zoubworldArduino/KiCad_PersoLibrary/SparkFun-KiCad-Libraries-main/SparkFun_GNSS_LG290P_Breakout_3D.png

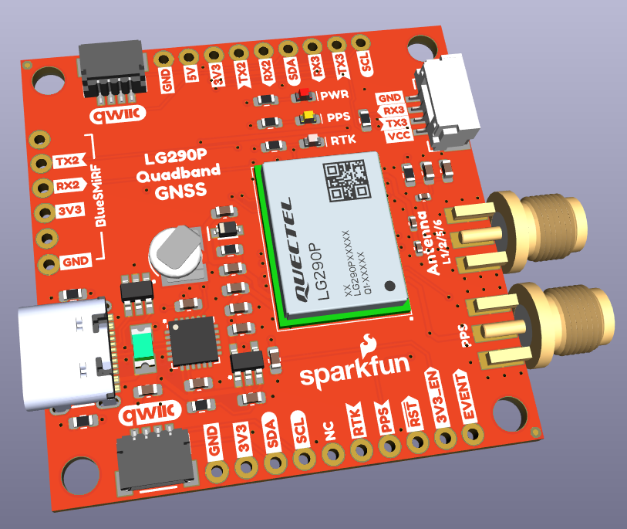
SparkFun-KiCad-Libraries-main/SparkFun_GNSS_LG290P_Breakout_3D.png
