zoubworldArduino/KiCad_PersoLibrary/README.md

# KiCad_PersoLibrary
my personnal Kicad library

# KiCad
KiCad Projects

the data here are imported from several location, mainly :
https://www.ultralibrarian.com/
https://www.snapeda.com/
github and kicad.
