zoubworldArduino/KiCad_PersoLibrary/Zoub_Lib/ATWINC3400/MicrochipWirelessHardwareDesignChecklist_Rev-B.xlsx

Sheet: Checklist
Microchip Wireless Hardware Design Checklist
Introduction: This checklist is provided as a "Best Pratice" guide for your RF design. It can be used as-is or as part of our free design review service called WirelessCheck. If you would like use this value added service, please click here->. |  |  |  |  |  |  | Link to WirelessCheck (https://www.microchip.com/design-check-services)
Instructions for WirelessCheck Customers: Fill in "Customer" column for all checkpoints during the design phase and prior to requesting design review support from Microchip. While raising design review support request, attach the completed checklist along with the design files (Schematic, BoM, PCB Layout File, Gerber files). A Microchip Support Engineer will review and provide his/her comments in the "Microchip" column and communicate this back to you.
Instructions for as-is useage: Fill in "Customer" column for all checkpoints during the design phase. This will provide you with a checklist of typical areas of concern for your RF design and some suggestions on best practices from Microchip RF Engineers.
S.No. | Design Item | Description | Customer |  | Microchip |  | Customer
 |  |  | Verified (Yes/No/NA) | Comment if any | OK/NOT OK | Microchip Review Comments | Response for Review Comments
1 | General Considerations:
1.1 | Documentation | Did you refer the latest version of the documents for the design such as Silicon chip/Module datasheet, Errata and Reference/Evaluation kit design documents, chip-down collateral package (for chip-down design)?
1.2 | Device (Silicon Chip/Module) | Is the device ordering part number used in the design BoM verified?
1.3 | Reference Design File | Microchip Wireless Reference PCB design files will be mostly in Altium Tool format. Customer should convert into their other CAD tools if needed.
1.4 | Pin check | Is the pinout of the schematic logical symbol against the data sheet verified?
1.5 | Footprint Check | Is the PCB footprint of the silicon chip/module verified against the package outline drawing or recommended footprint/land pattern drawing detailed in the data sheet? It is recommended to use the same footprint as in the reference design.
2 | PCB Stack Up Considerations:
2.1 | PCB Stack up | Use the same PCB Layer Stackup as in the reference design. If in case following a different PCB layer stackup to meet the custom design requirement, confirm the following items before the start of the design • Check with PCB Fabrication Vendor for the manufacturability of the stackup. • Ensure to follow a good reference plane for RF ground and Digital/Analog Ground plane and other high speed design requirements. • Check the controlled trace impedance requirements for the design and get the required trace width and spacing details from the PCB Fabrication Vendor.
3 | Power Supply Considerations:
3.1 | Power Supply Pins | Do all the power pins connected to the correct supply rails in the design and it is within the required tolerance value as detailed in the datasheet?
3.2 | Power Supply Source | Is the power supply source clean without any noise? Note: It is recommended to use LDO. If you are using the switching regulator, ensure that the sufficient filtering are added to suppress the switching noise (ripple) on the power rail as it impacts the RF performance.
3.3 | Power Budgeting | Is the power budgeting performed to ensure the power source component capable to supply the required current to the circuit in all functional conditions?
3.4 | Power Trace | Is the power rail trace thickness/width selected appropriately based on the expected peak power consumption, with certain margin? Use a power trace calculator to find the minimum required trace width. PCB Trace Width Calculator (For Reference): https://www.desmith.net/NMdS/Electronics/TraceWidth.html
3.5 | Ground | Do the grounding specification followed as in the datasheet or in the corresponding silicon chip/module reference/evaluation design kit? It is preferred to use simple solid ground plane unless otherwise specified.
3.6 | Power Sequencing | Did you check the device (silicon/module) requires any specific power up/down sequencing in terms of the order and delays of the power supplies?
3.7 | Thermal Pad /Ground Paddle | Did you check whether the device (silicon chip/module) require thermal pad ground connection? Note: Ensure that an array of GND vias connecting the thermal pad to the ground plane has sufficient low impedance ground return path which provides a better ground to the device and also acts as thermal sink. Also, connect the GND pin to the GND Paddle for better grounding in addition to the separate ground via.
3.8 | Ferrite Beads | Did you verify whether the ferrite beads placed in the design as specified in the recommended power pins of the silicon chip/module? Note: Place the ferrite beads as close as possible to the power pin.
3.9 | Bulk Capacitors | Did you verify whether the recommended bulk capacitors placed on the power rails of the design? Refer the Datasheet and/or reference design document for the recommended values.
3.10 | Decoupling/Bypass Capacitors | Did you verify whether the recommended decoupling capacitors placed on each power pins in the design? Refer the Datasheet and/or reference design document for the recommended values. Note: Ensure that the decoupling capacitors are effective at Radio Frequencies. Many passive capacitors are self-resonant at RF, therefore review S21 plots and frequency response curves. It is recommended to use COG and avoid Y5V and Z5U dielectric type capacitors.
3.11 | Placement & Routing | a. Prioiritze the placement and routing in the following order, (i) RF Section (ii) Buck or Boost LC Section (iii) Clock Section (iv) High Speed Signals (v) Other Power Section (vi) and finally low priority section placement and signals. b. Did you place the decoupling capacitors close to the power pins for high-frequency noise filtering? Note: Refer "Reference" worksheet Image-1 for the recommended decap routing. c. Did you verify whether each Ground pin have at least one ground via? d. Did you place vias very close to the power pads to connect the power/ground pins to the power/ground plane? This helps in minimizing stray inductance and IR (voltage) drop on the power line. e. Did you place multiple vias when Power trace/island changes the plane for current distribution?
3.12 | Copper Pour | Did you eliminate Island (Unconnected or floating or Dead) Copper Pour amd peninsulas of copper pour? Note: Refer "Reference" worksheet, Image-3 and Image-4 to know more about Island/s and peninsula/s.
4 | Reset and Chip Enable Considerations:
4.1 | Reset | Did you verify the connection and pullup/pulldown recommendation for the RESET pin in the datasheet?
4.2 | Chip Enable | Did you verify the connection and pullup/pulldown recommendation for the Chip Enable pin in the datasheet?
5 | Clocking Considerations:
5.1 | Clock Source | Recommend to follow the same clock source part (Crystal/TCXO) as in the reference design. As the clock parameters directly impact the RF performancem, customer should understand the impact on the performance involved if using different clock source part.
5.2 | Clock Trace Routing | a. Are the clock traces routed away from RF signals? b. Are the guarding ground vias placed along the crystals and the clock traces?
6 | I/O's:
6.1 | Pullups/Pulldowns | Are the recommended pullup and pulldown resistors placed on the I/O's with the suggested values as listed in the datasheet or reference design?
6.2 | Application Interface | Are the mandatory interfaces connected to communicate with the device (silicon chip/module) for the end application requirement?
6.3 | Impedance controlled trace | Is the impedance control requirement verified? Note: Unless otherwise stated, the single ended trace impedance should be 50Ω , differential trace impedance of USB should be 90Ω and other differential trace impedance should be 100Ω. Refer Device Datasheet and its design guide. Use an impedance calculator to calculate the trace width for a specific trace impedance. Check with fab house to optimize the materials and controlled impedance. Request for a TDR (Time Domain Reflectometry) test to the PCB fabricator for QA.
6.4 | Signal integrity | Did you complete the Signal integrity check such as, trace length match, impedance control requirements, proper termination requirement for the critical highspeed signals? Refer the reference kit design document for cross verification.
6.5 | Debug Interface | Did you check the required programming and debug interfaces like JTAG,SW? Ensure to expose the traces for debug.
6.6 | Test Interface | Did you check whether any dedicated test interface requires to communicate with the RF transceiver to perform RF level test such as, continuous Tx, Rx with Tx power control, channel selection, data rate selection for RF Validation, Regulatory Certification, and Production testing?
6.7 | Unused pins | Does all unused inputs terminated as recommened in datasheet?. Refer the evaluation kit design document and datasheet guidance.
6.8 | Test coverage | Did you check whether every (maximum possible) trace have a touch-down point (open solder mask on the via or some passive component pads apart from IC pads) for continuity testing in PCB manufacturing?
7 | RF Design Considerations:
7.1 | Module Based Designs - RF Design Considerations:
7.1.1 | Module Placement | Is the module placed in the base board as per the datasheet recommendation for best RF performance case? Refer "Reference" worksheet -> FCC KDB : Reference-1 for the FCC Guidance
7.1.2 | Mechanical Cutout/Slot | Did you verify the host board for mechanical cut out/slot area requirement? Refer module datasheet recommendation.
7.1.3 | Electrical Keep out Area | Did you check the host board copper keep out area requirement for the Top placement layer and all other PCB layers? Refer the module datasheet for the recommendation. Note: Ensure that no traces/metal structures are placed under antennas.
7.1.4 | GND Shielding and Stitching Vias | Are the sufficient GND area, fences/stitching vias for RF traces placed? Refer "Reference" worksheet Image-2 for the proper "via" stitching fences.
7.1.5 | Clearance | Is the minimum clearance requirement verified? • Antenna on the module must not be placed in direct contact or close proximity to plastic casing/objects. • Do not enclose the antenna within a metal structure.
7.1.6 | External Antenna (Applicable for only a module with external antenna connector) | Did you use the same antenna as specified in the Microchip Module certification test report? Note: If different antenna is preferred to use, refer to Q&A especially section III, B, C and D of FCC KDB (https://apps.fcc.gov/oetcf/kdb/forms/FTSSearchResultPage.cfm?switch=P&id=39060) for to use the Microchip regulatory compliance certification of the module.
7.2 | Chip-down Based Designs -RF Design Considerations:
7.2.1 | RF Front End Components and PCB layout. | Did you use the same RF front end design as specified in the reference design (Module design/Evaluation Kit)? Note: It is recommended to use the RF front end components and PCB Layout "AS IS" in the reference design (Module design/Evaluation Kit) to achieve the target RF Performance. Any deviation leads to degradation in RF performance.
7.2.2 | RF trace - Impedance control | Is the impedance control requirement verified for RF traces? Note: Unless otherwise stated, all the single ended RF trace impedance should be 50Ω and differential RF trace impedance should be 100Ω. Refer Device Datasheet and its design guide.
7.2.3 | Balun | Did you use the same balun circuitry as in reference design (Module design/Reference kit)? Note: All RF currents flow though the Balun. Make sure balun ground connections are solid.
7.2.4 | Filtering | Did you follow the same filtering circuitry as in reference design (Module design/Reference kit)? Note: It is recommended to use High-quality passive components in the RF signal chain and filtering.
7.2.5 | Antenna | Is the same antenna as in reference design (Module design/Reference kit) used? Note: The antenna can be either PCB antenna or Chip Antenna or some external antenna such as U.FL Antenna, SMA antenna. Customer can use different antenna but ensure that it matches the frequency requirement of the radio transceiver, proper antenna length relative to wavelength used for good radiation efficiency, radiation pattern and other antenna parameters. Using different antenna might lead to the degradation of the overall system RF performance when compared to the module.
7.2.6 | Antenna Matching Circuitry | Did you follow the same antenna matching circuitry as in reference design (Module design/Reference kit)? Note: Impedance matching components helps to achieve maximum power transfer from the Transmitter by reducing mismatch loss.
7.2.7 | RF Test Point | Did you use the RF Coax probe point (test point or connector such as U.FL or SMA or RF switch connector) to perform conducted testing in the regulatory and production test?
7.2.8 | RF Shield | Does your design includes RF Metal Shield? Note: If the design does not have RF metal shield, ensure that at least the design has a placeholder for the RF shield which covers the chip and its related components. This EMI/RF Shield is to ensure compliance to Emission and Immunity rules.
7.2.9 | RF Clearance | a. Did you verify the clearance requirement between the following? - RF Shield and other components - RF Shield and PCB edge b. Did you verify the vertical clearance of archway over RF transmission lines?
7.2.10 | Electrical Keep out Area | Did you check the antenna specification requirement for the copper keep out area requirement for Top PCB layer and all other PCB layers?
7.2.11 | GND Shielding and Stitching Vias | Did you place the sufficient GND area, fences/stitching vias for RF traces? Refer "Reference" worksheet Image-2 for the recommended "via" stitching fences.
8 | Miscellaneous
8.1 | Keep out Clearance | Is keep-out areas free from stickers, metal symbol and QA marks?
8.2 | Labeling | Does the design has a designated label area? Note: Label lead-time can be very long.
8.3 | Netlist comparison | Is a manual netlist check is run against the schematic? Note: This netlist check helps to identify the typos and accidental disconnects.
8.4 | CAD DRC Check | Does CAD DRC check is run to review/resolve all the DRC errors?
8.5 | CAD layer view | Is explicit (positive image view) style used for the GND and Power planes? Note: Avoid invisible implicit (negative image view) ground style.

Sheet: Reference
Image-1: | Decap Placement and Routing Recommendation
Image-2: | Recommended "Via" Stitching Fences
Image-3: | Unconnected or floating or Dead Copper Pour (Island)
Image-4: | Copper Pour - Peninsula
FCC KDB : Reference-1
KDB Publication 996369: FCC Link : https://apps.fcc.gov/oetcf/kdb/forms/FTSSearchResultPage.cfm?switch=P&id=44637 Question: What is the FCC guidance for equipment authorization of transmitter module devices, and equipment that incorporates transmitter modules? Answer: 996369 D01 Module Certification Guide v02. Provides guidance for equipment authorization applications for modular transmitters per Section 15.212. 996369 D02 Module Q&A v01. Provides additional guidance in a question and answer format. 996369 D03 OEM Manual v01 — Guidance for instructions provided by grantees to host manufacturers. * 996369 D04 Module Integration Guide v01. Guidance to host manufacturers for integrating modules into their products. Attachment List: 996369 D01 Module Certification Guide v02 996369 D02 Module Q&A v01 996369 D03 OEM Manual v01 996369 D04 Module Integration Guide v01 FCC expects all integrators to do a small subset of testing to ensure their use of the Module does not exceed FCC limits/requirements.

Sheet: Revision History
Revision History
Revision | Change Description | Date
A | Initial Released Revision | 2018-11-20
B | Included information about WirelessCheck and implemented improvements on the checkpoints | 2020-07-15
