zoubworldArduino/KiCad_PersoLibrary/Raspberry_Pi_Pico_W_Kicad_Files-main/images for README/KiCad 6 symbol libraries.png

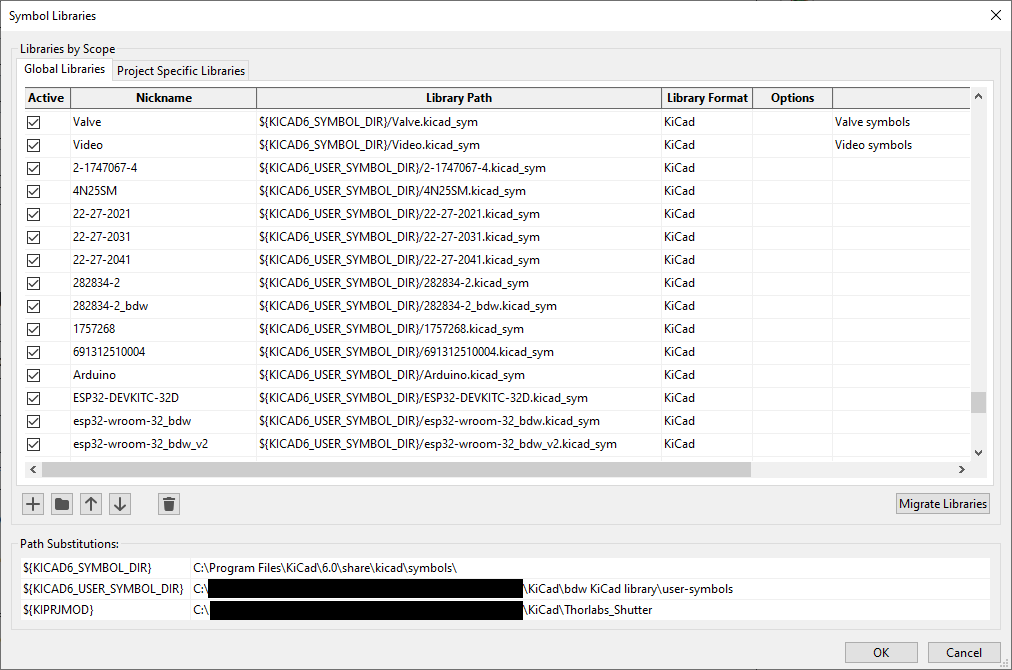
Raspberry_Pi_Pico_W_Kicad_Files-main/images for README/KiCad 6 symbol libraries.png
