zoubworldArduino/KiCad_PersoLibrary/Raspberry_Pi_Pico_W_Kicad_Files-main/images for README/Pico W 3D view.png

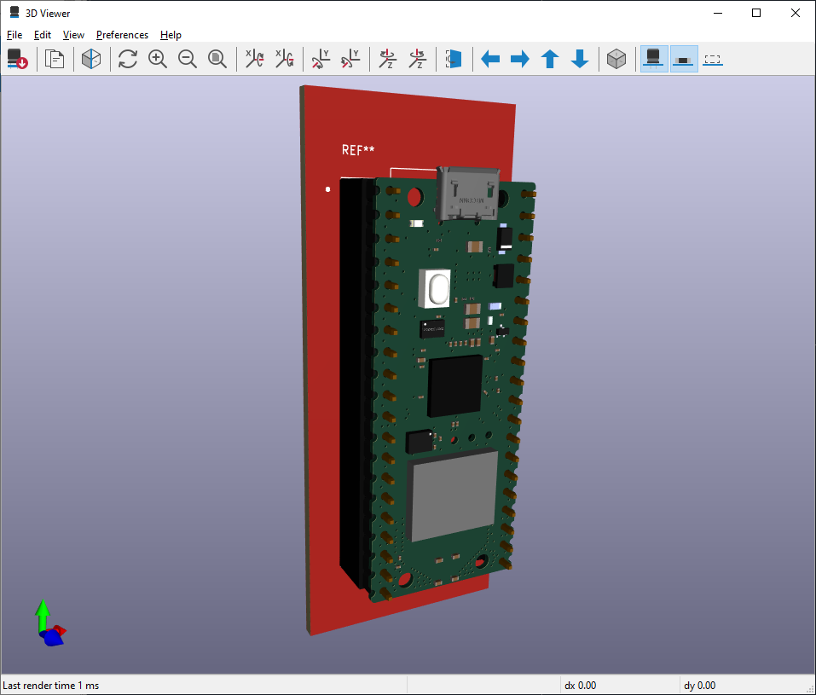
Raspberry_Pi_Pico_W_Kicad_Files-main/images for README/Pico W 3D view.png
