zoubworldArduino/KiCad_PersoLibrary/Zoub_Lib/USB-c/USB_Type-C_receptacle_pinout.svg.png

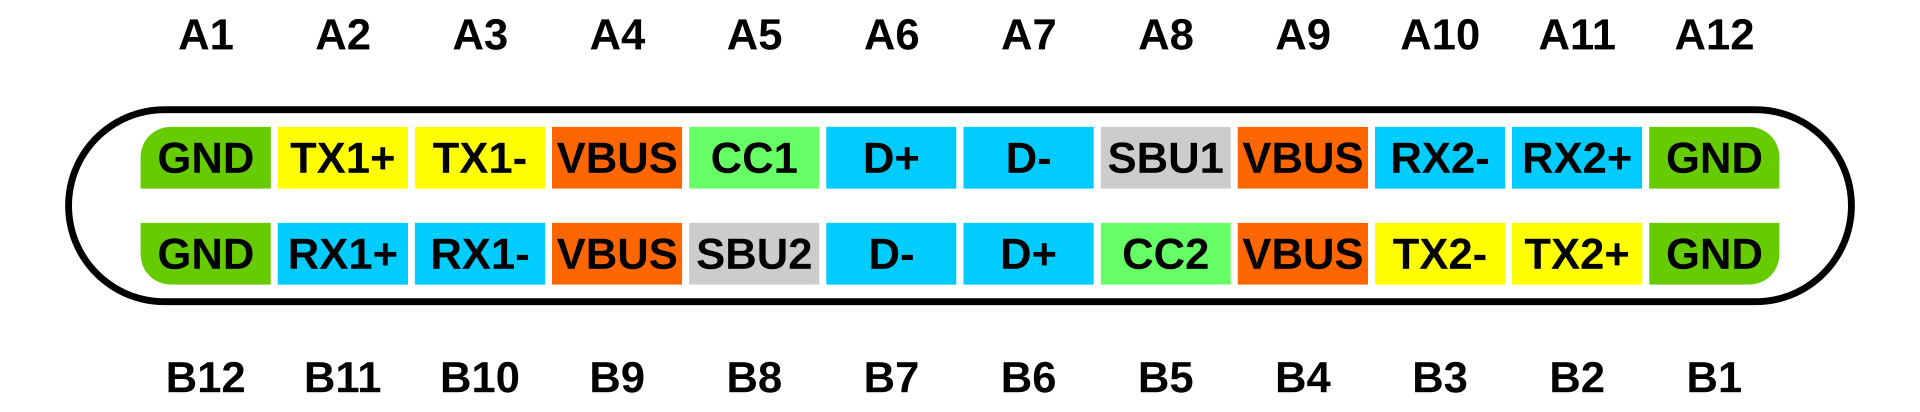
Zoub_Lib/USB-c/USB_Type-C_receptacle_pinout.svg.png
