zoubworldArduino/KiCad_PersoLibrary/SparkFun-KiCad-Libraries-main/Footprints/SparkFun-3D-models/Battery/XH414H-IV01E.STEP

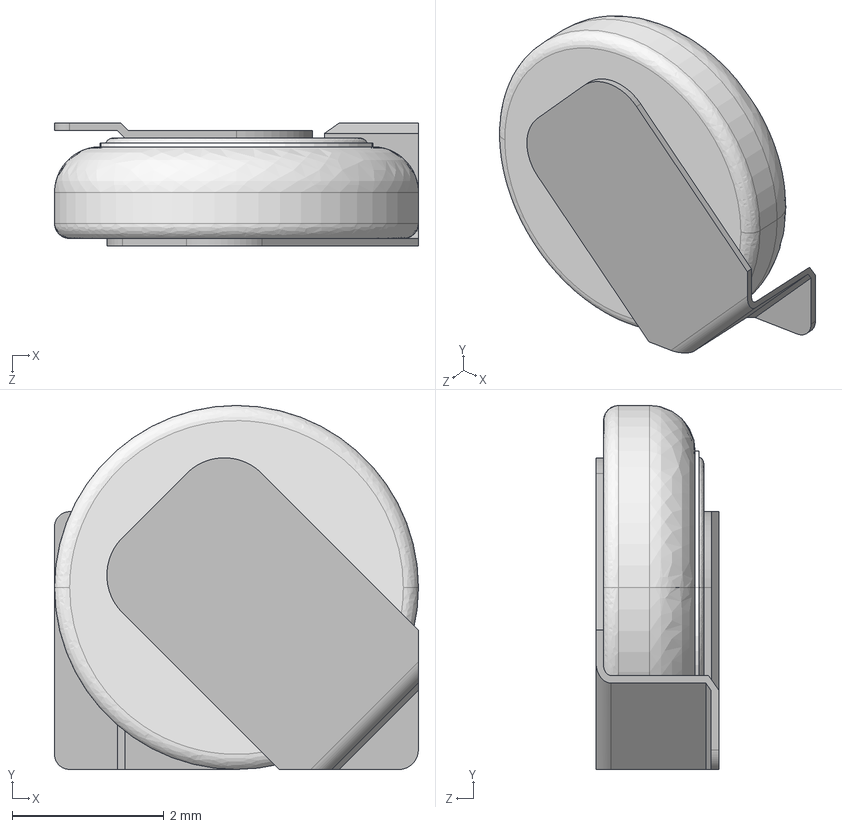
[picture p12: CAD file, 2025-12-28]
SparkFun-KiCad-Libraries-main/Footprints/SparkFun-3D-models/Battery/XH414H-IV01E.STEP
4.80 x 4.80 x 1.63 mm
isolator
cleme
Anode
Negative
Positive
