zoubworldArduino/KiCad_PersoLibrary/SparkFun-KiCad-Libraries-main/Footprints/SparkFun-3D-models/Camera/HM01B0.step

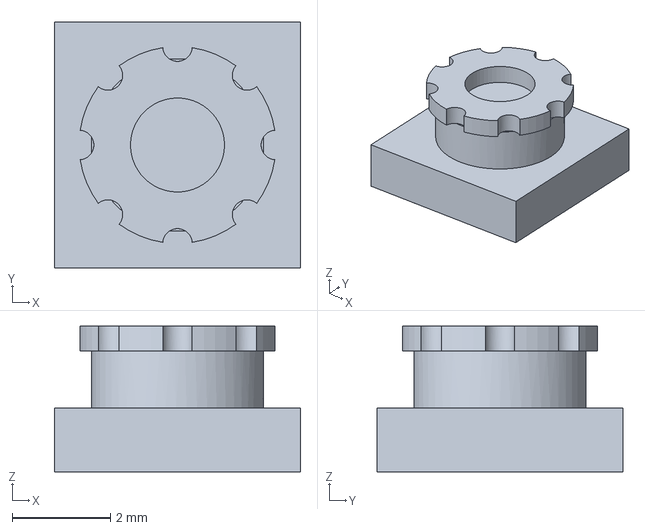
[picture p13: CAD file, 2025-12-28]
SparkFun-KiCad-Libraries-main/Footprints/SparkFun-3D-models/Camera/HM01B0.step
5.00 x 5.00 x 2.96 mm
