zoubworldArduino/KiCad_PersoLibrary/SparkFun-KiCad-Libraries-main/Footprints/SparkFun-3D-models/Capacitor/CP_EIA-3528-21_Vishay-B.step

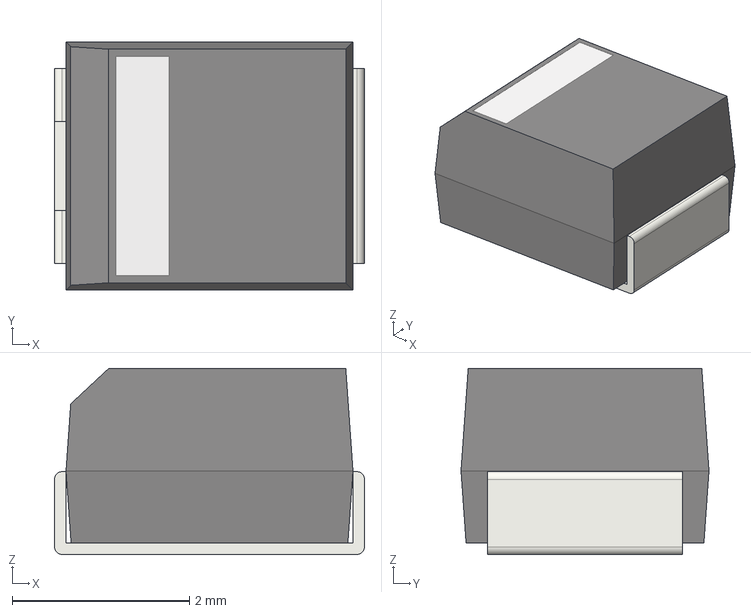
[picture p14: CAD file, 2025-12-28]
SparkFun-KiCad-Libraries-main/Footprints/SparkFun-3D-models/Capacitor/CP_EIA-3528-21_Vishay-B.step
3.50 x 2.80 x 2.10 mm
