zoubworldArduino/KiCad_PersoLibrary/SparkFun-KiCad-Libraries-main/Footprints/SparkFun-3D-models/Clock/Crystal_SMD_3.2x1.5mm.step

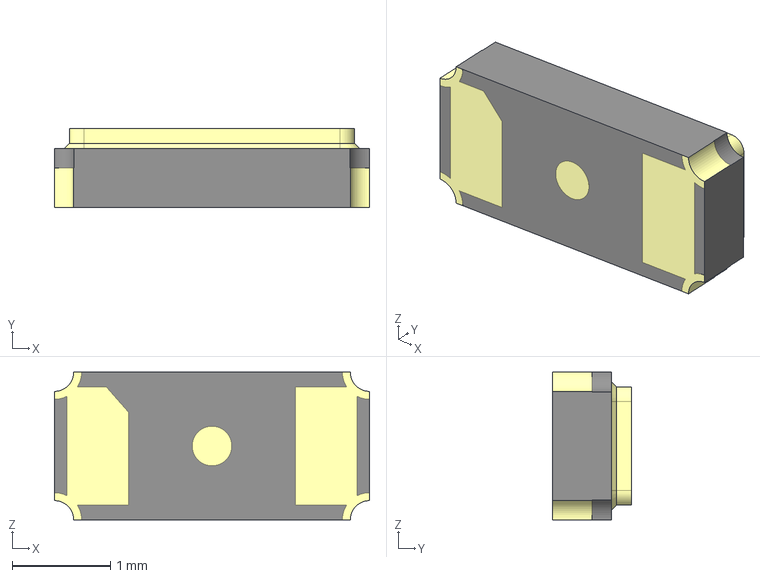
[picture p15: CAD file, 2025-12-28]
SparkFun-KiCad-Libraries-main/Footprints/SparkFun-3D-models/Clock/Crystal_SMD_3.2x1.5mm.step
3.20 x 0.801 x 1.50 mm
