zoubworldArduino/KiCad_PersoLibrary/SparkFun-KiCad-Libraries-main/Footprints/SparkFun-3D-models/Coil/Inductor_7.3x6.6mm.stp

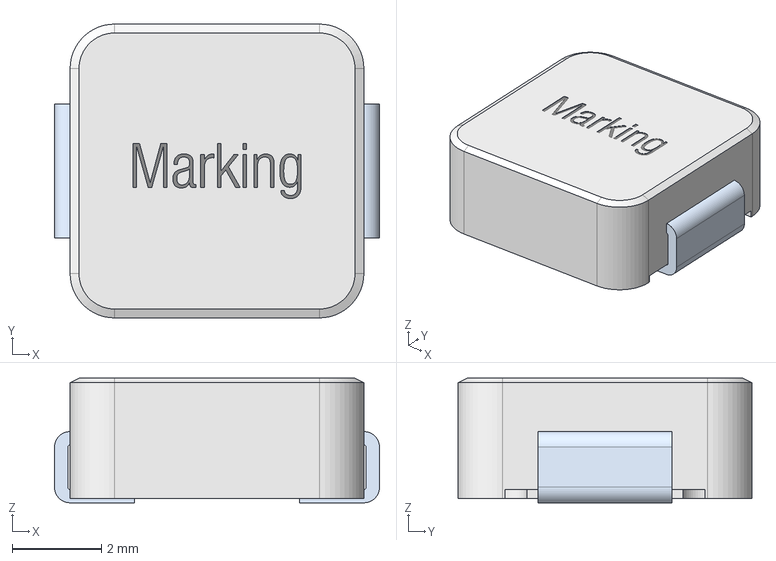
[picture p16: CAD file, 2025-12-28]
SparkFun-KiCad-Libraries-main/Footprints/SparkFun-3D-models/Coil/Inductor_7.3x6.6mm.stp
7.30 x 6.60 x 2.80 mm
