zoubworldArduino/KiCad_PersoLibrary/SparkFun-KiCad-Libraries-main/Footprints/SparkFun-3D-models/Connector/FPC_0.5mm-22.step

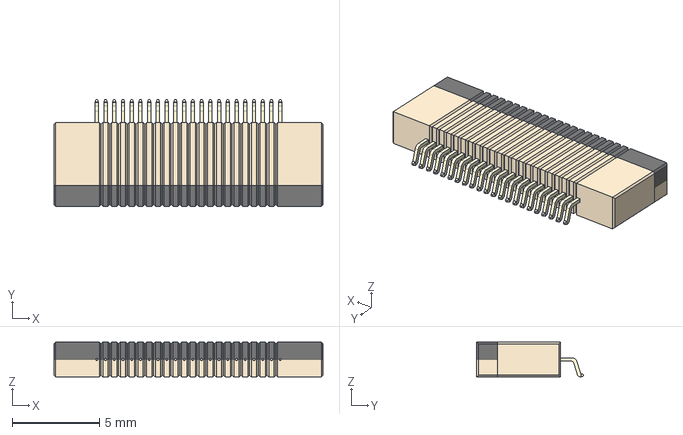
[picture p17: CAD file, 2025-12-28]
SparkFun-KiCad-Libraries-main/Footprints/SparkFun-3D-models/Connector/FPC_0.5mm-22.step
15.4 x 6.10 x 2.00 mm
