zoubworldArduino/KiCad_PersoLibrary/SparkFun-KiCad-Libraries-main/Footprints/SparkFun-3D-models/Display/1.5in OLED.step

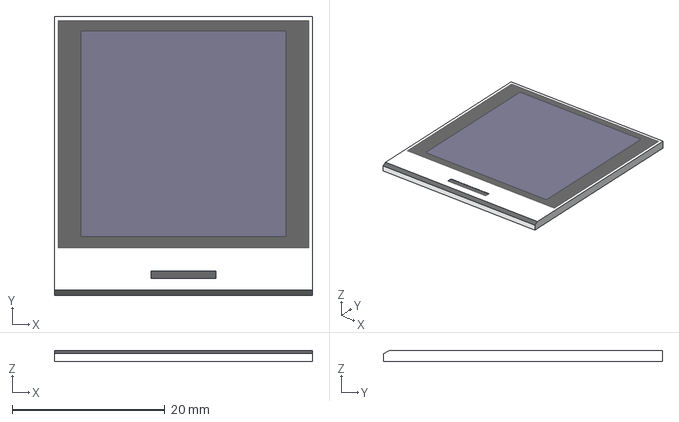
[picture p18: CAD file, 2025-12-28]
SparkFun-KiCad-Libraries-main/Footprints/SparkFun-3D-models/Display/1.5in OLED.step
33.8 x 36.5 x 1.41 mm
