zoubworldArduino/KiCad_PersoLibrary/SparkFun-KiCad-Libraries-main/Footprints/SparkFun-3D-models/Electromechanical/Relay_7.5x12.5mm.step

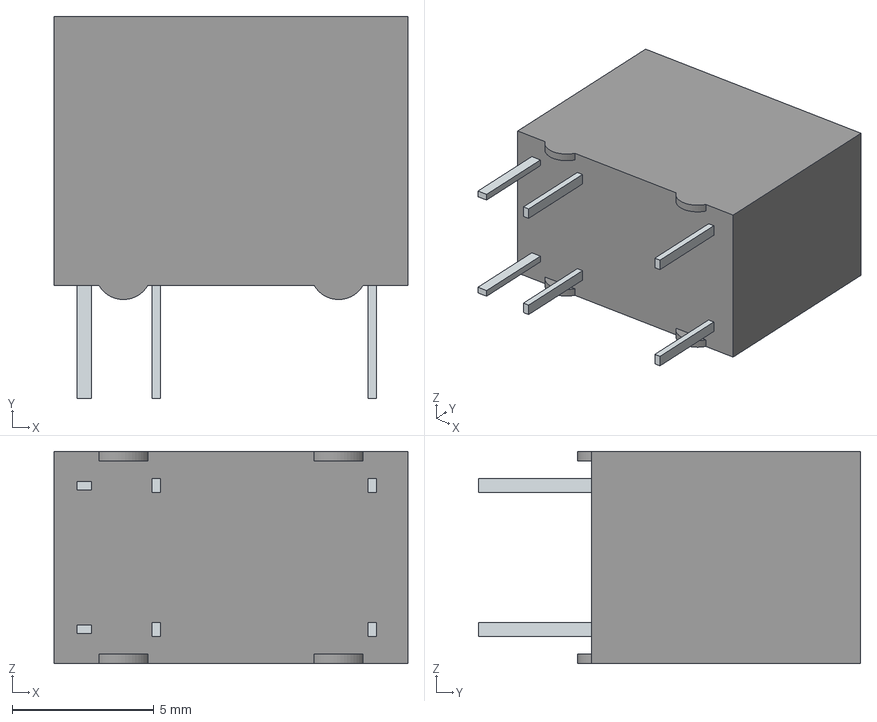
[picture p19: CAD file, 2025-12-28]
SparkFun-KiCad-Libraries-main/Footprints/SparkFun-3D-models/Electromechanical/Relay_7.5x12.5mm.step
12.5 x 13.5 x 7.50 mm
