zoubworldArduino/KiCad_PersoLibrary/SparkFun-KiCad-Libraries-main/Footprints/SparkFun-3D-models/Fuse/Fuse_1206_3216Metric.step

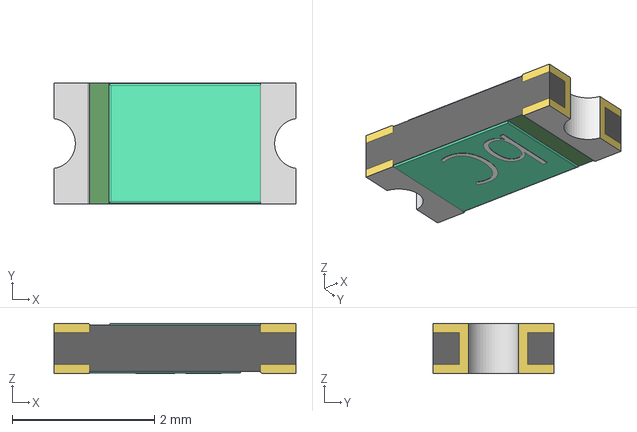
[picture p20: CAD file, 2025-12-28]
SparkFun-KiCad-Libraries-main/Footprints/SparkFun-3D-models/Fuse/Fuse_1206_3216Metric.step
3.40 x 1.70 x 0.704 mm
