zoubworldArduino/KiCad_PersoLibrary/SparkFun-KiCad-Libraries-main/Footprints/SparkFun-3D-models/GPS/u-blox_SAM-M8Q.STEP

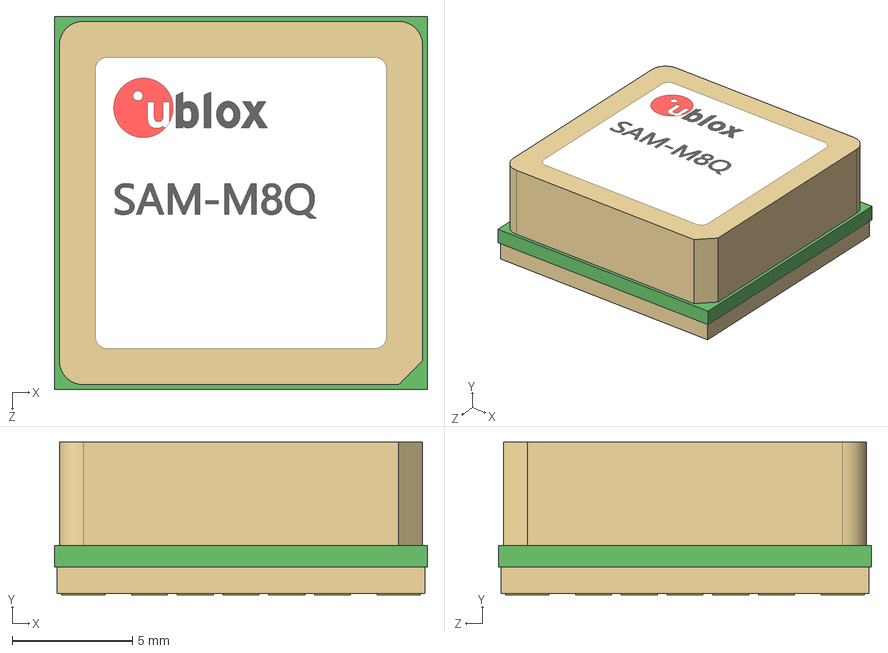
[picture p21: CAD file, 2025-12-28]
SparkFun-KiCad-Libraries-main/Footprints/SparkFun-3D-models/GPS/u-blox_SAM-M8Q.STEP
15.5 x 6.35 x 15.5 mm
