zoubworldArduino/KiCad_PersoLibrary/SparkFun-KiCad-Libraries-main/Footprints/SparkFun-3D-models/LED/FreeCAD/LED_5MM/LED_5MM-RED.step

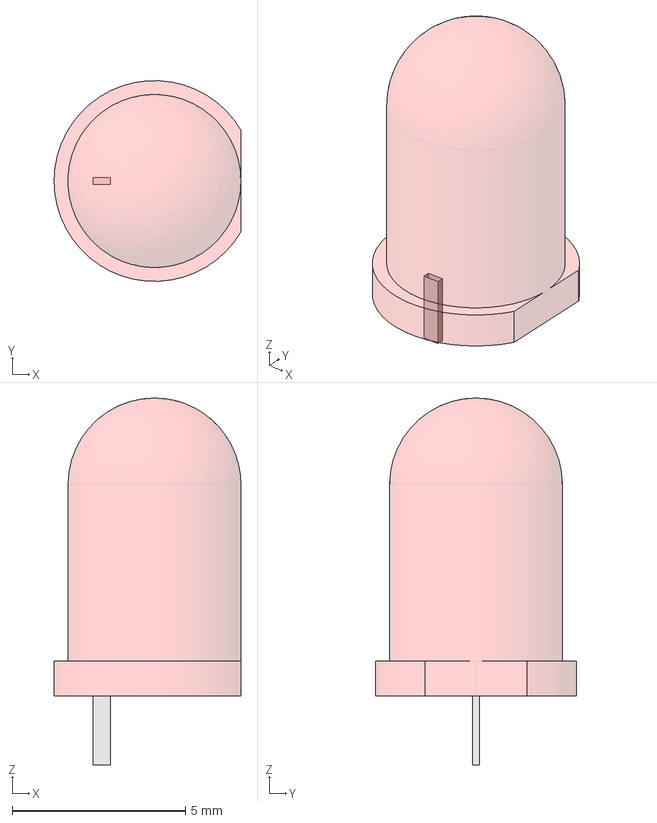
[picture p22: CAD file, 2025-12-28]
SparkFun-KiCad-Libraries-main/Footprints/SparkFun-3D-models/LED/FreeCAD/LED_5MM/LED_5MM-RED.step
5.40 x 5.79 x 10.6 mm
