zoubworldArduino/KiCad_PersoLibrary/SparkFun-KiCad-Libraries-main/Footprints/SparkFun-3D-models/LED/LED_0402_1005Metric_Yellow.step

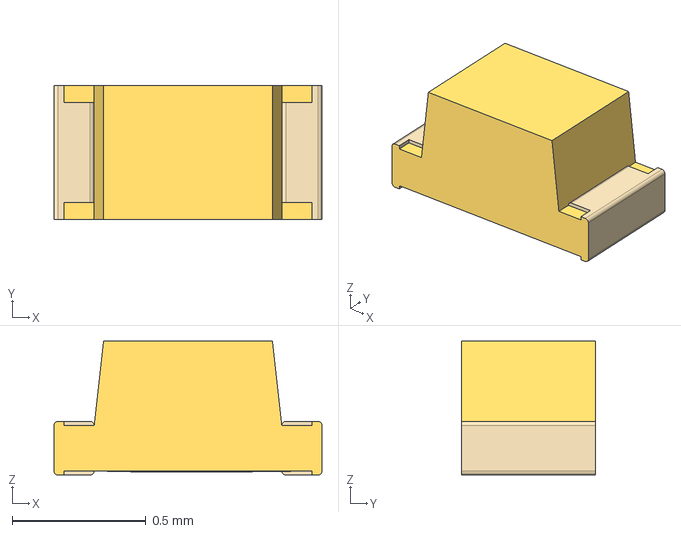
[picture p23: CAD file, 2025-12-28]
SparkFun-KiCad-Libraries-main/Footprints/SparkFun-3D-models/LED/LED_0402_1005Metric_Yellow.step
1.00 x 0.5 x 0.5 mm
