zoubworldArduino/KiCad_PersoLibrary/SparkFun-KiCad-Libraries-main/Footprints/SparkFun-3D-models/Resistor/Trimpot_SMD_3.0x3.0mm.step

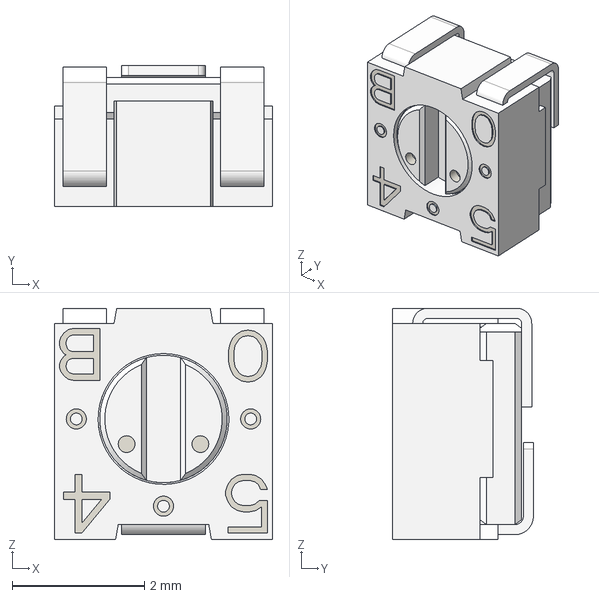
[picture p24: CAD file, 2025-12-28]
SparkFun-KiCad-Libraries-main/Footprints/SparkFun-3D-models/Resistor/Trimpot_SMD_3.0x3.0mm.step
3.30 x 2.13 x 3.51 mm
