zoubworldArduino/KiCad_PersoLibrary/SparkFun-KiCad-Libraries-main/Footprints/SparkFun-3D-models/RF/GNSS_Ceramic_Antenna_18.0x18.0mm.step

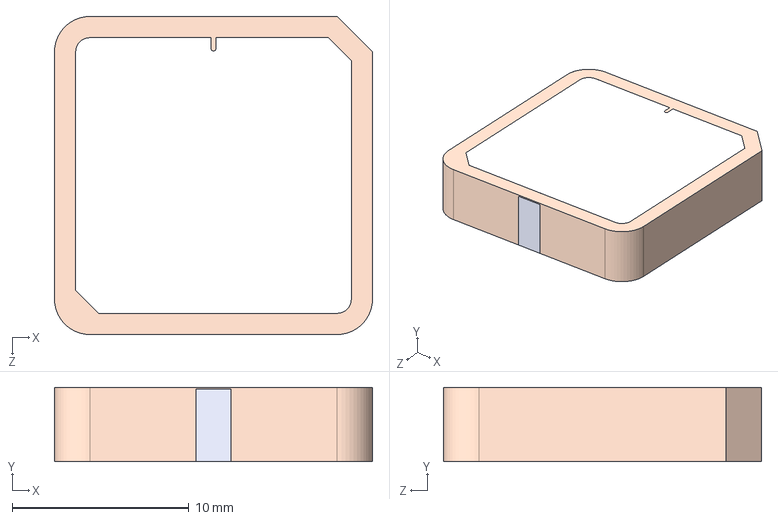
[picture p25: CAD file, 2025-12-28]
SparkFun-KiCad-Libraries-main/Footprints/SparkFun-3D-models/RF/GNSS_Ceramic_Antenna_18.0x18.0mm.step
18.0 x 4.20 x 18.0 mm
