zoubworldArduino/KiCad_PersoLibrary/SparkFun-KiCad-Libraries-main/Footprints/SparkFun-3D-models/Semiconductor-Nonstandard/Ag9200.step

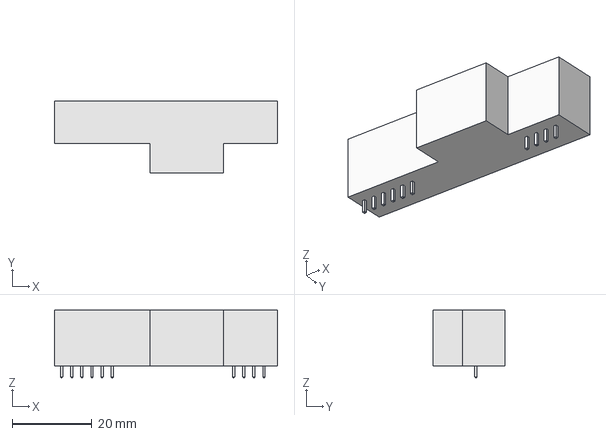
[picture p26: CAD file, 2025-12-28]
SparkFun-KiCad-Libraries-main/Footprints/SparkFun-3D-models/Semiconductor-Nonstandard/Ag9200.step
56.0 x 18.0 x 17.0 mm
