zoubworldArduino/KiCad_PersoLibrary/SparkFun-KiCad-Libraries-main/Footprints/SparkFun-3D-models/Semiconductor-Standard/QFN-16-1EP_3x3mm_P0.5mm_EP1.8x1.8mm.step

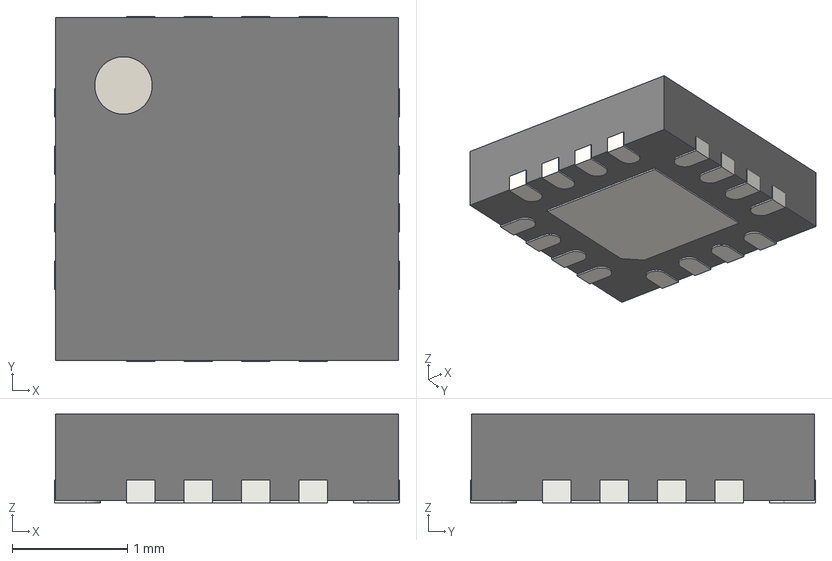
[picture p27: CAD file, 2025-12-28]
SparkFun-KiCad-Libraries-main/Footprints/SparkFun-3D-models/Semiconductor-Standard/QFN-16-1EP_3x3mm_P0.5mm_EP1.8x1.8mm.step
3.00 x 3.00 x 0.77 mm
