zoubworldArduino/KiCad_PersoLibrary/SparkFun-KiCad-Libraries-main/Footprints/SparkFun-3D-models/Sensor/SHTC3.STEP

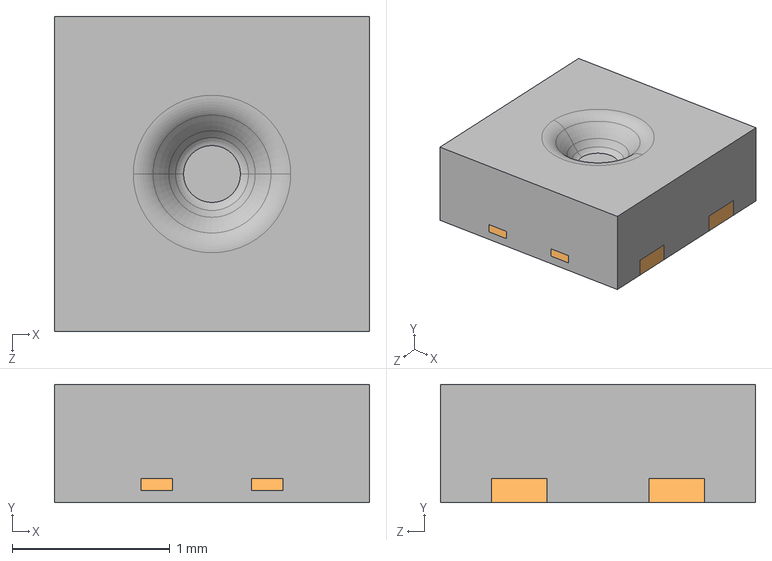
[picture p28: CAD file, 2025-12-28]
SparkFun-KiCad-Libraries-main/Footprints/SparkFun-3D-models/Sensor/SHTC3.STEP
2.00 x 0.75 x 2.00 mm
