zoubworldArduino/KiCad_PersoLibrary/SparkFun-KiCad-Libraries-main/Footprints/SparkFun-3D-models/Switch/Push_SMD_6.2x6.2mm_h7.0mm.step

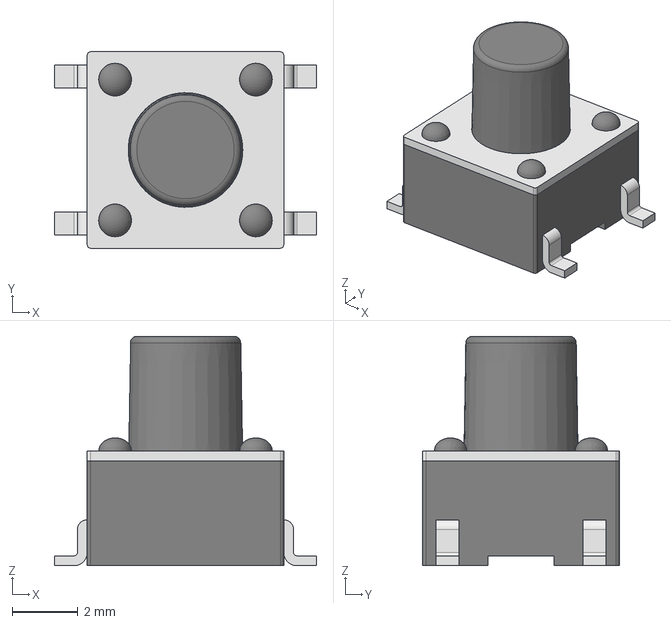
[picture p29: CAD file, 2025-12-28]
SparkFun-KiCad-Libraries-main/Footprints/SparkFun-3D-models/Switch/Push_SMD_6.2x6.2mm_h7.0mm.step
8.00 x 6.00 x 7.00 mm
