zoubworldArduino/KiCad_PersoLibrary/Zoub_Lib/ATSAMC21N18A-ANT/ATSAMC21N18A-ANT.step

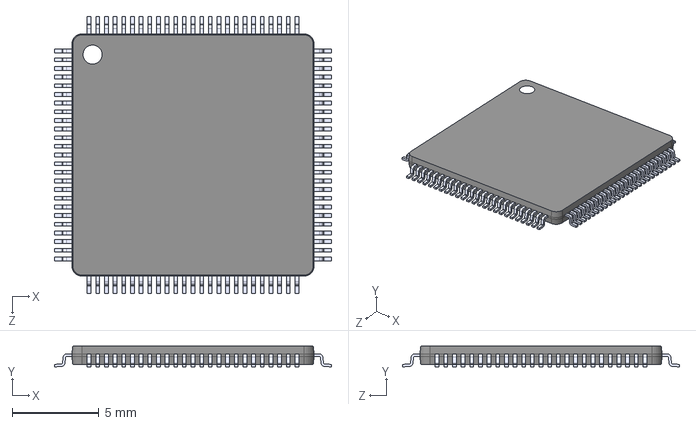
[picture p30: CAD file, 2025-12-28]
Zoub_Lib/ATSAMC21N18A-ANT/ATSAMC21N18A-ANT.step
16.0 x 1.20 x 16.0 mm
