zoubworldArduino/KiCad_PersoLibrary/Zoub_Lib/ATSAMD21J18A-MU/ATSAMD21J18A-MU.step

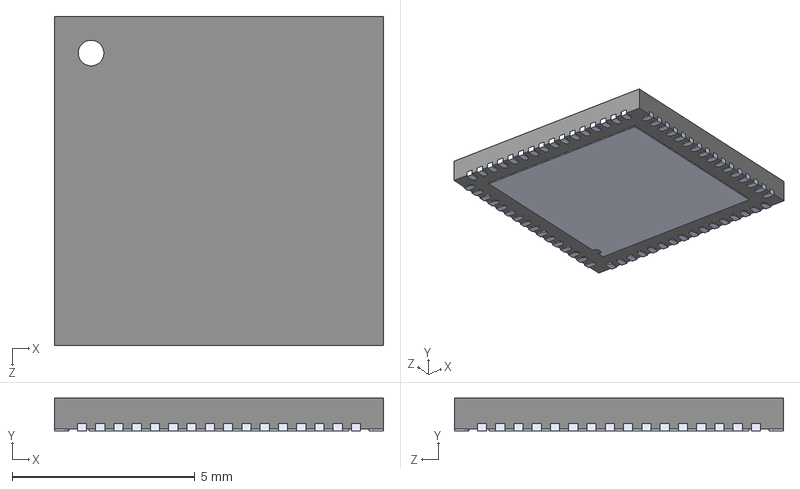
[picture p31: CAD file, 2025-12-28]
Zoub_Lib/ATSAMD21J18A-MU/ATSAMD21J18A-MU.step
9.00 x 0.9 x 9.00 mm
