zoubworldArduino/KiCad_PersoLibrary/Zoub_Lib/data/SST25VF010A-33-4C-SAE-T/SST25VF010A-33-4C-SAE-T.step

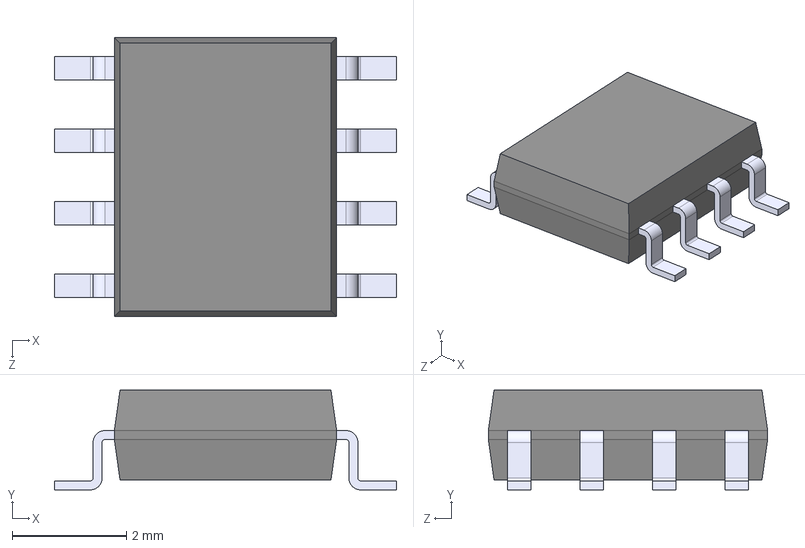
[picture p32: CAD file, 2025-12-28]
Zoub_Lib/data/SST25VF010A-33-4C-SAE-T/SST25VF010A-33-4C-SAE-T.step
6.00 x 1.75 x 4.90 mm
