zoubworldArduino/KiCad_PersoLibrary/Zoub_Lib/data/SST26VF064B-104V_MF/SST26VF064B-104V_MF.step

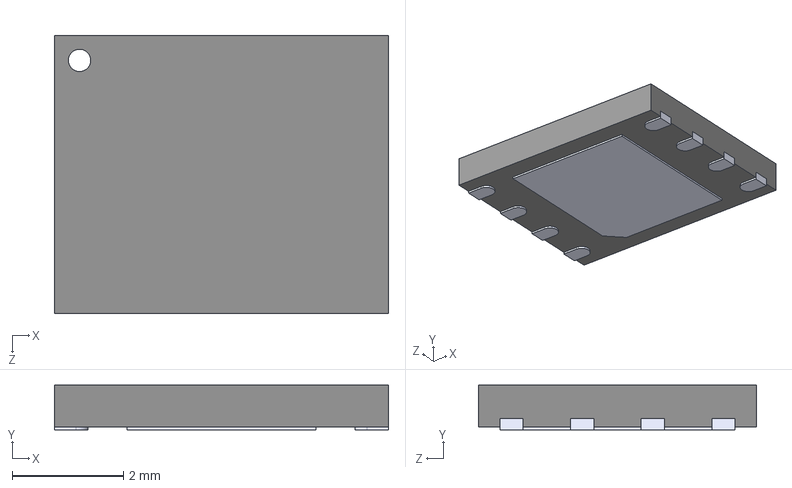
[picture p33: CAD file, 2025-12-28]
Zoub_Lib/data/SST26VF064B-104V_MF/SST26VF064B-104V_MF.step
6.00 x 0.8 x 5.00 mm
