zoubworldArduino/KiCad_PersoLibrary/Zoub_Lib/data/SST26VF064B-104V_MN/SST26VF064B-104V_MN.step

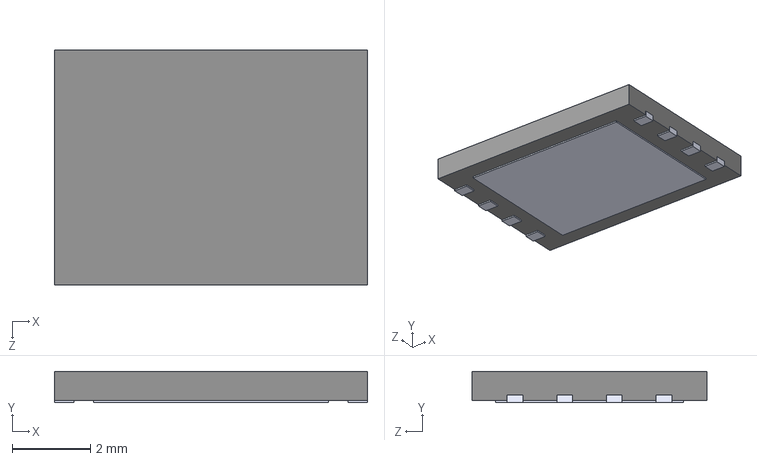
[picture p34: CAD file, 2025-12-28]
Zoub_Lib/data/SST26VF064B-104V_MN/SST26VF064B-104V_MN.step
8.00 x 0.8 x 6.00 mm
