zoubworldArduino/KiCad_PersoLibrary/Zoub_Lib/RN4678-VRM122/RN4678-V_RM100/RN4678-V_RM100.step

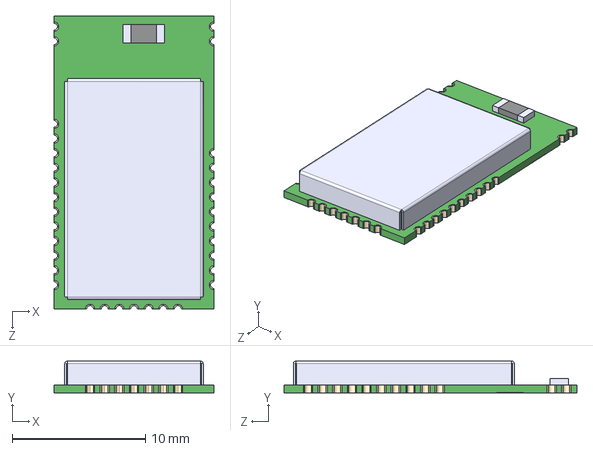
[picture p35: CAD file, 2025-12-28]
Zoub_Lib/RN4678-VRM122/RN4678-V_RM100/RN4678-V_RM100.step
12.0 x 2.40 x 22.0 mm
