zoubworldArduino/KiCad_PersoLibrary/Zoub_Lib/USB-c/MCP2200/MCP2200-I_MQ/MCP2200-I_MQ.step

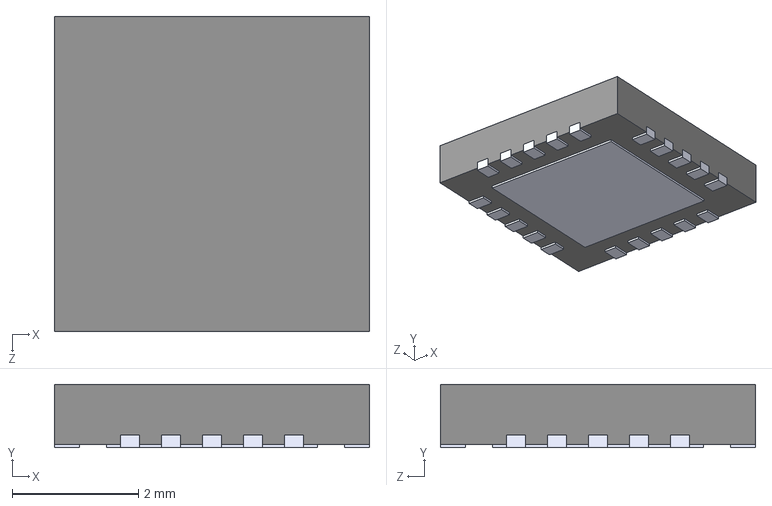
[picture p36: CAD file, 2025-12-28]
Zoub_Lib/USB-c/MCP2200/MCP2200-I_MQ/MCP2200-I_MQ.step
5.00 x 1 x 5.00 mm
