zoubworldArduino/KiCad_PersoLibrary/Zoub_Lib/USB-c/MCP2200/MCP2200-I_SS/MCP2200-I_SS.step

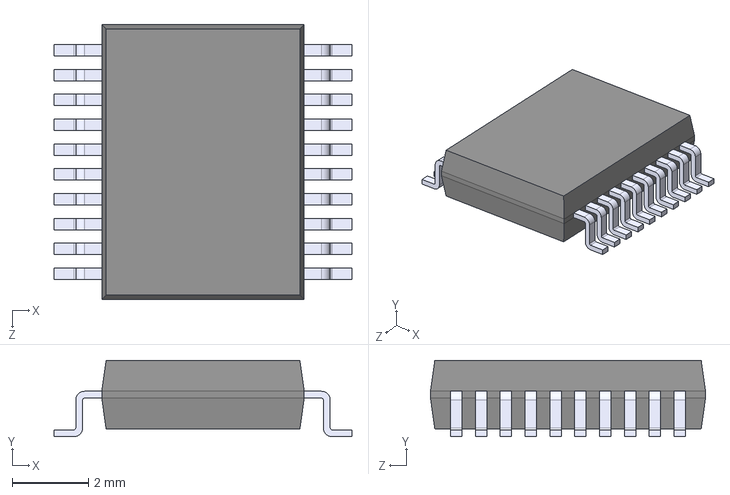
[picture p37: CAD file, 2025-12-28]
Zoub_Lib/USB-c/MCP2200/MCP2200-I_SS/MCP2200-I_SS.step
7.80 x 2.00 x 7.20 mm
