zoubworldArduino/KiCad_PersoLibrary/Zoub_Lib/WLR089U0/WLR089U0-I_RM/WLR089U0-I_RM.step

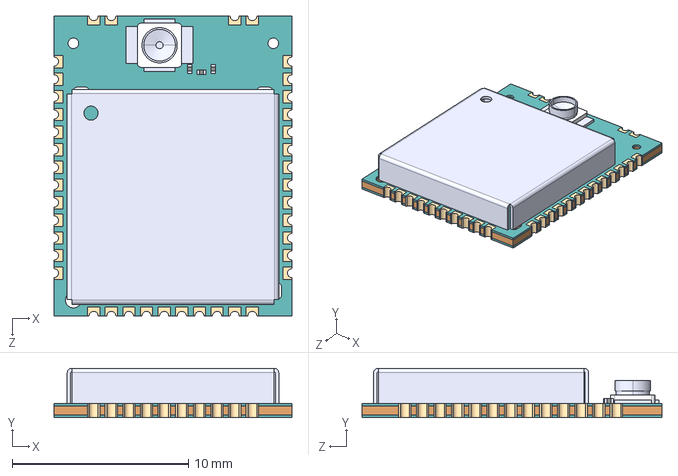
[picture p38: CAD file, 2025-12-28]
Zoub_Lib/WLR089U0/WLR089U0-I_RM/WLR089U0-I_RM.step
13.5 x 2.80 x 17.0 mm
