zoubworldArduino/KiCad_PersoLibrary/SparkFun-KiCad-Libraries-main/Footprints/SparkFun-3D-models/Capacitor/CP_Elec_8.0x10.2.stp

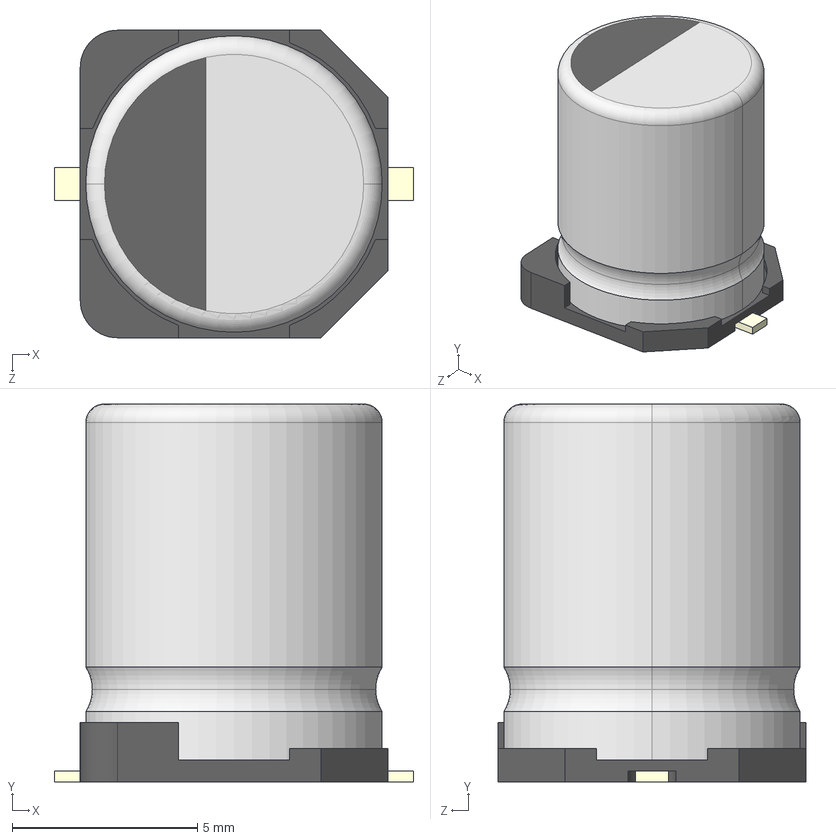
[picture p39: CAD file, 2025-12-28]
SparkFun-KiCad-Libraries-main/Footprints/SparkFun-3D-models/Capacitor/CP_Elec_8.0x10.2.stp
9.70 x 10.2 x 8.30 mm
標準SIZE CODE F-001
標準SIZE CODE F-002
標準SIZE CODE F-003 x 2
