zoubworldArduino/KiCad_PersoLibrary/SparkFun-KiCad-Libraries-main/Footprints/SparkFun-3D-models/Clock/Crystal_SMD_2.0x1.6mm.STEP

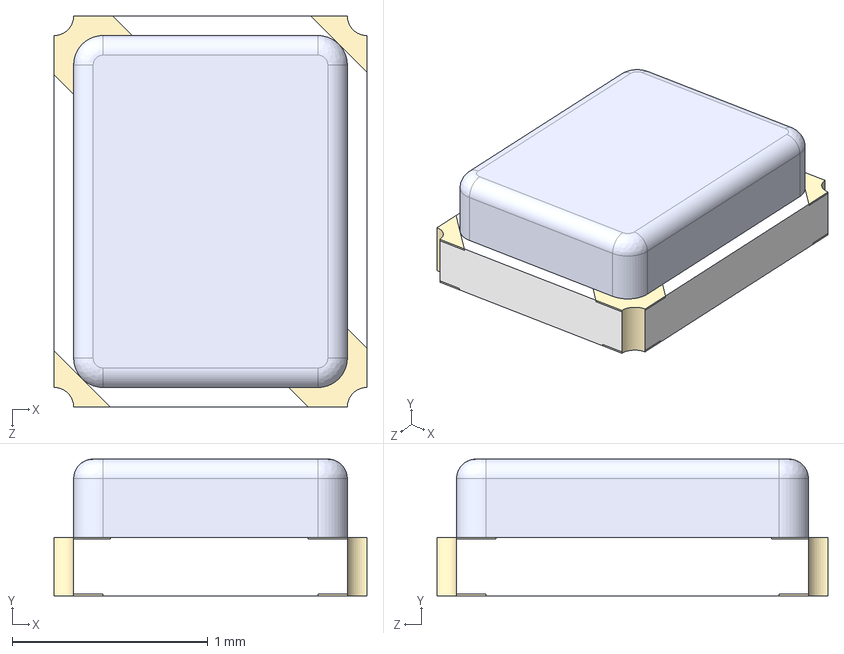
[picture p40: CAD file, 2025-12-28]
SparkFun-KiCad-Libraries-main/Footprints/SparkFun-3D-models/Clock/Crystal_SMD_2.0x1.6mm.STEP
1.60 x 0.7 x 2.00 mm
