zoubworldArduino/KiCad_PersoLibrary/SparkFun-KiCad-Libraries-main/Footprints/SparkFun-3D-models/Coil/Choke_100MHz_USB_RFCMF1220100M4T.stp

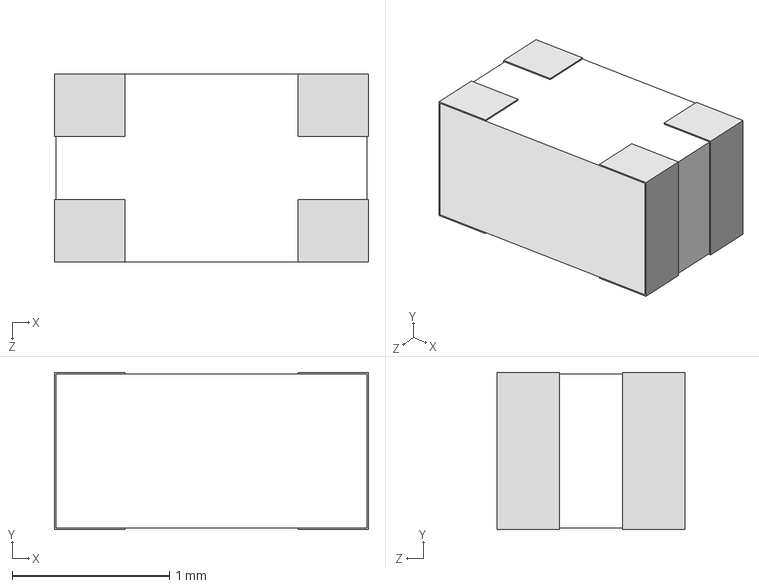
[picture p41: CAD file, 2025-12-28]
SparkFun-KiCad-Libraries-main/Footprints/SparkFun-3D-models/Coil/Choke_100MHz_USB_RFCMF1220100M4T.stp
2.00 x 1.00 x 1.20 mm
