zoubworldArduino/KiCad_PersoLibrary/SparkFun-KiCad-Libraries-main/Footprints/SparkFun-3D-models/Connector/FPC_0.5mm-22-Vertical.STEP

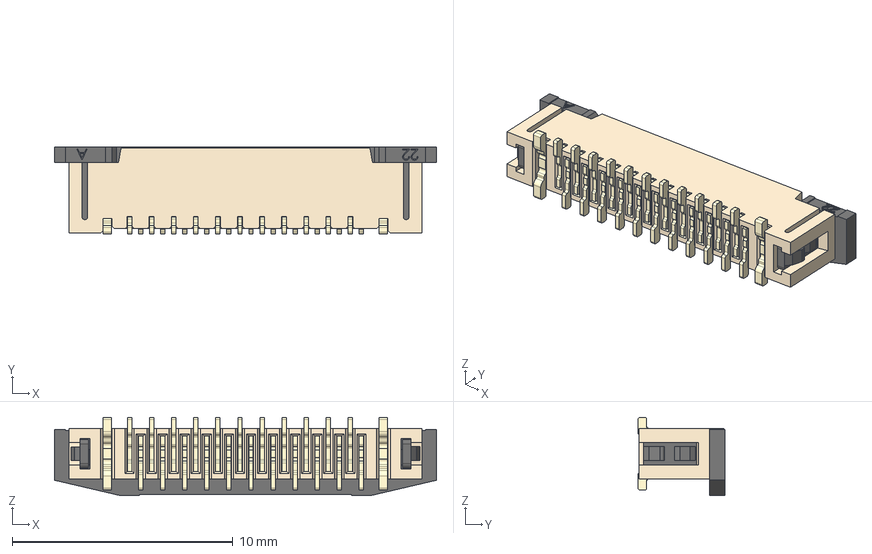
[picture p42: CAD file, 2025-12-28]
SparkFun-KiCad-Libraries-main/Footprints/SparkFun-3D-models/Connector/FPC_0.5mm-22-Vertical.STEP
17.3 x 3.95 x 3.55 mm
ALL of CF20-V-base_22
³Æ¥÷ of CF20-V-T2 x 11
³Æ¥÷ of CF20-V-T1 x 11
ALL of CF20-V-SLIDER_22
³Æ¥÷ of CF20-V-Tab1 x 2
