zoubworldArduino/KiCad_PersoLibrary/SparkFun-KiCad-Libraries-main/Footprints/SparkFun-3D-models/Display/UG-2864KSWLG01.step

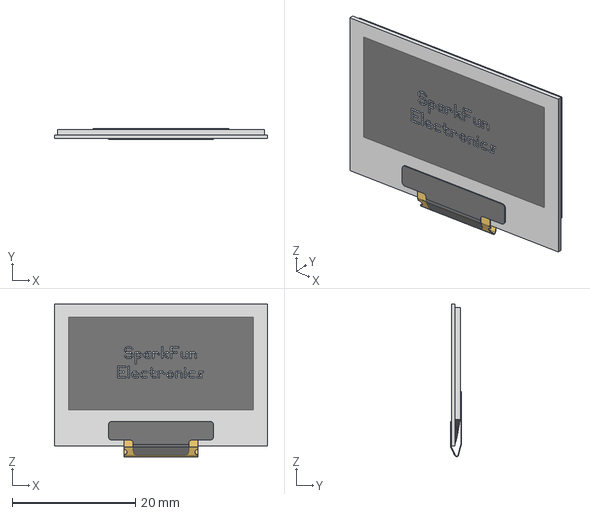
[picture p43: CAD file, 2025-12-28]
SparkFun-KiCad-Libraries-main/Footprints/SparkFun-3D-models/Display/UG-2864KSWLG01.step
34.5 x 1.75 x 24.7 mm
