zoubworldArduino/KiCad_PersoLibrary/SparkFun-KiCad-Libraries-main/Footprints/SparkFun-3D-models/Electromechanical/Relay_15.2x19.0mm_2.step

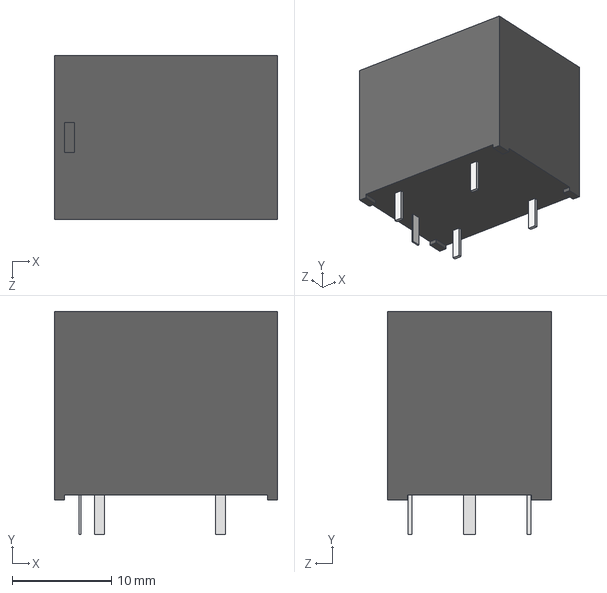
[picture p44: CAD file, 2025-12-28]
SparkFun-KiCad-Libraries-main/Footprints/SparkFun-3D-models/Electromechanical/Relay_15.2x19.0mm_2.step
22.5 x 22.5 x 16.5 mm
