zoubworldArduino/KiCad_PersoLibrary/SparkFun-KiCad-Libraries-main/Footprints/SparkFun-3D-models/Fuse/Fuse_0805_2012Metric.step

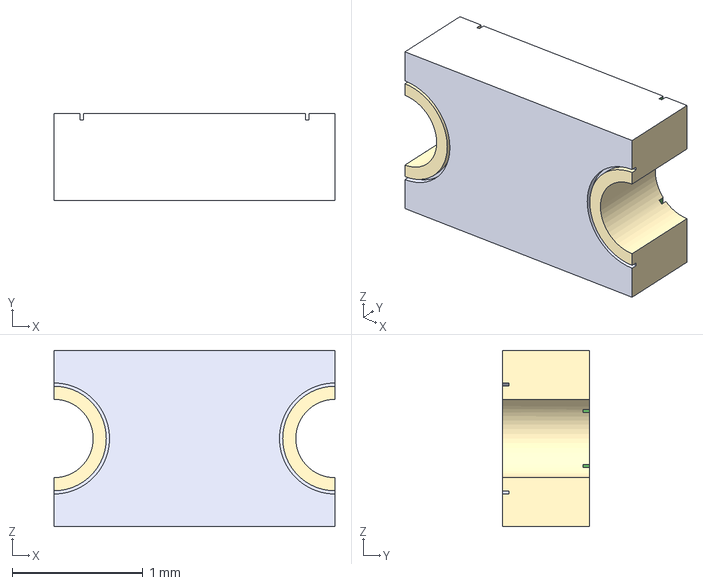
[picture p45: CAD file, 2025-12-28]
SparkFun-KiCad-Libraries-main/Footprints/SparkFun-3D-models/Fuse/Fuse_0805_2012Metric.step
2.15 x 0.665 x 1.35 mm
