zoubworldArduino/KiCad_PersoLibrary/SparkFun-KiCad-Libraries-main/Footprints/SparkFun-3D-models/LED/LED_0603_1608Metric_Green.STEP

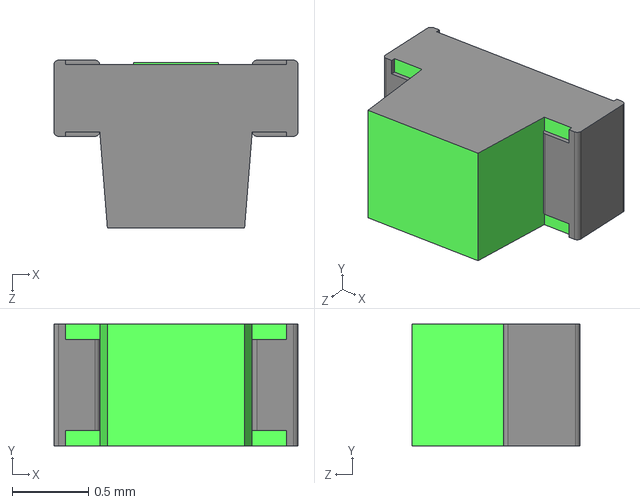
[picture p47: CAD file, 2025-12-28]
SparkFun-KiCad-Libraries-main/Footprints/SparkFun-3D-models/LED/LED_0603_1608Metric_Green.STEP
1.60 x 0.8 x 1.10 mm
