zoubworldArduino/KiCad_PersoLibrary/SparkFun-KiCad-Libraries-main/Footprints/SparkFun-3D-models/Resistor/RES_0804_4_ARR.step

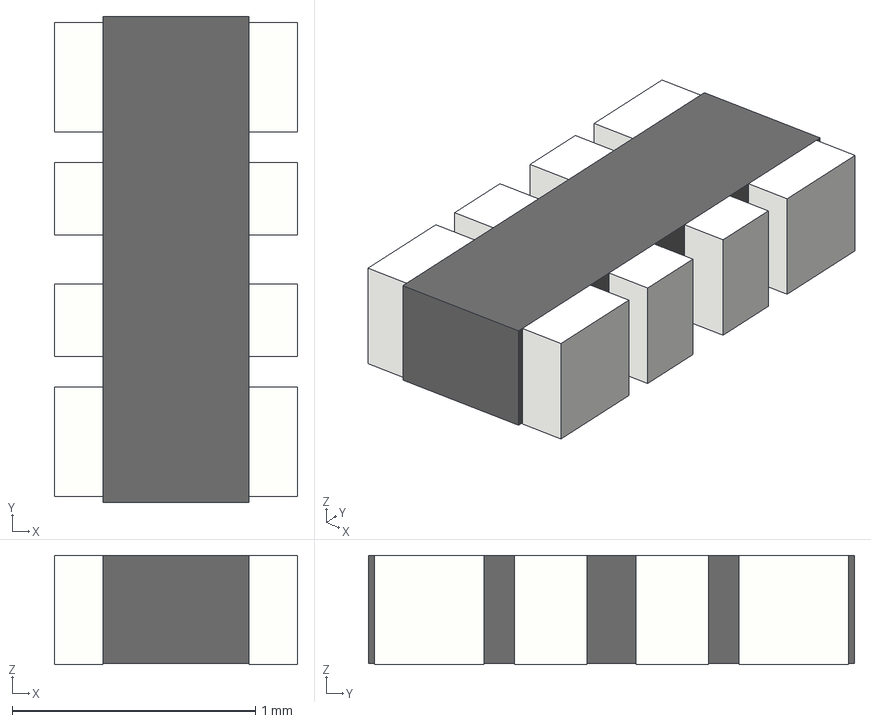
[picture p48: CAD file, 2025-12-28]
SparkFun-KiCad-Libraries-main/Footprints/SparkFun-3D-models/Resistor/RES_0804_4_ARR.step
1.00 x 2.00 x 0.45 mm
