zoubworldArduino/KiCad_PersoLibrary/SparkFun-KiCad-Libraries-main/Footprints/SparkFun-3D-models/RF/DFN-6_1.5x1.9mm_P0.5mm.stp

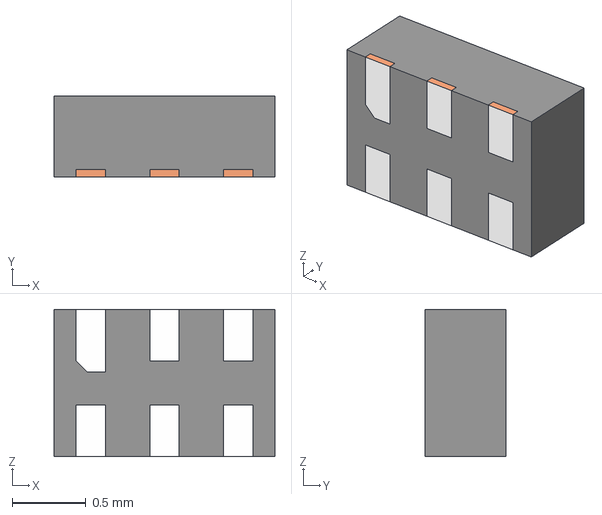
[picture p49: CAD file, 2025-12-28]
SparkFun-KiCad-Libraries-main/Footprints/SparkFun-3D-models/RF/DFN-6_1.5x1.9mm_P0.5mm.stp
1.50 x 0.55 x 1.00 mm
BODY_LEH06A
FRAME_LEH06A
