zoubworldArduino/KiCad_PersoLibrary/SparkFun-KiCad-Libraries-main/Footprints/SparkFun-3D-models/Semiconductor-Nonstandard/REC15E-SZ.step

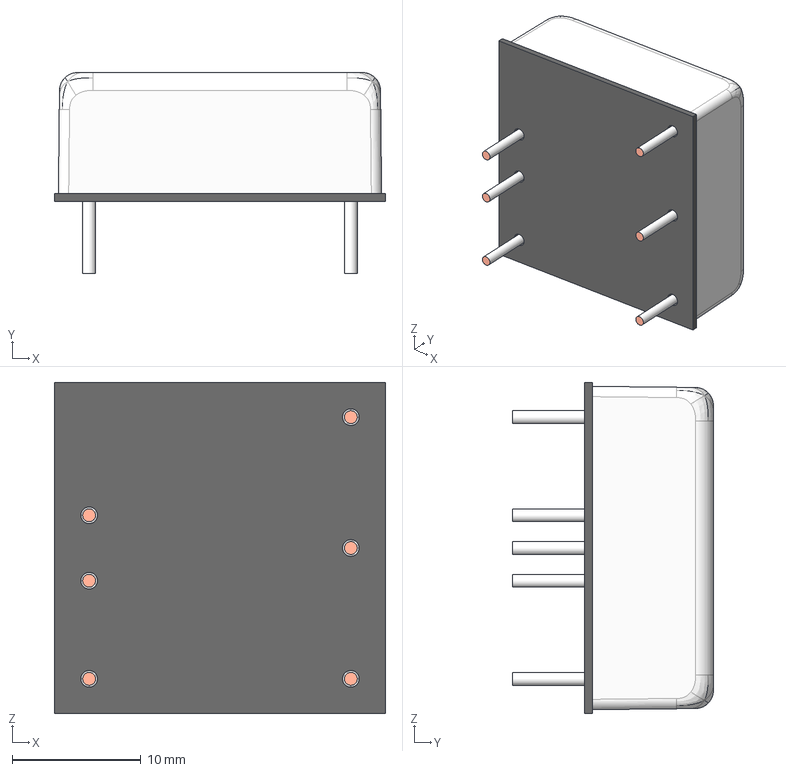
[picture p50: CAD file, 2025-12-28]
SparkFun-KiCad-Libraries-main/Footprints/SparkFun-3D-models/Semiconductor-Nonstandard/REC15E-SZ.step
25.7 x 15.6 x 25.7 mm
