zoubworldArduino/KiCad_PersoLibrary/SparkFun-KiCad-Libraries-main/Footprints/SparkFun-3D-models/Semiconductor-Standard/MSOP-10_3x3mm_P0.5mm.step

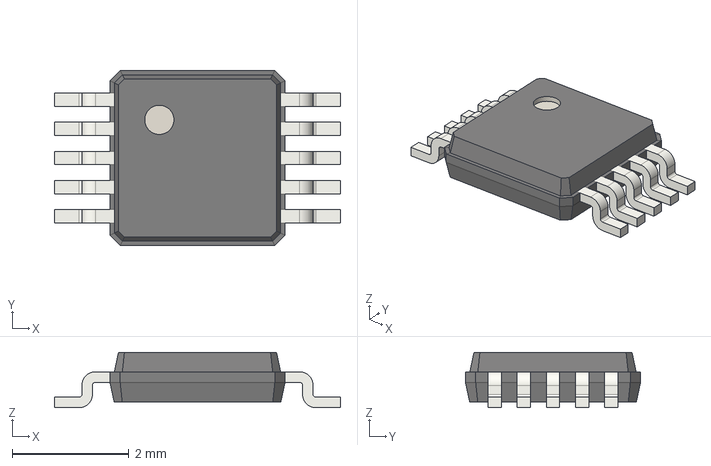
[picture p51: CAD file, 2025-12-28]
SparkFun-KiCad-Libraries-main/Footprints/SparkFun-3D-models/Semiconductor-Standard/MSOP-10_3x3mm_P0.5mm.step
4.90 x 3.00 x 0.95 mm
