zoubworldArduino/KiCad_PersoLibrary/SparkFun-KiCad-Libraries-main/Footprints/SparkFun-3D-models/Sensor/IM19.step

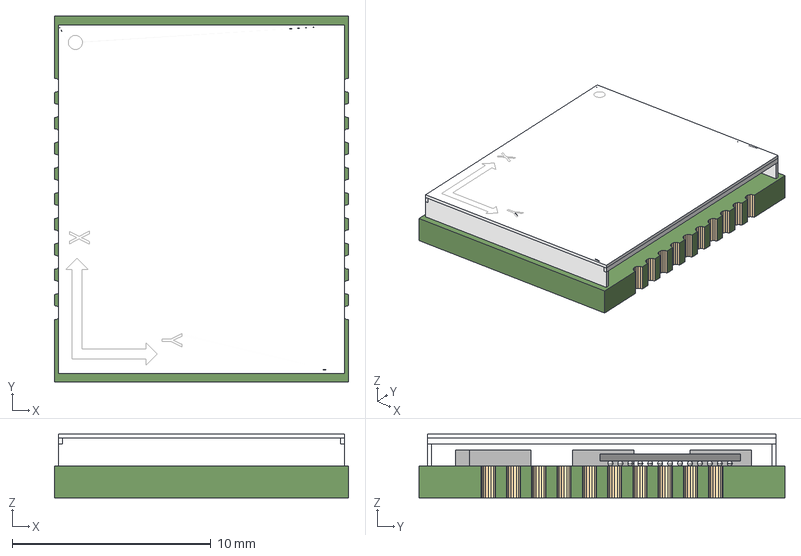
[picture p52: CAD file, 2025-12-28]
SparkFun-KiCad-Libraries-main/Footprints/SparkFun-3D-models/Sensor/IM19.step
14.8 x 18.4 x 3.20 mm
Board
Extruded x 2
Extruded_3
Extruded_6 x 2
Extruded_4
Extruded_5 x 2
Extruded_2
STM-UFBGA169 x 171
