zoubworldArduino/KiCad_PersoLibrary/SparkFun-KiCad-Libraries-main/Footprints/SparkFun-3D-models/Switch/Push_SMD_4.6x2.8mm_h2.5mm.step

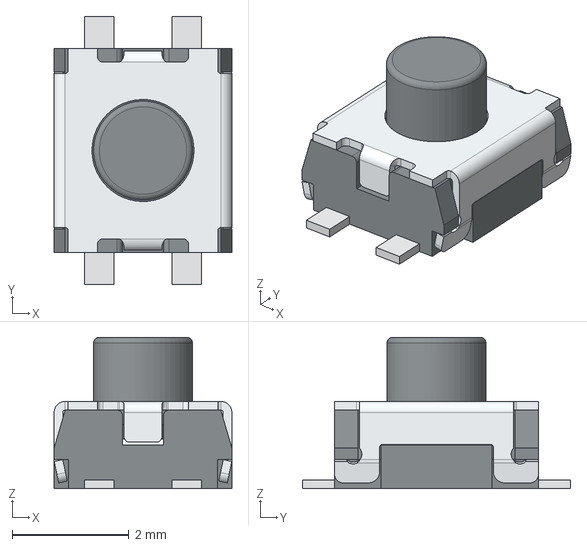
[picture p53: CAD file, 2025-12-28]
SparkFun-KiCad-Libraries-main/Footprints/SparkFun-3D-models/Switch/Push_SMD_4.6x2.8mm_h2.5mm.step
3.05 x 4.60 x 2.60 mm
