zoubworldArduino/KiCad_PersoLibrary/SparkFun-KiCad-Libraries-main/Footprints/SparkFun-3D-models/Clock/Crystal_SMD_3.2x2.5mm.STEP

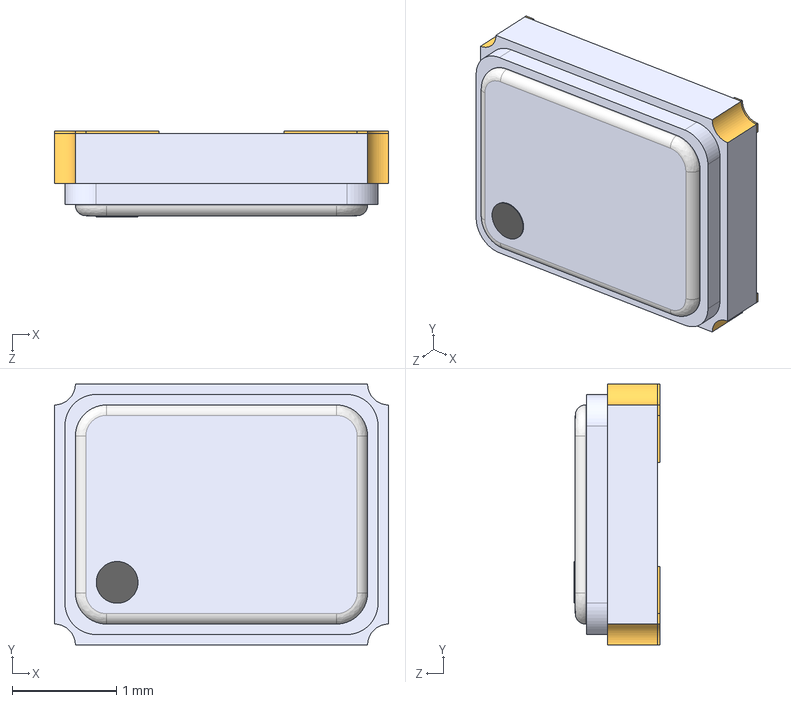
[picture p54: CAD file, 2025-12-28]
SparkFun-KiCad-Libraries-main/Footprints/SparkFun-3D-models/Clock/Crystal_SMD_3.2x2.5mm.STEP
3.20 x 2.50 x 0.82 mm
MetalFrame
Pin1Marker
Pin3
Pin1
Lid
Pin4
Pin2
Ceramic
