zoubworldArduino/KiCad_PersoLibrary/SparkFun-KiCad-Libraries-main/Footprints/SparkFun-3D-models/Coil/Inductor_0806.step

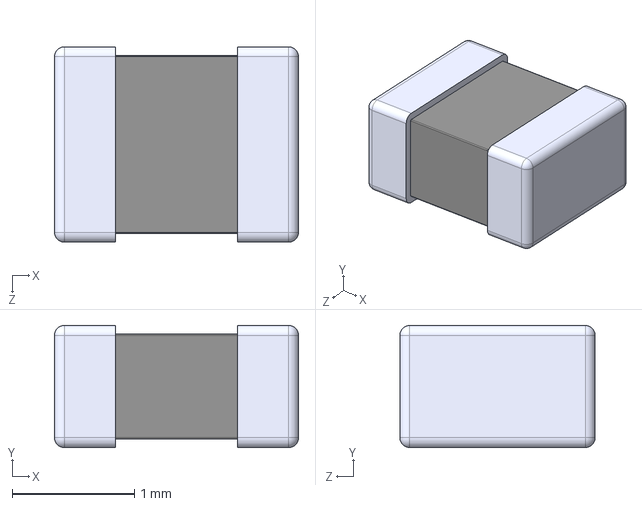
[picture p55: CAD file, 2025-12-28]
SparkFun-KiCad-Libraries-main/Footprints/SparkFun-3D-models/Coil/Inductor_0806.step
2.00 x 1.00 x 1.60 mm
