zoubworldArduino/KiCad_PersoLibrary/SparkFun-KiCad-Libraries-main/Footprints/SparkFun-3D-models/Connector/1x05_2.0mm_SMD_Pin1RightDown.step

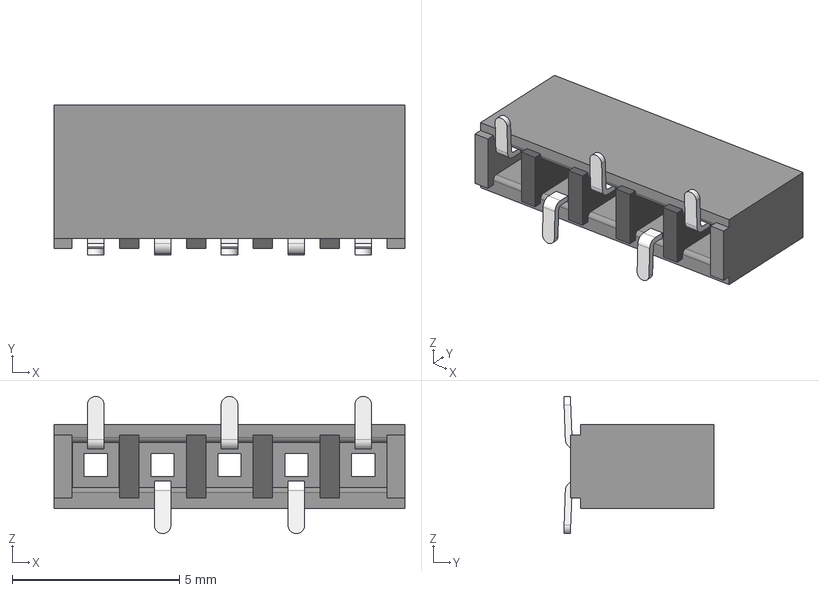
[picture p56: CAD file, 2025-12-28]
SparkFun-KiCad-Libraries-main/Footprints/SparkFun-3D-models/Connector/1x05_2.0mm_SMD_Pin1RightDown.step
10.5 x 4.50 x 4.10 mm
