zoubworldArduino/KiCad_PersoLibrary/SparkFun-KiCad-Libraries-main/Footprints/SparkFun-3D-models/Display/2_inch_capacitive_touch_screen.step

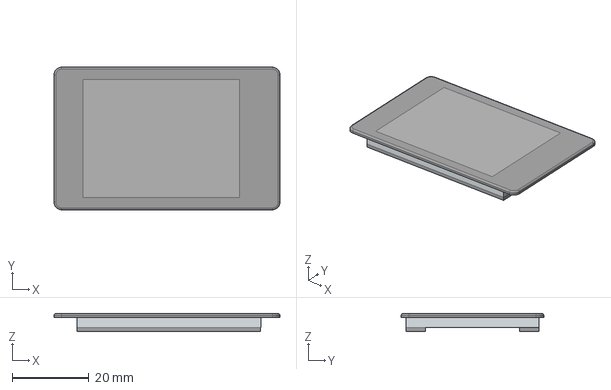
[picture p57: CAD file, 2025-12-28]
SparkFun-KiCad-Libraries-main/Footprints/SparkFun-3D-models/Display/2_inch_capacitive_touch_screen.step
58.9 x 37.2 x 4.70 mm
