zoubworldArduino/KiCad_PersoLibrary/SparkFun-KiCad-Libraries-main/Footprints/SparkFun-3D-models/Electromechanical/Relay_10.2x18.4mm.step

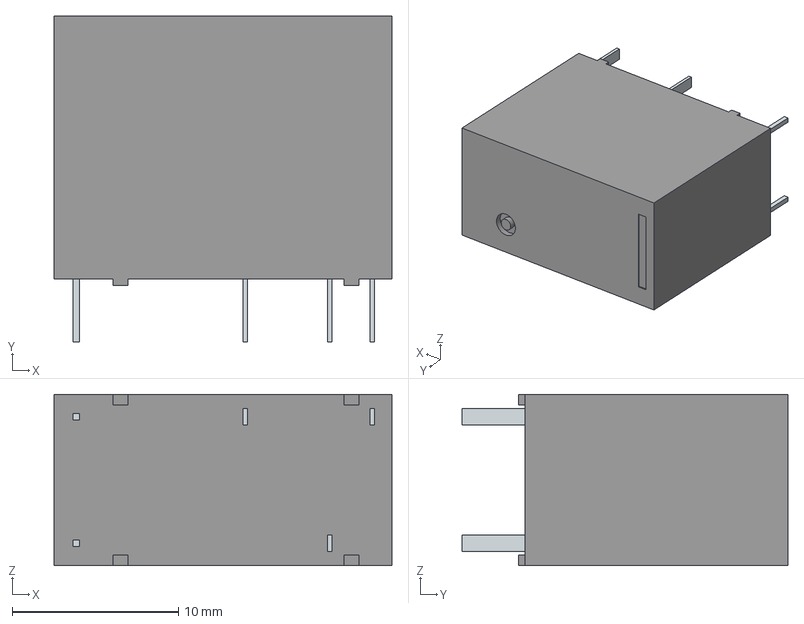
[picture p58: CAD file, 2025-12-28]
SparkFun-KiCad-Libraries-main/Footprints/SparkFun-3D-models/Electromechanical/Relay_10.2x18.4mm.step
20.3 x 19.6 x 10.3 mm
