zoubworldArduino/KiCad_PersoLibrary/SparkFun-KiCad-Libraries-main/Footprints/SparkFun-3D-models/Fuse/Fuse_1210_3225Metric.step

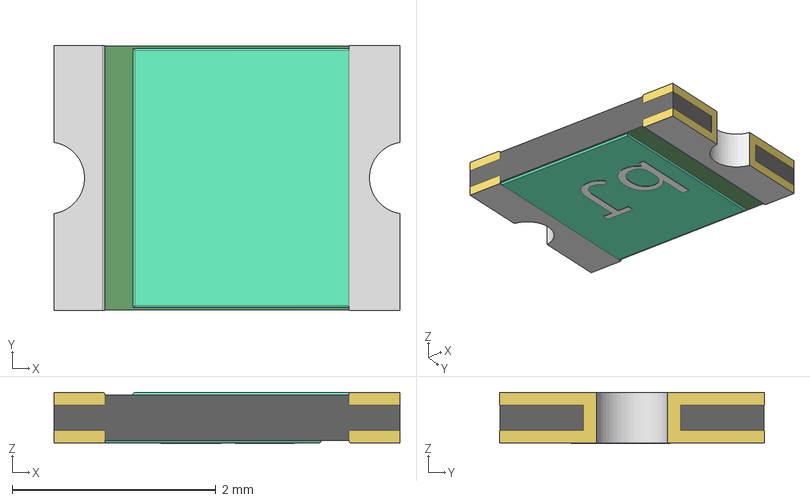
[picture p59: CAD file, 2025-12-28]
SparkFun-KiCad-Libraries-main/Footprints/SparkFun-3D-models/Fuse/Fuse_1210_3225Metric.step
3.40 x 2.60 x 0.504 mm
