zoubworldArduino/KiCad_PersoLibrary/SparkFun-KiCad-Libraries-main/Footprints/SparkFun-3D-models/GPS/NEO.STEP

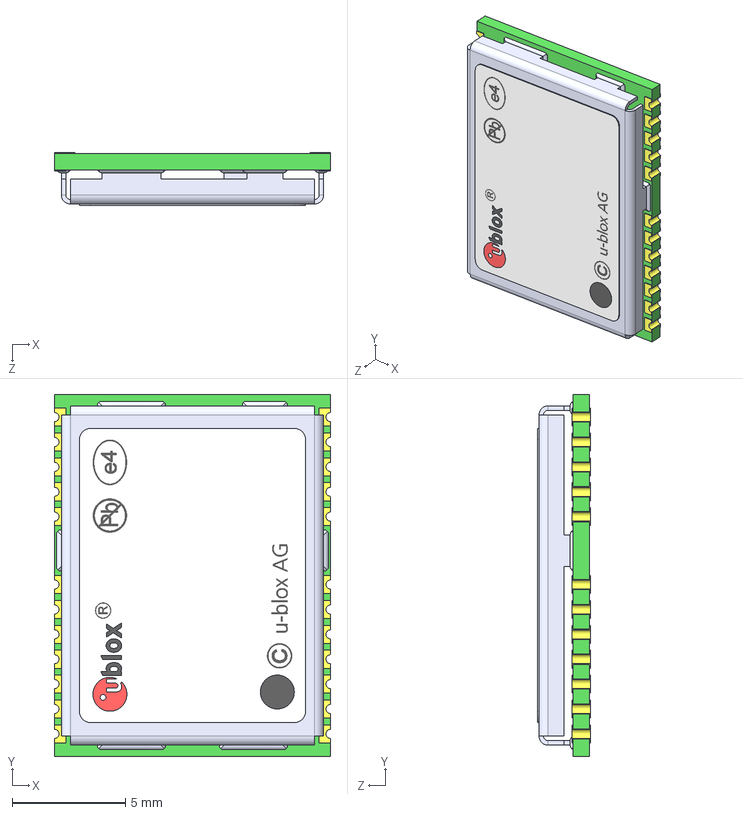
[picture p60: CAD file, 2025-12-28]
SparkFun-KiCad-Libraries-main/Footprints/SparkFun-3D-models/GPS/NEO.STEP
12.2 x 16.0 x 2.33 mm
NEO_PCB
Shield_NEO
u-blox_NEO_label
