zoubworldArduino/KiCad_PersoLibrary/SparkFun-KiCad-Libraries-main/Footprints/SparkFun-3D-models/LED/SparkFun_SMD_LED_Light_Pipe.step

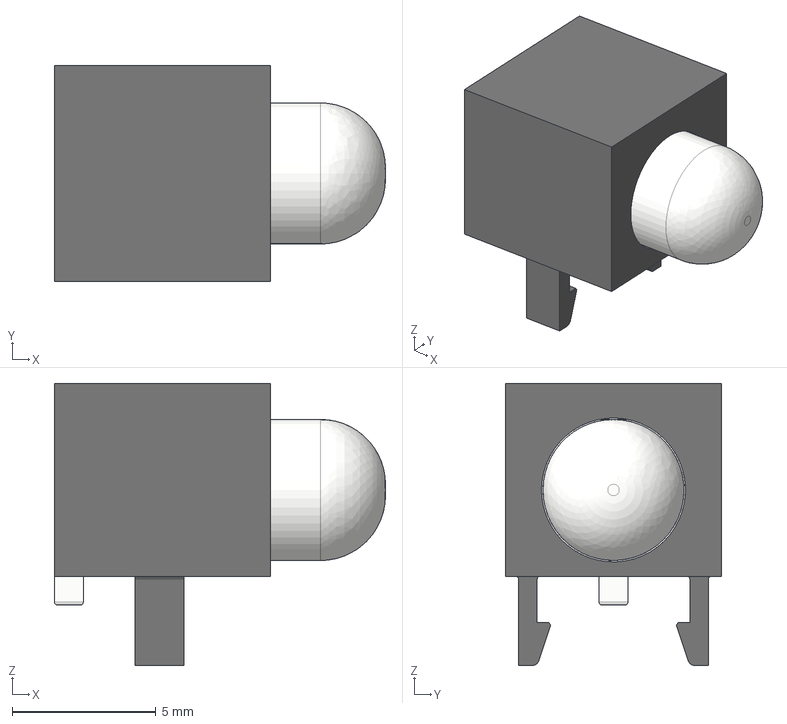
[picture p61: CAD file, 2025-12-28]
SparkFun-KiCad-Libraries-main/Footprints/SparkFun-3D-models/LED/SparkFun_SMD_LED_Light_Pipe.step
11.5 x 7.50 x 9.80 mm
