zoubworldArduino/KiCad_PersoLibrary/SparkFun-KiCad-Libraries-main/Footprints/SparkFun-3D-models/RF/ESP32-S3-MINI.step

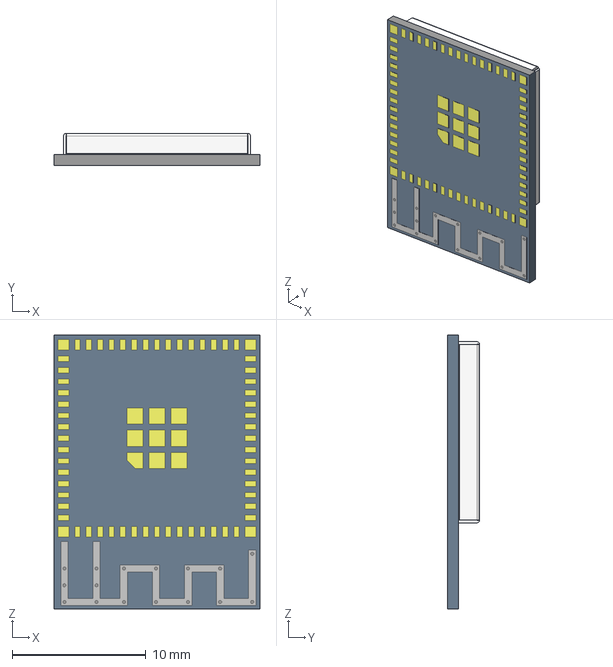
[picture p62: CAD file, 2025-12-28]
SparkFun-KiCad-Libraries-main/Footprints/SparkFun-3D-models/RF/ESP32-S3-MINI.step
15.4 x 2.42 x 20.5 mm
