zoubworldArduino/KiCad_PersoLibrary/SparkFun-KiCad-Libraries-main/Footprints/SparkFun-3D-models/Semiconductor-Nonstandard/Ag9900M_MT.stp

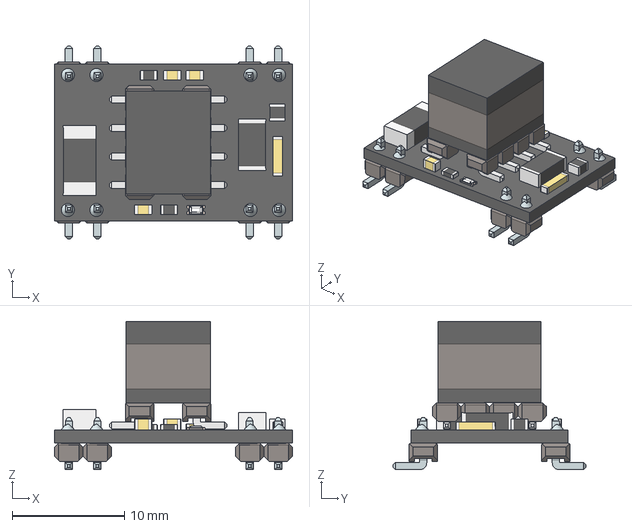
[picture p63: CAD file, 2025-12-28]
SparkFun-KiCad-Libraries-main/Footprints/SparkFun-3D-models/Semiconductor-Nonstandard/Ag9900M_MT.stp
21.2 x 17.2 x 13.2 mm
