zoubworldArduino/KiCad_PersoLibrary/SparkFun-KiCad-Libraries-main/Footprints/SparkFun-3D-models/Semiconductor-Standard/QFN-36-1EP_6x6mm_P0.5mm_EP3.7x3.7mm.step

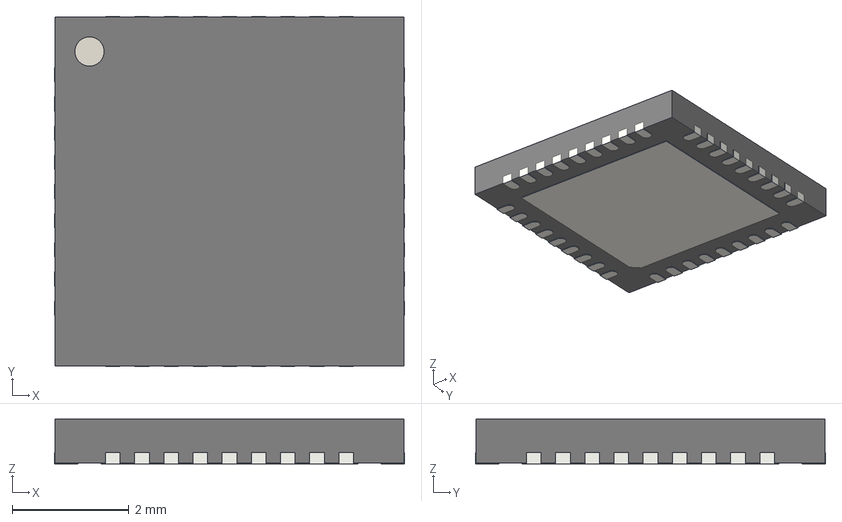
[picture p64: CAD file, 2025-12-28]
SparkFun-KiCad-Libraries-main/Footprints/SparkFun-3D-models/Semiconductor-Standard/QFN-36-1EP_6x6mm_P0.5mm_EP3.7x3.7mm.step
6.00 x 6.00 x 0.77 mm
