zoubworldArduino/KiCad_PersoLibrary/SparkFun-KiCad-Libraries-main/Footprints/SparkFun-3D-models/Sensor/SHT40.STEP

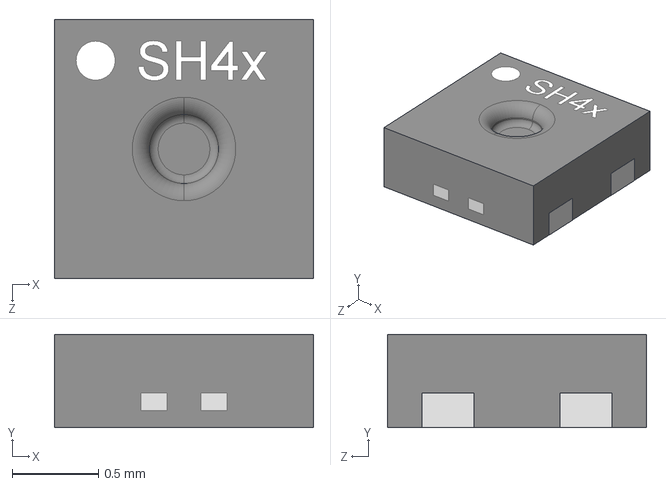
[picture p65: CAD file, 2025-12-28]
SparkFun-KiCad-Libraries-main/Footprints/SparkFun-3D-models/Sensor/SHT40.STEP
1.50 x 0.542 x 1.50 mm
