zoubworldArduino/KiCad_PersoLibrary/SparkFun-KiCad-Libraries-main/Footprints/SparkFun-3D-models/Switch/Tactal Switch - SMD (12mmx12mmx8.5mm).step

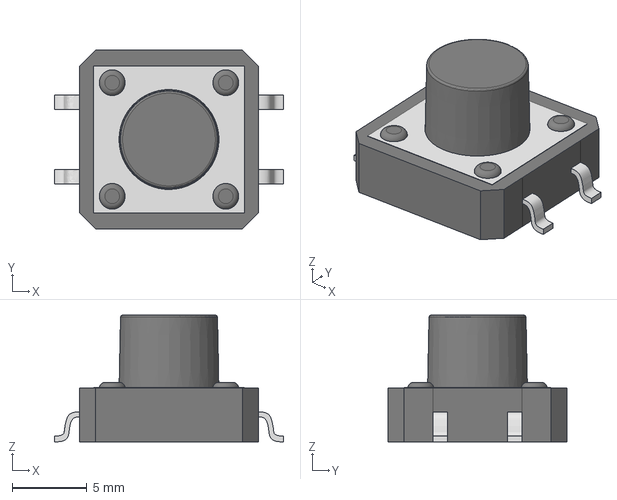
[picture p66: CAD file, 2025-12-28]
SparkFun-KiCad-Libraries-main/Footprints/SparkFun-3D-models/Switch/Tactal Switch - SMD (12mmx12mmx8.5mm).step
15.4 x 12.0 x 8.50 mm
