zoubworldArduino/KiCad_PersoLibrary/SparkFun-KiCad-Libraries-main/Footprints/SparkFun-3D-models/Clock/STP3593_PTH_52x42mm.stp

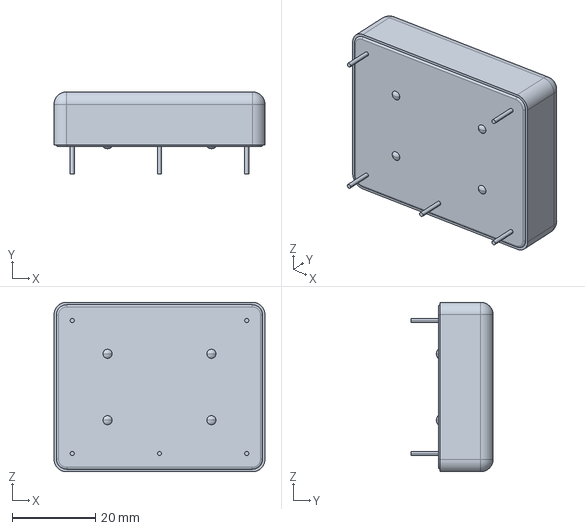
[picture p67: CAD file, 2025-12-28]
SparkFun-KiCad-Libraries-main/Footprints/SparkFun-3D-models/Clock/STP3593_PTH_52x42mm.stp
50.8 x 19.8 x 40.8 mm
