zoubworldArduino/KiCad_PersoLibrary/SparkFun-KiCad-Libraries-main/Footprints/SparkFun-3D-models/Connector/SMA-Edge.step

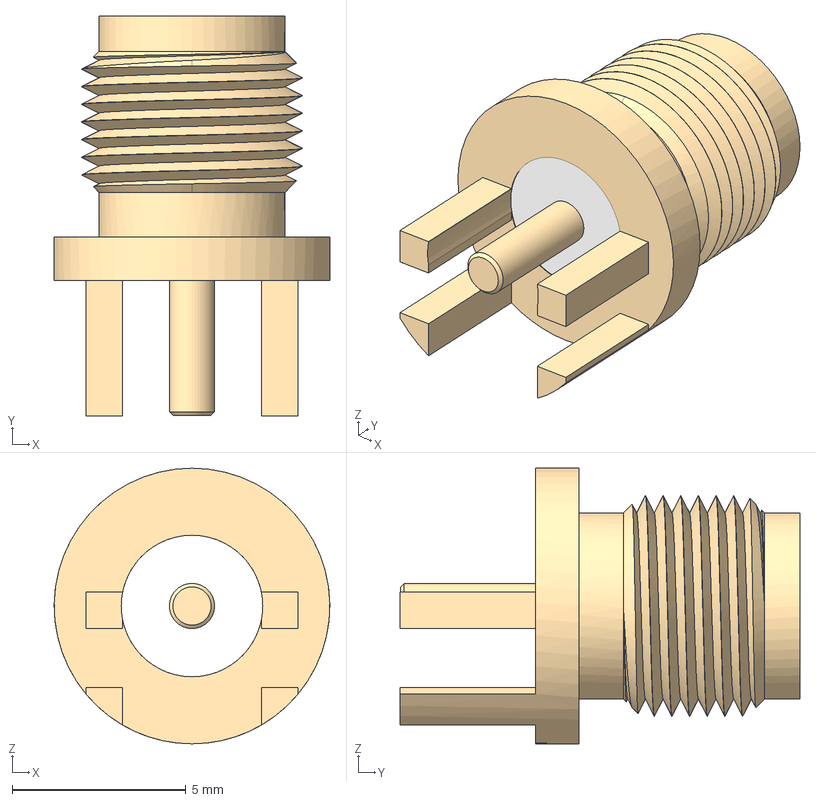
[picture p68: CAD file, 2025-12-28]
SparkFun-KiCad-Libraries-main/Footprints/SparkFun-3D-models/Connector/SMA-Edge.step
7.93 x 11.5 x 7.93 mm
