zoubworldArduino/KiCad_PersoLibrary/SparkFun-KiCad-Libraries-main/Footprints/SparkFun-3D-models/Electromechanical/Relay_15.2x19.0mm.step

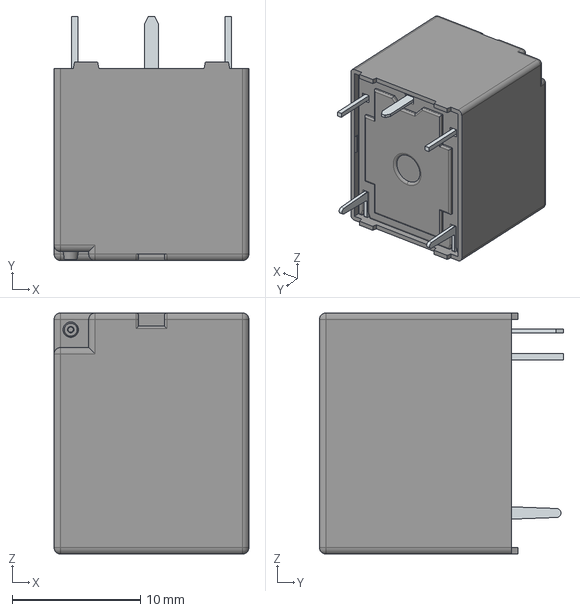
[picture p69: CAD file, 2025-12-28]
SparkFun-KiCad-Libraries-main/Footprints/SparkFun-3D-models/Electromechanical/Relay_15.2x19.0mm.step
15.2 x 19.1 x 18.8 mm
