zoubworldArduino/KiCad_PersoLibrary/SparkFun-KiCad-Libraries-main/Footprints/SparkFun-3D-models/Fuse/Fuse_1812_4532Metric.step

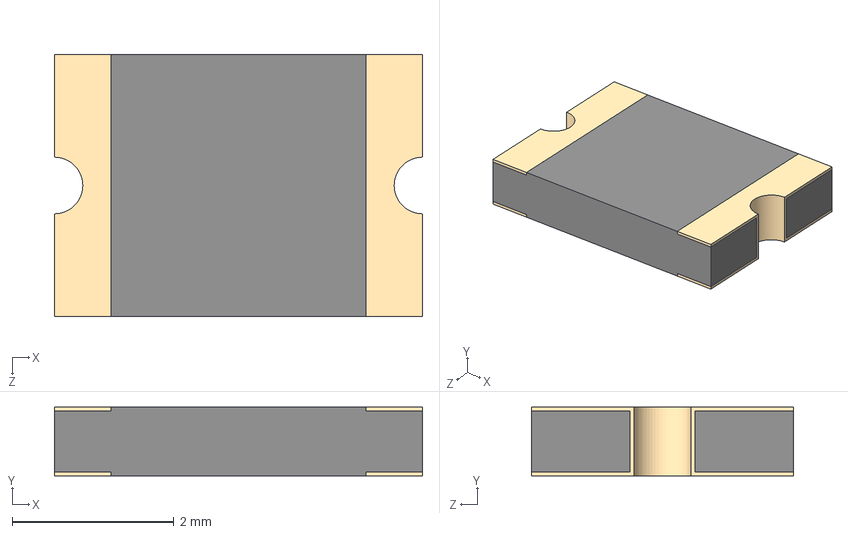
[picture p70: CAD file, 2025-12-28]
SparkFun-KiCad-Libraries-main/Footprints/SparkFun-3D-models/Fuse/Fuse_1812_4532Metric.step
4.55 x 0.85 x 3.24 mm
