zoubworldArduino/KiCad_PersoLibrary/SparkFun-KiCad-Libraries-main/Footprints/SparkFun-3D-models/GPS/Septentrio_mosaic-X5-Rev5.step

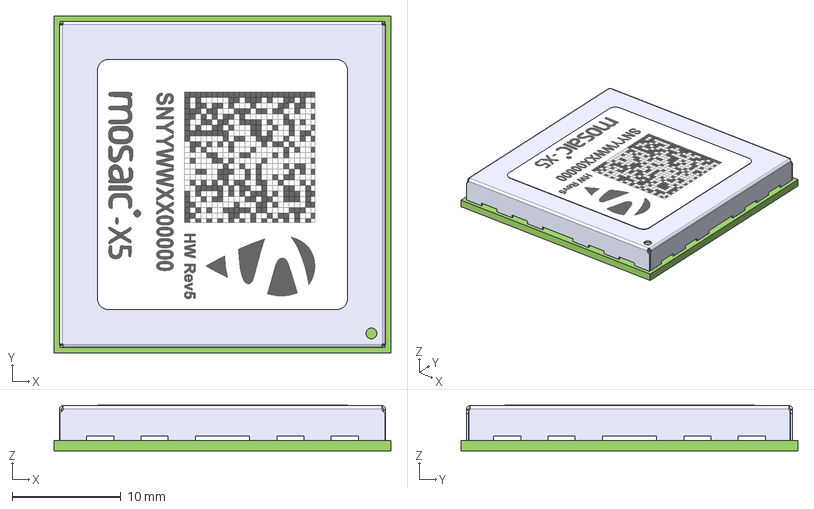
[picture p71: CAD file, 2025-12-28]
SparkFun-KiCad-Libraries-main/Footprints/SparkFun-3D-models/GPS/Septentrio_mosaic-X5-Rev5.step
31.0 x 31.0 x 4.21 mm
PAR-00001366
PAR-00000988(Default)
PAR-00001381
