zoubworldArduino/KiCad_PersoLibrary/SparkFun-KiCad-Libraries-main/Footprints/SparkFun-3D-models/Sensor/BMV080.step

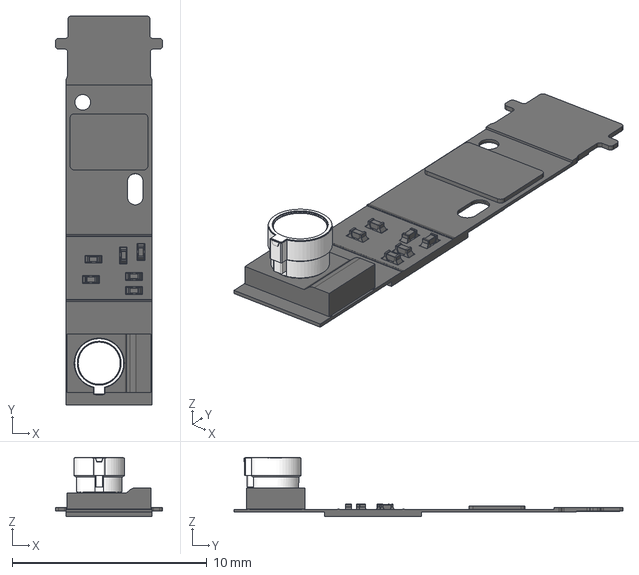
[picture p74: CAD file, 2025-12-28]
SparkFun-KiCad-Libraries-main/Footprints/SparkFun-3D-models/Sensor/BMV080.step
5.50 x 20.0 x 3.04 mm
