zoubworldArduino/KiCad_PersoLibrary/SparkFun-KiCad-Libraries-main/Footprints/SparkFun-3D-models/Switch/Tactile_Switch_5.2x5.2mm_h1.9mm.STEP

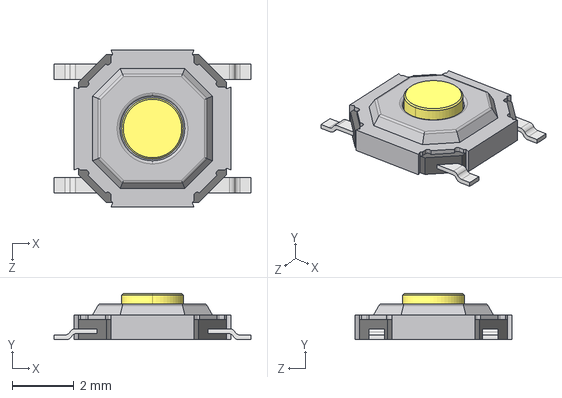
[picture p75: CAD file, 2025-12-28]
SparkFun-KiCad-Libraries-main/Footprints/SparkFun-3D-models/Switch/Tactile_Switch_5.2x5.2mm_h1.9mm.STEP
6.40 x 1.50 x 5.10 mm
