zoubworldArduino/KiCad_PersoLibrary/SparkFun-KiCad-Libraries-main/Footprints/SparkFun-3D-models/Clock/Crystal_SMD_2.5x2.0mm.step

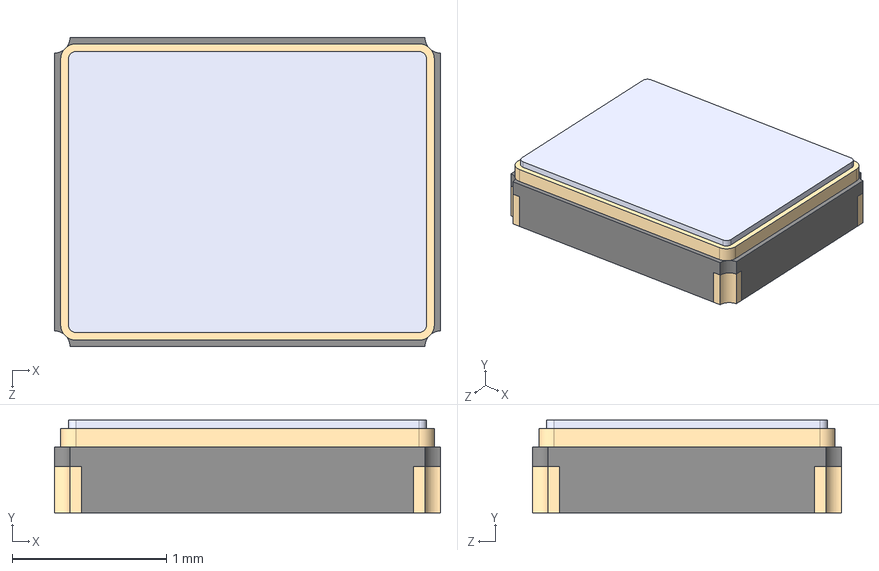
[picture p76: CAD file, 2025-12-28]
SparkFun-KiCad-Libraries-main/Footprints/SparkFun-3D-models/Clock/Crystal_SMD_2.5x2.0mm.step
2.50 x 0.6 x 2.00 mm
