zoubworldArduino/KiCad_PersoLibrary/SparkFun-KiCad-Libraries-main/Footprints/SparkFun-3D-models/Connector/1x06_SMD_Pin1RightDown.step

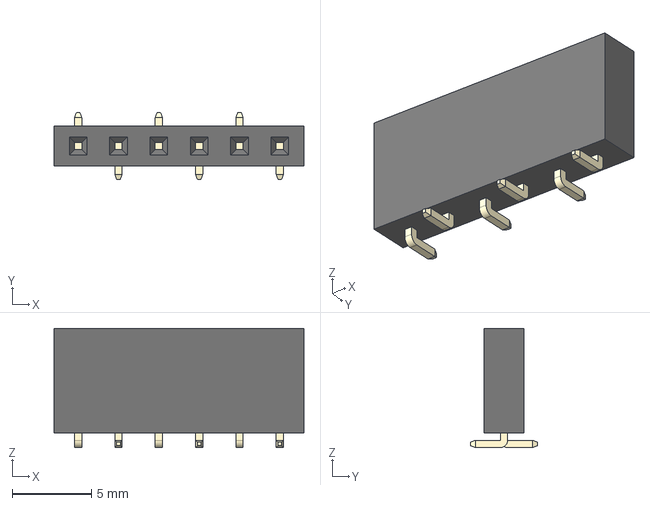
[picture p77: CAD file, 2025-12-28]
SparkFun-KiCad-Libraries-main/Footprints/SparkFun-3D-models/Connector/1x06_SMD_Pin1RightDown.step
15.7 x 4.20 x 7.50 mm
