zoubworldArduino/KiCad_PersoLibrary/SparkFun-KiCad-Libraries-main/Footprints/SparkFun-3D-models/Electromechanical/Relay_5.0x20.0mm.step

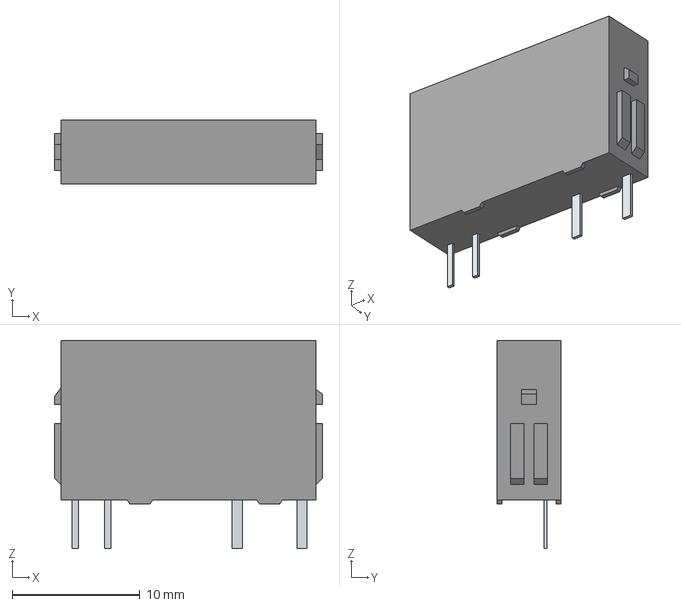
[picture p78: CAD file, 2025-12-28]
SparkFun-KiCad-Libraries-main/Footprints/SparkFun-3D-models/Electromechanical/Relay_5.0x20.0mm.step
21.0 x 5.00 x 16.3 mm
