zoubworldArduino/KiCad_PersoLibrary/SparkFun-KiCad-Libraries-main/Footprints/SparkFun-3D-models/GPS/UM980.stp

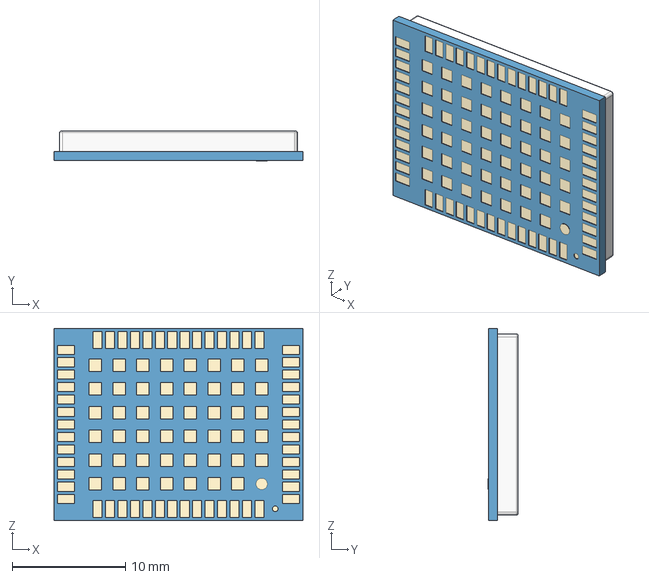
[picture p79: CAD file, 2025-12-28]
SparkFun-KiCad-Libraries-main/Footprints/SparkFun-3D-models/GPS/UM980.stp
22.0 x 2.62 x 17.0 mm
