zoubworldArduino/KiCad_PersoLibrary/SparkFun-KiCad-Libraries-main/Footprints/SparkFun-3D-models/Semiconductor-Standard/PCBA-10_9x7mm.stp

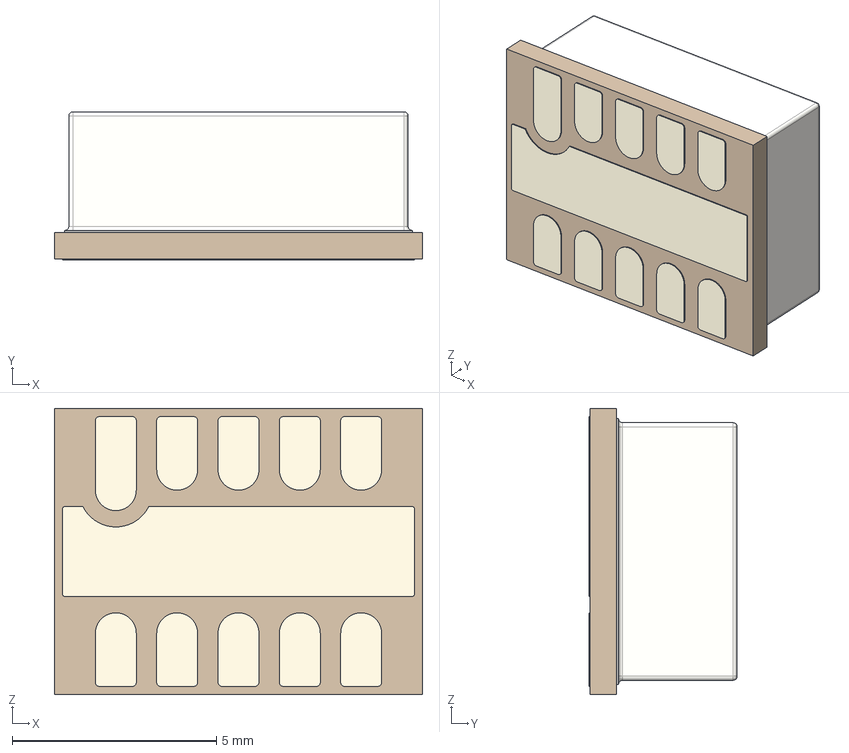
[picture p80: CAD file, 2025-12-28]
SparkFun-KiCad-Libraries-main/Footprints/SparkFun-3D-models/Semiconductor-Standard/PCBA-10_9x7mm.stp
9.00 x 3.63 x 7.00 mm
