zoubworldArduino/KiCad_PersoLibrary/SparkFun-KiCad-Libraries-main/Footprints/SparkFun-3D-models/Switch/Push_SMD_4.2x3.2mm_h2.5mm.step

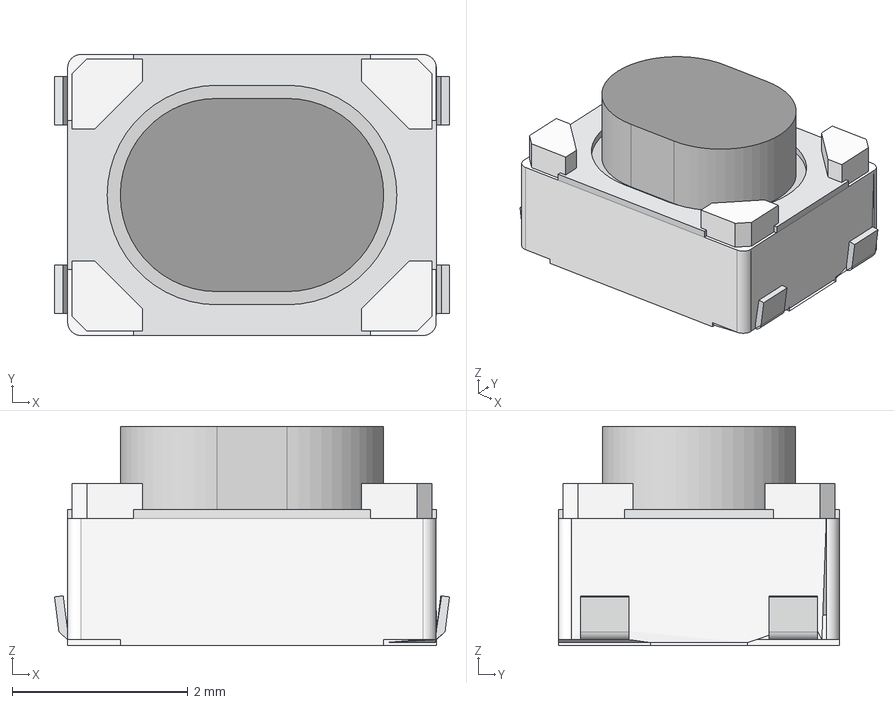
[picture p82: CAD file, 2025-12-28]
SparkFun-KiCad-Libraries-main/Footprints/SparkFun-3D-models/Switch/Push_SMD_4.2x3.2mm_h2.5mm.step
4.50 x 3.20 x 2.50 mm
