zoubworldArduino/KiCad_PersoLibrary/SparkFun-KiCad-Libraries-main/Footprints/SparkFun-3D-models/Clock/Ceramic_5032_10pins.STEP

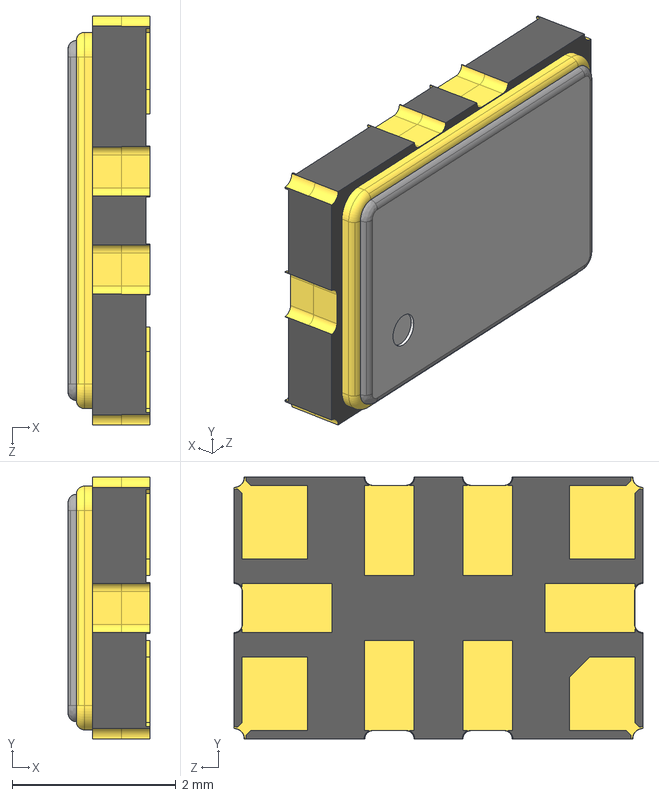
[picture p83: CAD file, 2025-12-28]
SparkFun-KiCad-Libraries-main/Footprints/SparkFun-3D-models/Clock/Ceramic_5032_10pins.STEP
1.00 x 3.20 x 5.00 mm
