zoubworldArduino/KiCad_PersoLibrary/SparkFun-KiCad-Libraries-main/Footprints/SparkFun-3D-models/Connector/2x10_P2.54mm_Socket_SMD_RA.stp

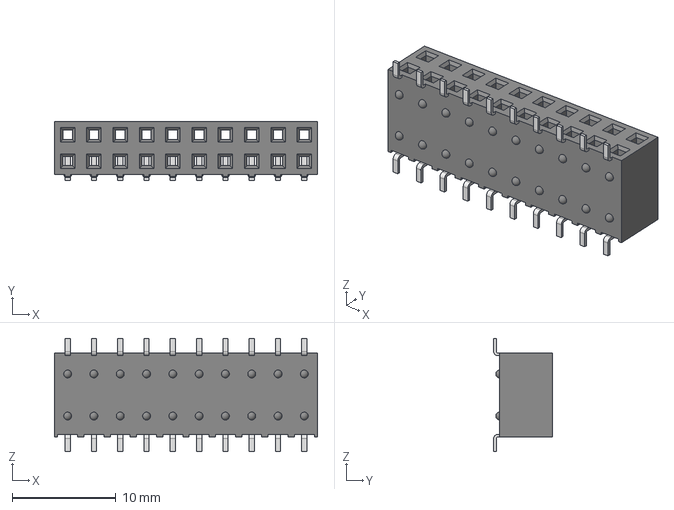
[picture p84: CAD file, 2025-12-28]
SparkFun-KiCad-Libraries-main/Footprints/SparkFun-3D-models/Connector/2x10_P2.54mm_Socket_SMD_RA.stp
25.4 x 5.66 x 10.9 mm
