zoubworldArduino/KiCad_PersoLibrary/SparkFun-KiCad-Libraries-main/Footprints/SparkFun-3D-models/LED/LED_1206_3216Metric_Castellated_Green.step

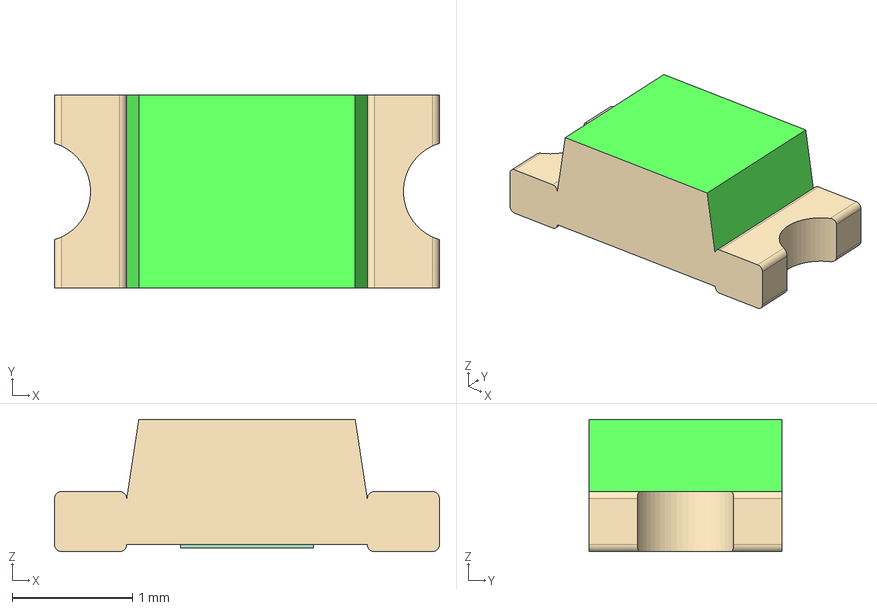
[picture p86: CAD file, 2025-12-28]
SparkFun-KiCad-Libraries-main/Footprints/SparkFun-3D-models/LED/LED_1206_3216Metric_Castellated_Green.step
3.20 x 1.60 x 1.10 mm
