zoubworldArduino/KiCad_PersoLibrary/SparkFun-KiCad-Libraries-main/Footprints/SparkFun-3D-models/RF/RM2.STEP

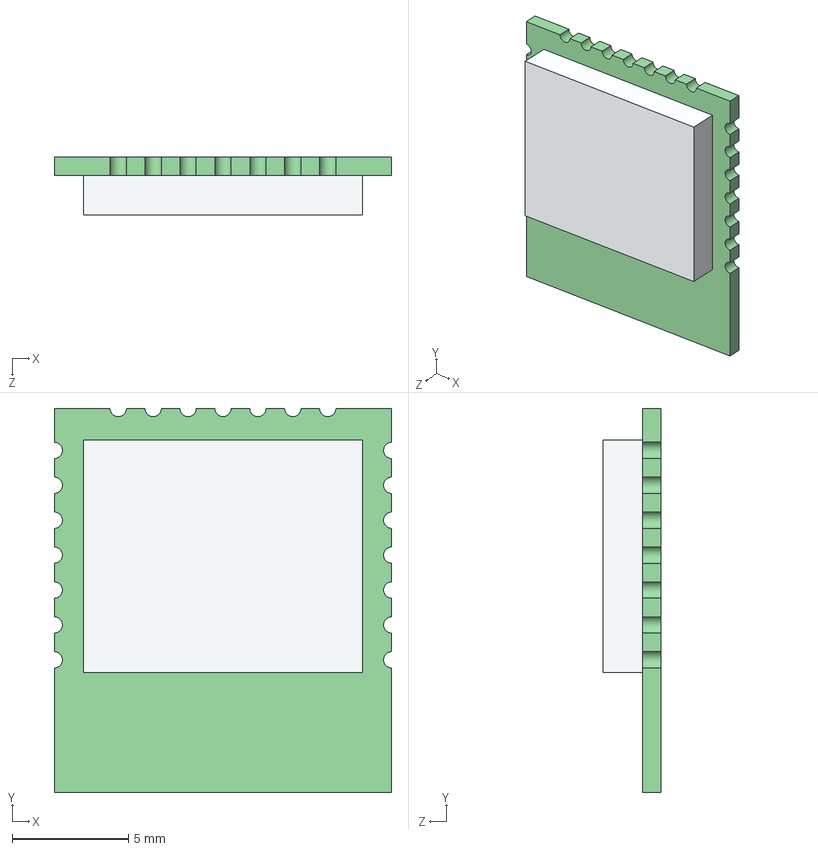
[picture p87: CAD file, 2025-12-28]
SparkFun-KiCad-Libraries-main/Footprints/SparkFun-3D-models/RF/RM2.STEP
14.5 x 16.5 x 2.50 mm
