zoubworldArduino/KiCad_PersoLibrary/SparkFun-KiCad-Libraries-main/Footprints/SparkFun-3D-models/Semiconductor-Standard/SO-14_3.9x8.65mm_P1.27mm.step

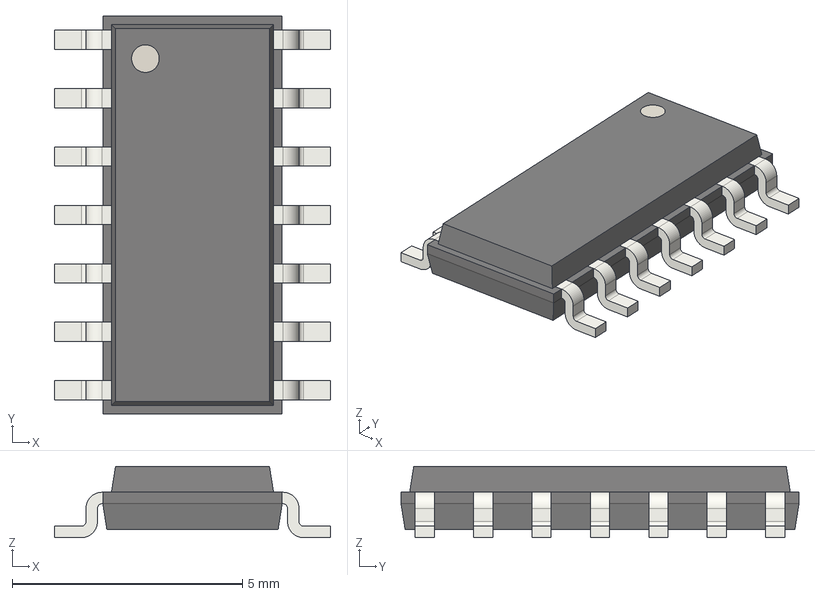
[picture p88: CAD file, 2025-12-28]
SparkFun-KiCad-Libraries-main/Footprints/SparkFun-3D-models/Semiconductor-Standard/SO-14_3.9x8.65mm_P1.27mm.step
6.00 x 8.65 x 1.55 mm
5712e516-7b30-11ed-bcdd-db420251a6ca_part
5712e517-7b30-11ed-bcdd-db420251a6ca_part
5712e518-7b30-11ed-bcdd-db420251a6ca_part
5712e519-7b30-11ed-bcdd-db420251a6ca_part
