zoubworldArduino/KiCad_PersoLibrary/SparkFun-KiCad-Libraries-main/Footprints/SparkFun-3D-models/Switch/Push_SMD_6x3.5mm.step

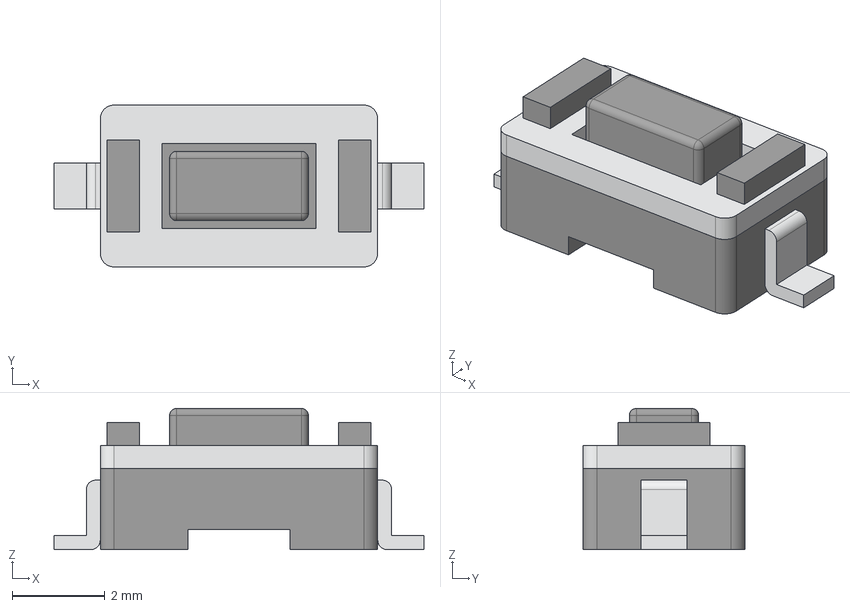
[picture p90: CAD file, 2025-12-28]
SparkFun-KiCad-Libraries-main/Footprints/SparkFun-3D-models/Switch/Push_SMD_6x3.5mm.step
8.00 x 3.50 x 3.05 mm
