zoubworldArduino/KiCad_PersoLibrary/SparkFun-KiCad-Libraries-main/Footprints/SparkFun-3D-models/Electromechanical/Buzzer_9mm_SMD.step

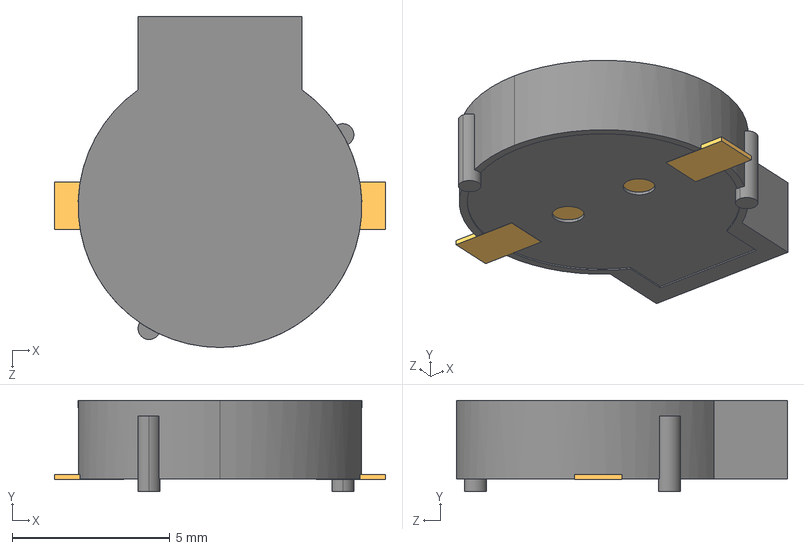
[picture p92: CAD file, 2025-12-28]
SparkFun-KiCad-Libraries-main/Footprints/SparkFun-3D-models/Electromechanical/Buzzer_9mm_SMD.step
10.5 x 2.90 x 10.5 mm
