zoubworldArduino/KiCad_PersoLibrary/SparkFun-KiCad-Libraries-main/Footprints/SparkFun-3D-models/GPS/Septentrio_mosaic-G5.step

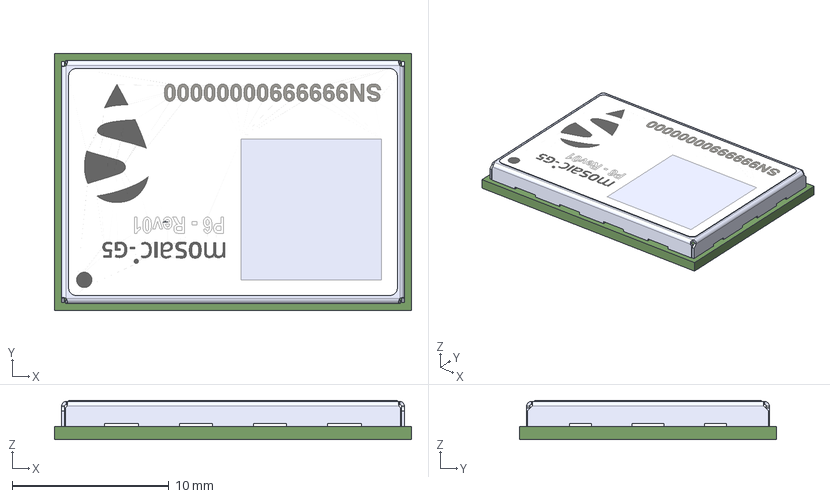
[picture p93: CAD file, 2025-12-28]
SparkFun-KiCad-Libraries-main/Footprints/SparkFun-3D-models/GPS/Septentrio_mosaic-G5.step
22.8 x 16.4 x 2.50 mm
PAR-00001479
PAR-00000856
PAR-00001478
