zoubworldArduino/KiCad_PersoLibrary/SparkFun-KiCad-Libraries-main/Footprints/SparkFun-3D-models/RF/Filter_1109-5_1.1x0.9mm.step

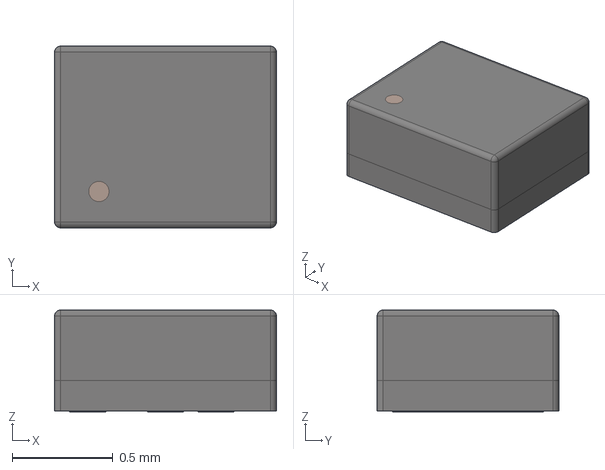
[picture p95: CAD file, 2025-12-28]
SparkFun-KiCad-Libraries-main/Footprints/SparkFun-3D-models/RF/Filter_1109-5_1.1x0.9mm.step
1.10 x 0.9 x 0.505 mm
