zoubworldArduino/KiCad_PersoLibrary/SparkFun-KiCad-Libraries-main/Footprints/SparkFun-3D-models/Semiconductor-Standard/SOT-363_SC-70-6.step

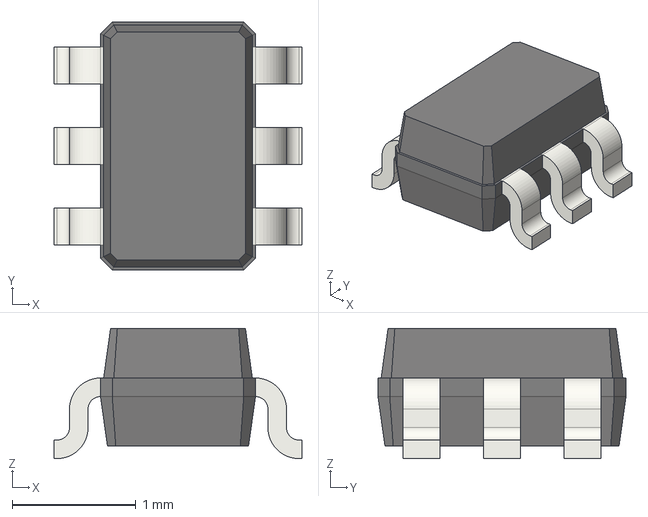
[picture p96: CAD file, 2025-12-28]
SparkFun-KiCad-Libraries-main/Footprints/SparkFun-3D-models/Semiconductor-Standard/SOT-363_SC-70-6.step
2.00 x 2.00 x 1.05 mm
