zoubworldArduino/KiCad_PersoLibrary/SparkFun-KiCad-Libraries-main/Footprints/SparkFun-3D-models/Switch/Slide_DPDT_SMD_9.0x3.6mm.step

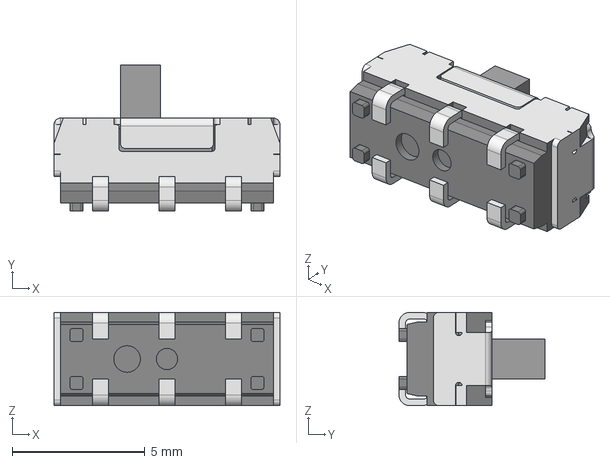
[picture p98: CAD file, 2025-12-28]
SparkFun-KiCad-Libraries-main/Footprints/SparkFun-3D-models/Switch/Slide_DPDT_SMD_9.0x3.6mm.step
8.50 x 5.50 x 3.50 mm
2Top setting_s
22A-01_c
