zoubworldArduino/KiCad_PersoLibrary/SparkFun-KiCad-Libraries-main/Footprints/SparkFun-3D-models/Connector/JST_SMD_1.0mm-5.STEP

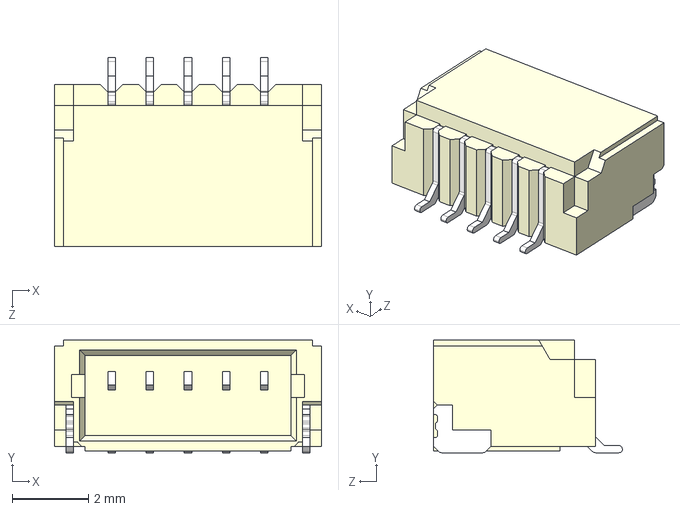
[picture p99: CAD file, 2025-12-28]
SparkFun-KiCad-Libraries-main/Footprints/SparkFun-3D-models/Connector/JST_SMD_1.0mm-5.STEP
7.00 x 2.95 x 4.95 mm
