zoubworldArduino/KiCad_PersoLibrary/SparkFun-KiCad-Libraries-main/Footprints/SparkFun-3D-models/Sensor/STCC4.step

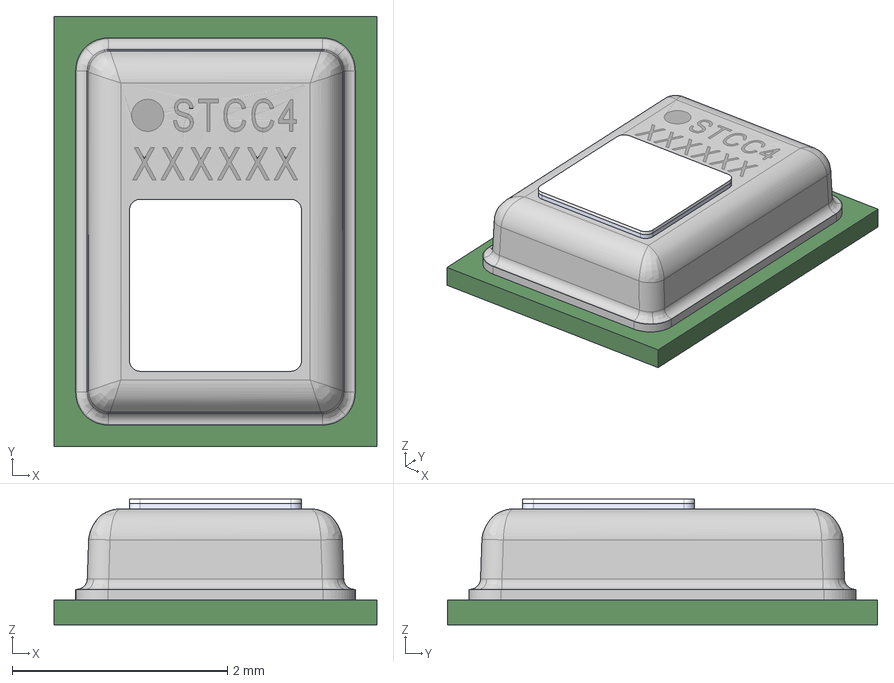
[picture p101: CAD file, 2025-12-28]
SparkFun-KiCad-Libraries-main/Footprints/SparkFun-3D-models/Sensor/STCC4.step
3.00 x 4.00 x 1.17 mm
NYOS_BOND_8PADS_Nyos_ASIC-1_00
Manoun_B01_BOARD_00
167450_Standard
167449_Standard
