zoubworldArduino/KiCad_PersoLibrary/SparkFun-KiCad-Libraries-main/Footprints/SparkFun-3D-models/Switch/Tactal Switch - THRU(12mmx12mmx8mm)-Black.stp

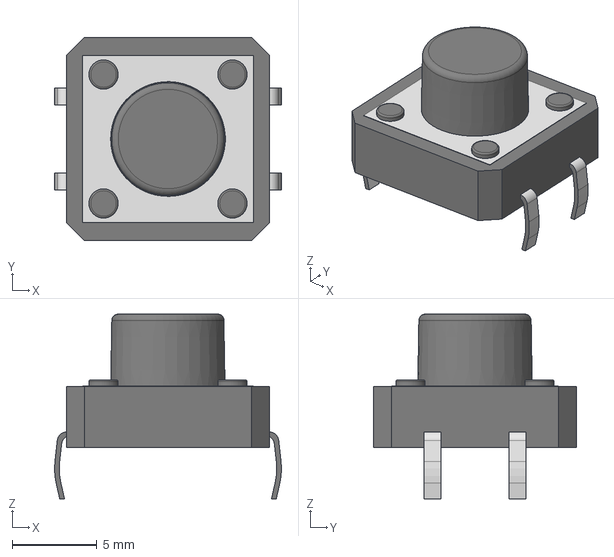
[picture p102: CAD file, 2025-12-28]
SparkFun-KiCad-Libraries-main/Footprints/SparkFun-3D-models/Switch/Tactal Switch - THRU(12mmx12mmx8mm)-Black.stp
13.4 x 12.0 x 10.9 mm
