zoubworldArduino/KiCad_PersoLibrary/SparkFun-KiCad-Libraries-main/Footprints/SparkFun-3D-models/Connector/JST_SMD_1.0mm-9.STEP

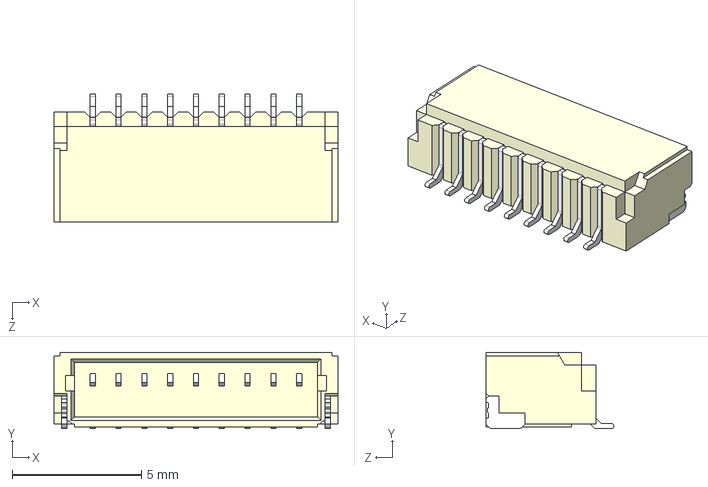
[picture p103: CAD file, 2025-12-28]
SparkFun-KiCad-Libraries-main/Footprints/SparkFun-3D-models/Connector/JST_SMD_1.0mm-9.STEP
11.0 x 2.96 x 4.95 mm
