zoubworldArduino/KiCad_PersoLibrary/SparkFun-KiCad-Libraries-main/Footprints/SparkFun-3D-models/GPS/Quectel_LS550G.step

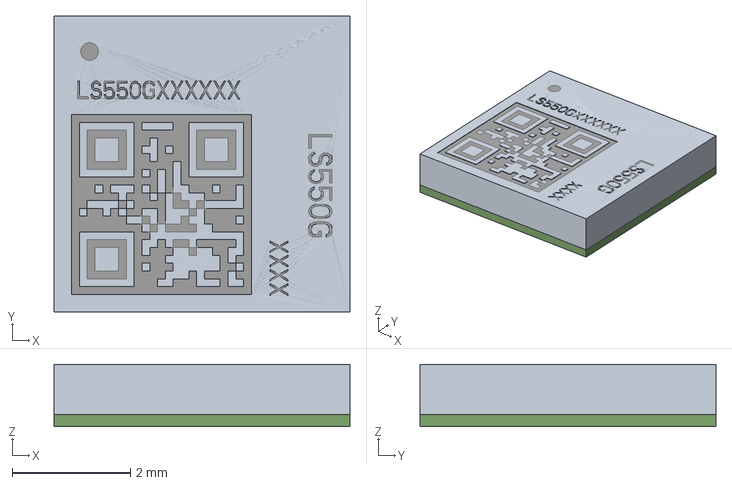
[picture p104: CAD file, 2025-12-28]
SparkFun-KiCad-Libraries-main/Footprints/SparkFun-3D-models/GPS/Quectel_LS550G.step
5.00 x 5.00 x 1.05 mm
