zoubworldArduino/KiCad_PersoLibrary/SparkFun-KiCad-Libraries-main/Footprints/SparkFun-3D-models/Switch/Slide_DPDT_SMD_7.2x3.5mm.step

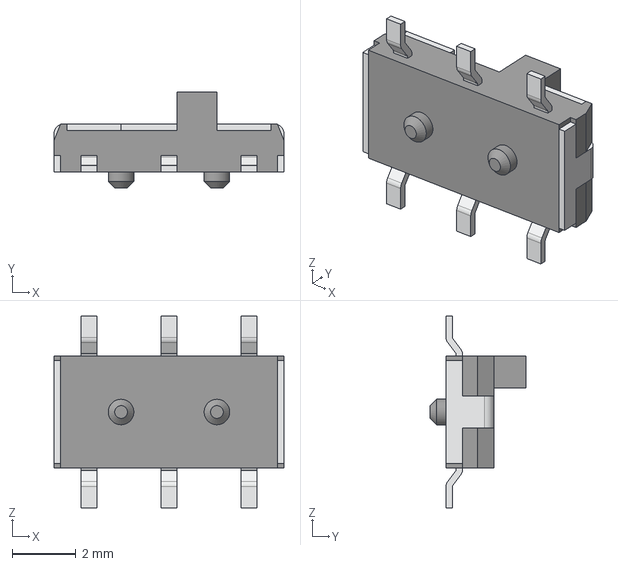
[picture p107: CAD file, 2025-12-28]
SparkFun-KiCad-Libraries-main/Footprints/SparkFun-3D-models/Switch/Slide_DPDT_SMD_7.2x3.5mm.step
7.20 x 3.00 x 6.00 mm
