zoubworldArduino/KiCad_PersoLibrary/SparkFun-KiCad-Libraries-main/Footprints/SparkFun-3D-models/Connector/PinHeader_1x06_P2.54mm_Horizontal_SMD_Right.step

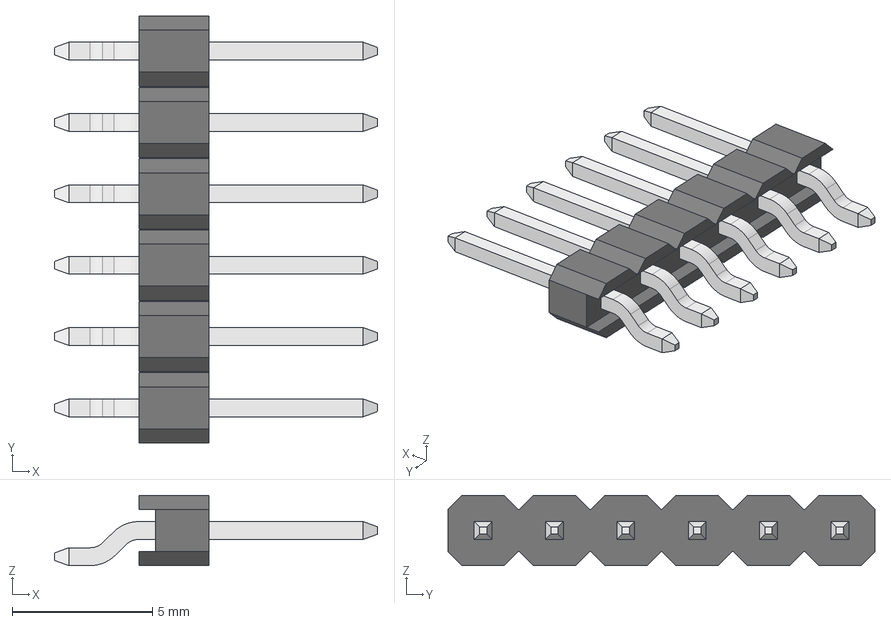
[picture p108: CAD file, 2025-12-28]
SparkFun-KiCad-Libraries-main/Footprints/SparkFun-3D-models/Connector/PinHeader_1x06_P2.54mm_Horizontal_SMD_Right.step
11.5 x 15.2 x 2.50 mm
Plastic
PinMetal x 6
