zoubworldArduino/KiCad_PersoLibrary/SparkFun-KiCad-Libraries-main/Footprints/SparkFun-3D-models/GPS/Quectel_LG290P.step

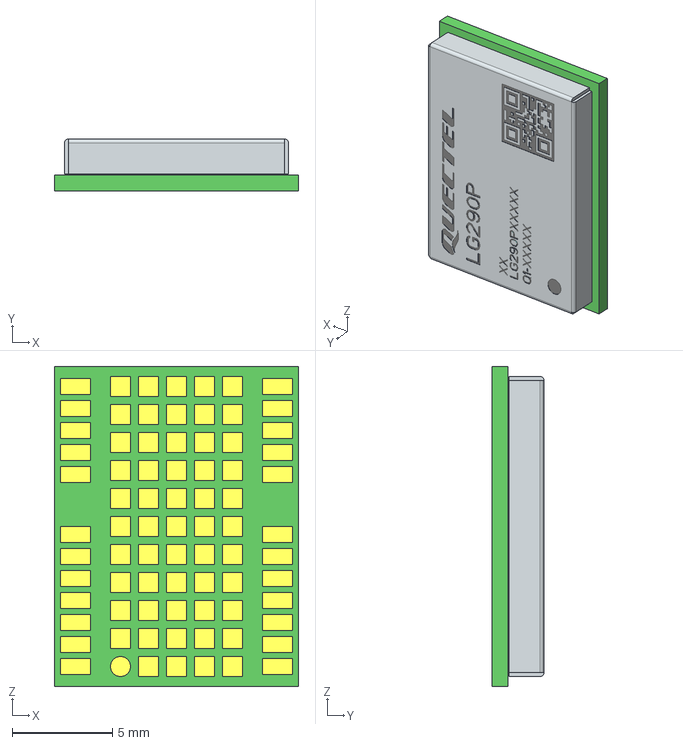
[picture p109: CAD file, 2025-12-28]
SparkFun-KiCad-Libraries-main/Footprints/SparkFun-3D-models/GPS/Quectel_LG290P.step
12.2 x 2.60 x 16.0 mm
