zoubworldArduino/KiCad_PersoLibrary/SparkFun-KiCad-Libraries-main/Footprints/SparkFun-3D-models/Semiconductor-Standard/VSSOP-8_2.3x2mm_P0.5mm.step

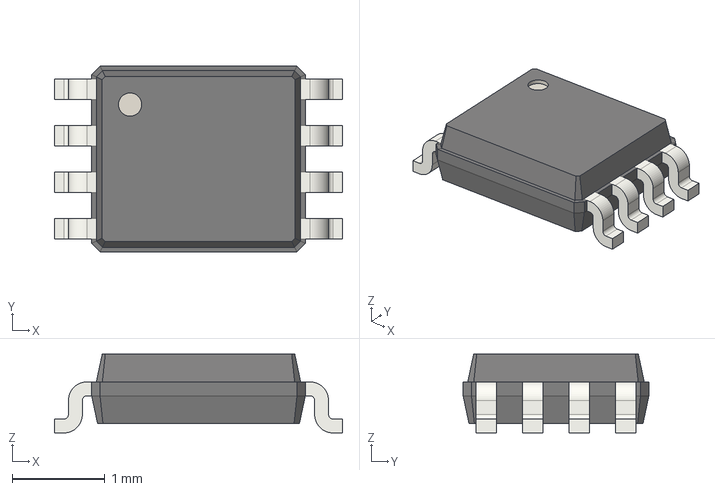
[picture p110: CAD file, 2025-12-28]
SparkFun-KiCad-Libraries-main/Footprints/SparkFun-3D-models/Semiconductor-Standard/VSSOP-8_2.3x2mm_P0.5mm.step
3.10 x 2.00 x 0.85 mm
