zoubworldArduino/KiCad_PersoLibrary/SparkFun-KiCad-Libraries-main/Footprints/SparkFun-3D-models/Switch/Push_SMD_RA_4.5x3.4mm.stp

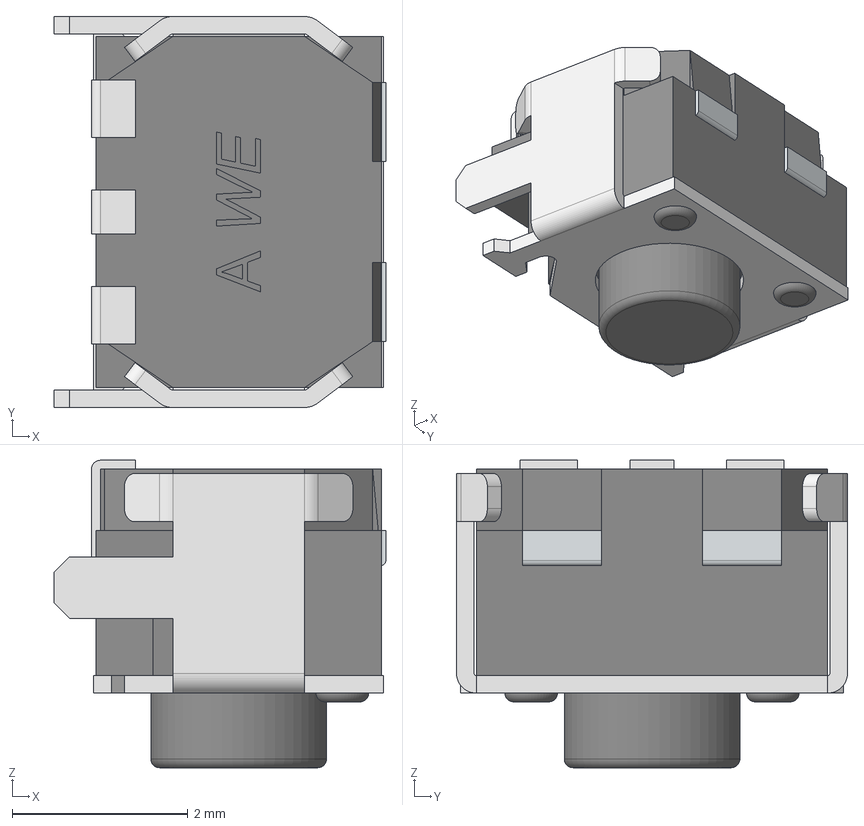
[picture p111: CAD file, 2025-12-28]
SparkFun-KiCad-Libraries-main/Footprints/SparkFun-3D-models/Switch/Push_SMD_RA_4.5x3.4mm.stp
3.78 x 4.45 x 3.50 mm
frame
stem
cover
pins
pin2 x 2
