zoubworldArduino/KiCad_PersoLibrary/SparkFun-KiCad-Libraries-main/Footprints/SparkFun-3D-models/Connector/JST_SM12B-SRSS-TB.step

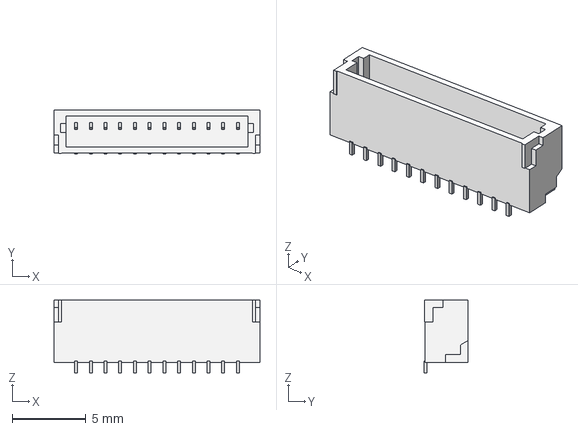
[picture p112: CAD file, 2025-12-28]
SparkFun-KiCad-Libraries-main/Footprints/SparkFun-3D-models/Connector/JST_SM12B-SRSS-TB.step
14.0 x 2.96 x 4.95 mm
