zoubworldArduino/KiCad_PersoLibrary/SparkFun-KiCad-Libraries-main/Footprints/SparkFun-3D-models/GPS/Quectel_LC762Z.step

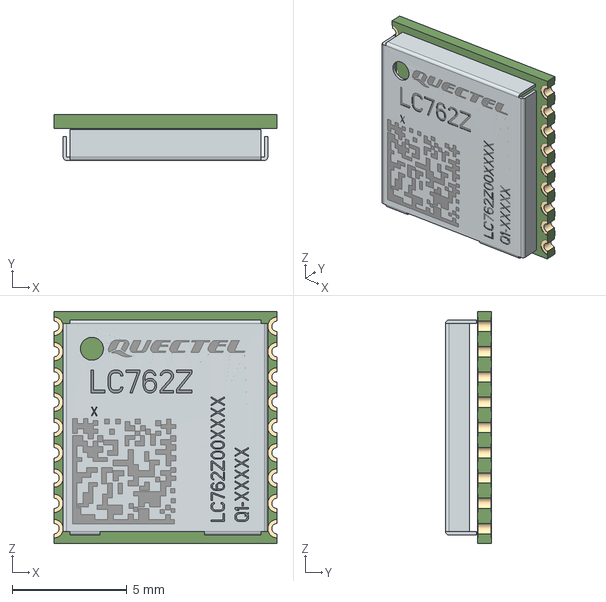
[picture p113: CAD file, 2025-12-28]
SparkFun-KiCad-Libraries-main/Footprints/SparkFun-3D-models/GPS/Quectel_LC762Z.step
9.70 x 2.00 x 10.1 mm
L76K-PCB-V1-3_7
L76C_COVER_V1-3_11
