zoubworldArduino/KiCad_PersoLibrary/SparkFun-KiCad-Libraries-main/Footprints/SparkFun-3D-models/Semiconductor-Standard/QFN-20_4x4mm_P0.5mm.step

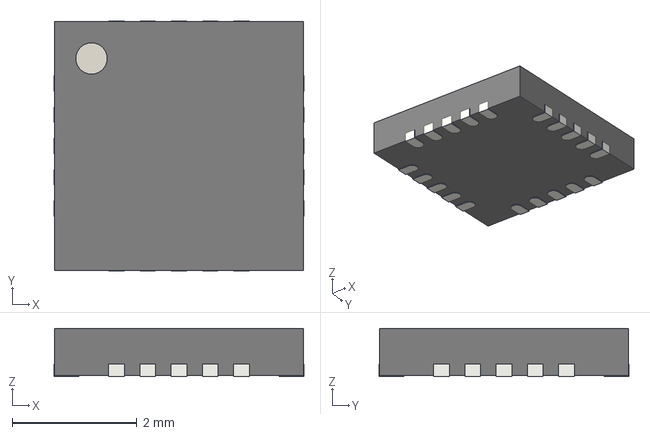
[picture p114: CAD file, 2025-12-28]
SparkFun-KiCad-Libraries-main/Footprints/SparkFun-3D-models/Semiconductor-Standard/QFN-20_4x4mm_P0.5mm.step
4.00 x 4.00 x 0.77 mm
