zoubworldArduino/KiCad_PersoLibrary/SparkFun-KiCad-Libraries-main/Footprints/SparkFun-3D-models/Switch/SW_SPDT_PCM12.step

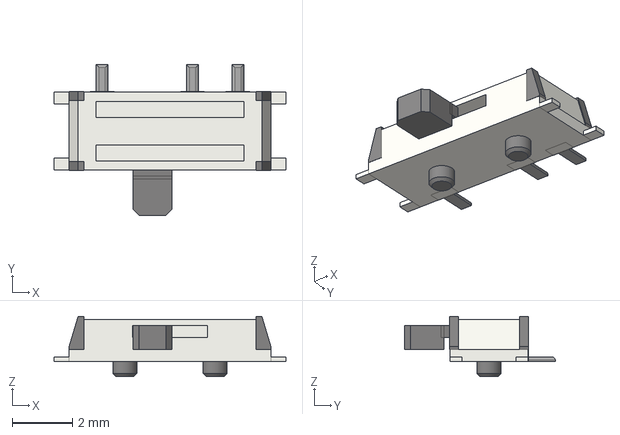
[picture p115: CAD file, 2025-12-28]
SparkFun-KiCad-Libraries-main/Footprints/SparkFun-3D-models/Switch/SW_SPDT_PCM12.step
7.70 x 5.00 x 2.00 mm
