zoubworldArduino/KiCad_PersoLibrary/SparkFun-KiCad-Libraries-main/Footprints/SparkFun-3D-models/Connector/JST_SMD_1.25mm-3_Locking.STEP

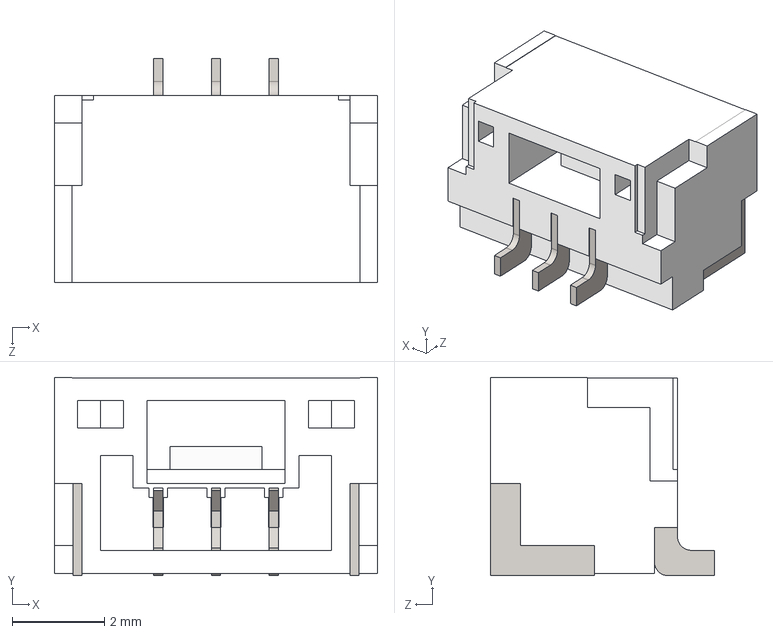
[picture p116: CAD file, 2025-12-28]
SparkFun-KiCad-Libraries-main/Footprints/SparkFun-3D-models/Connector/JST_SMD_1.25mm-3_Locking.STEP
7.00 x 4.30 x 4.85 mm
