zoubworldArduino/KiCad_PersoLibrary/SparkFun-KiCad-Libraries-main/Footprints/SparkFun-3D-models/Semiconductor-Standard/QFN-32-1EP_5x5mm_P0.5mm_EP3.3x3.3mm.step

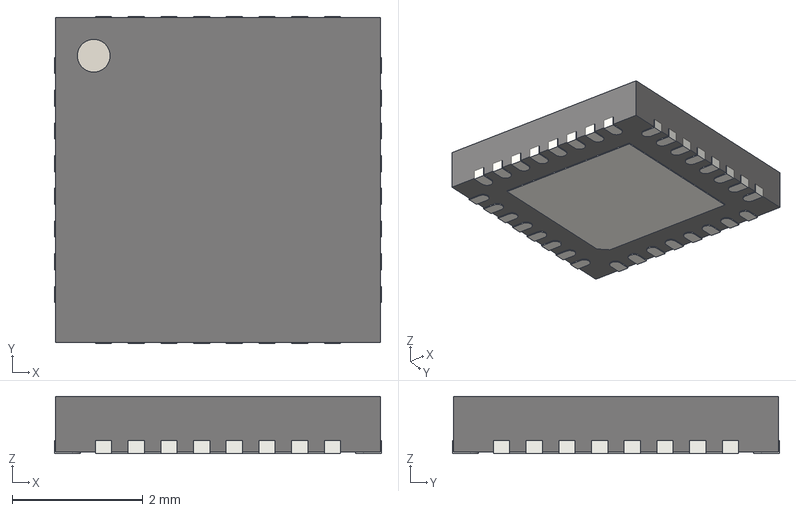
[picture p117: CAD file, 2025-12-28]
SparkFun-KiCad-Libraries-main/Footprints/SparkFun-3D-models/Semiconductor-Standard/QFN-32-1EP_5x5mm_P0.5mm_EP3.3x3.3mm.step
5.00 x 5.00 x 0.875 mm
