zoubworldArduino/KiCad_PersoLibrary/SparkFun-KiCad-Libraries-main/Footprints/SparkFun-3D-models/Switch/Push_SMD_4.6x2.8mm_h1.9mm-Oval.step

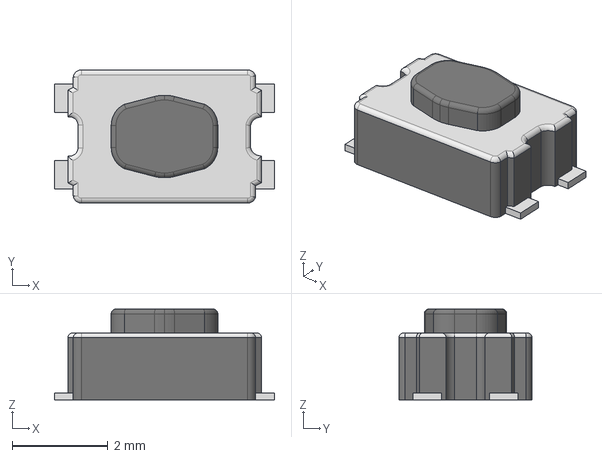
[picture p118: CAD file, 2025-12-28]
SparkFun-KiCad-Libraries-main/Footprints/SparkFun-3D-models/Switch/Push_SMD_4.6x2.8mm_h1.9mm-Oval.step
4.60 x 2.78 x 1.90 mm
