zoubworldArduino/KiCad_PersoLibrary/SparkFun-KiCad-Libraries-main/Footprints/SparkFun-3D-models/Connector/2x10_2.0mm_Header_SMD_Pegs-1.0mm_22817.step

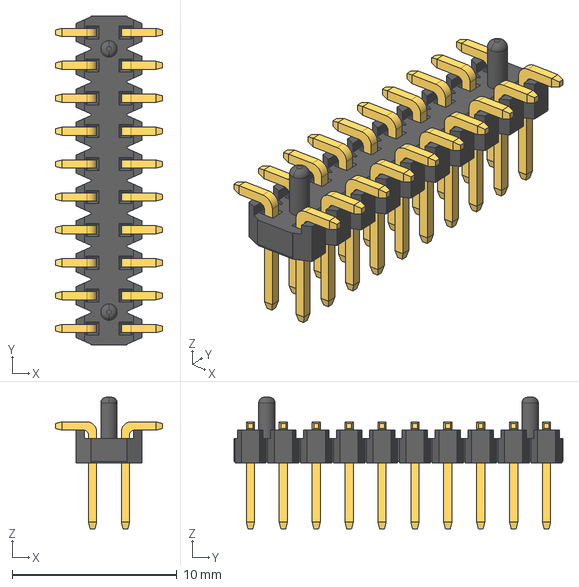
[picture p119: CAD file, 2025-12-28]
SparkFun-KiCad-Libraries-main/Footprints/SparkFun-3D-models/Connector/2x10_2.0mm_Header_SMD_Pegs-1.0mm_22817.step
6.50 x 20.0 x 8.00 mm
05XGHXPW65_4 x 20
JX_PH20_2XNP_H20_DZ1X2_2
