zoubworldArduino/KiCad_PersoLibrary/SparkFun-KiCad-Libraries-main/Footprints/SparkFun-3D-models/LED/APA104-1010.stp

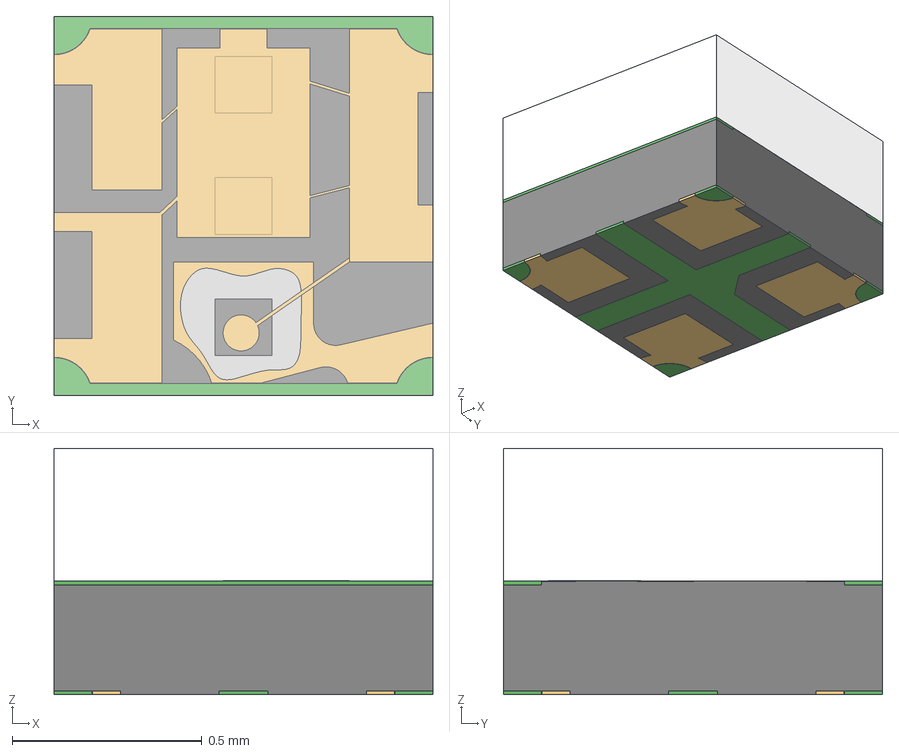
[picture p120: CAD file, 2025-12-28]
SparkFun-KiCad-Libraries-main/Footprints/SparkFun-3D-models/LED/APA104-1010.stp
1.00 x 1.00 x 0.65 mm
Pins
Resin
