zoubworldArduino/KiCad_PersoLibrary/SparkFun-KiCad-Libraries-main/Footprints/SparkFun-3D-models/Semiconductor-Standard/TQFP-32_7x7mm_P0.8mm.step

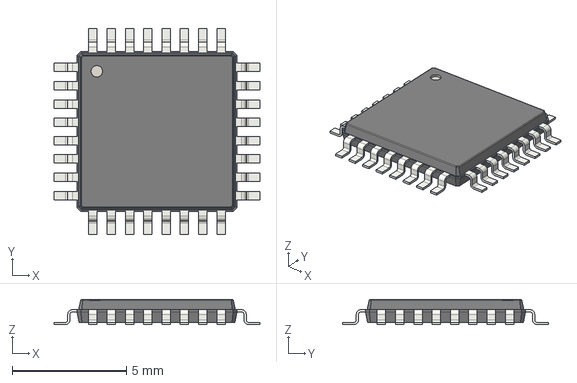
[picture p121: CAD file, 2025-12-28]
SparkFun-KiCad-Libraries-main/Footprints/SparkFun-3D-models/Semiconductor-Standard/TQFP-32_7x7mm_P0.8mm.step
9.00 x 9.00 x 1.10 mm
