zoubworldArduino/KiCad_PersoLibrary/SparkFun-KiCad-Libraries-main/Footprints/SparkFun-3D-models/Switch/Tactal Switch - THRU(12mmx12mm - Illuminated - Red.stp

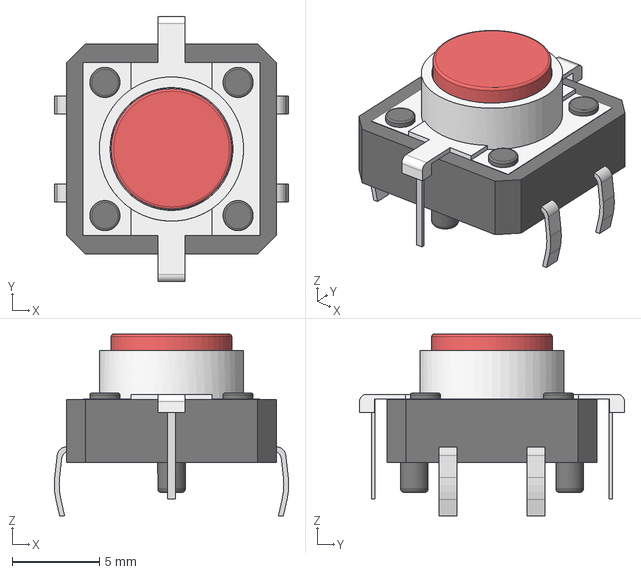
[picture p122: CAD file, 2025-12-28]
SparkFun-KiCad-Libraries-main/Footprints/SparkFun-3D-models/Switch/Tactal Switch - THRU(12mmx12mm - Illuminated - Red.stp
13.4 x 15.2 x 10.4 mm
