zoubworldArduino/KiCad_PersoLibrary/SparkFun-KiCad-Libraries-main/Footprints/SparkFun-3D-models/Connector/1x04_RA_SMD.step

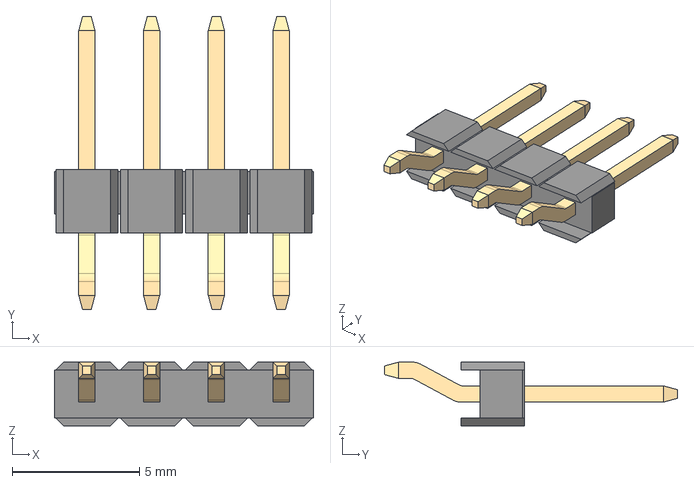
[picture p123: CAD file, 2025-12-28]
SparkFun-KiCad-Libraries-main/Footprints/SparkFun-3D-models/Connector/1x04_RA_SMD.step
10.2 x 11.5 x 2.50 mm
M20-88904_MOULD
M20-889_CONTACT x 4
