zoubworldArduino/KiCad_PersoLibrary/SparkFun-KiCad-Libraries-main/Footprints/SparkFun-3D-models/Switch/Navigation_SMD_9.9x9.9mm.step

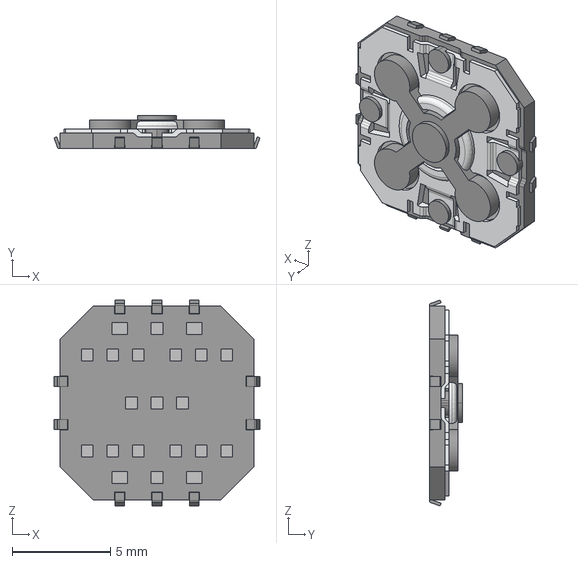
[picture p124: CAD file, 2025-12-28]
SparkFun-KiCad-Libraries-main/Footprints/SparkFun-3D-models/Switch/Navigation_SMD_9.9x9.9mm.step
10.5 x 1.70 x 10.5 mm
