zoubworldArduino/KiCad_PersoLibrary/SparkFun-KiCad-Libraries-main/Footprints/SparkFun-3D-models/Connector/2x10_2.0mm_Header_SMD_Peg-1.0mm.stp

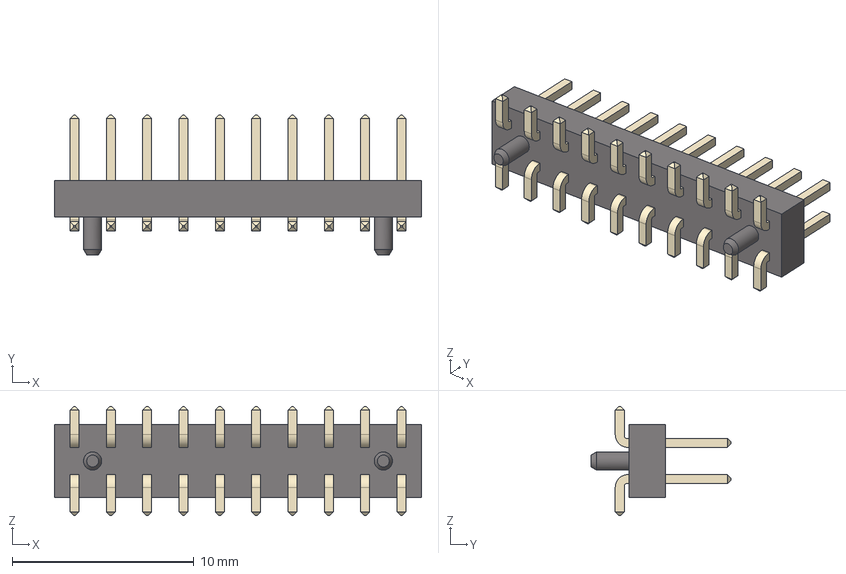
[picture p125: CAD file, 2025-12-28]
SparkFun-KiCad-Libraries-main/Footprints/SparkFun-3D-models/Connector/2x10_2.0mm_Header_SMD_Peg-1.0mm.stp
20.2 x 7.70 x 6.00 mm
PIN x 20
