zoubworldArduino/KiCad_PersoLibrary/SparkFun-KiCad-Libraries-main/Footprints/SparkFun-3D-models/LED/WS2812-2020.STEP

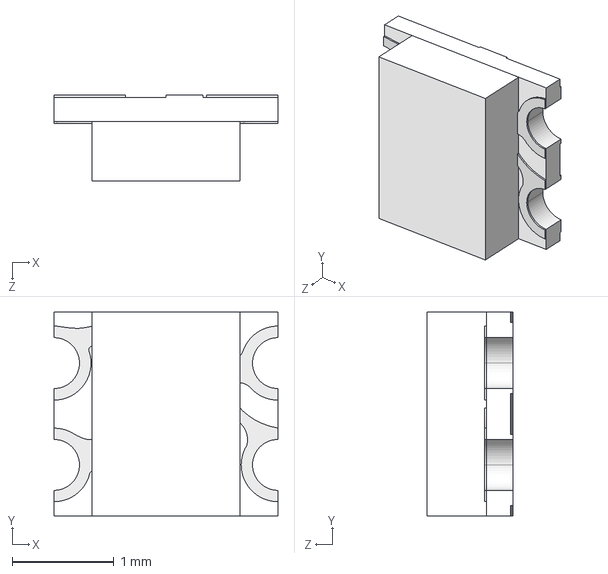
[picture p126: CAD file, 2025-12-28]
SparkFun-KiCad-Libraries-main/Footprints/SparkFun-3D-models/LED/WS2812-2020.STEP
2.20 x 2.00 x 0.84 mm
