zoubworldArduino/KiCad_PersoLibrary/SparkFun-KiCad-Libraries-main/Footprints/SparkFun-3D-models/Semiconductor-Standard/LGA-16_3x3x1mm.step

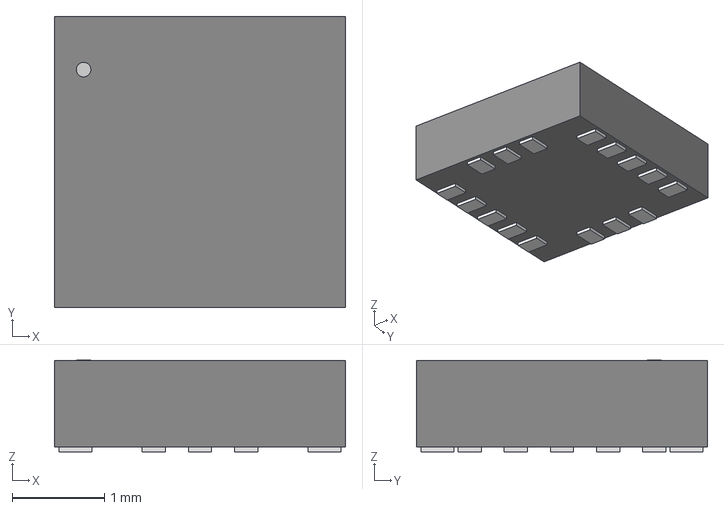
[picture p127: CAD file, 2025-12-28]
SparkFun-KiCad-Libraries-main/Footprints/SparkFun-3D-models/Semiconductor-Standard/LGA-16_3x3x1mm.step
3.15 x 3.15 x 0.993 mm
