zoubworldArduino/KiCad_PersoLibrary/SparkFun-KiCad-Libraries-main/Footprints/SparkFun-3D-models/Connector/microSD_External_Pin.step

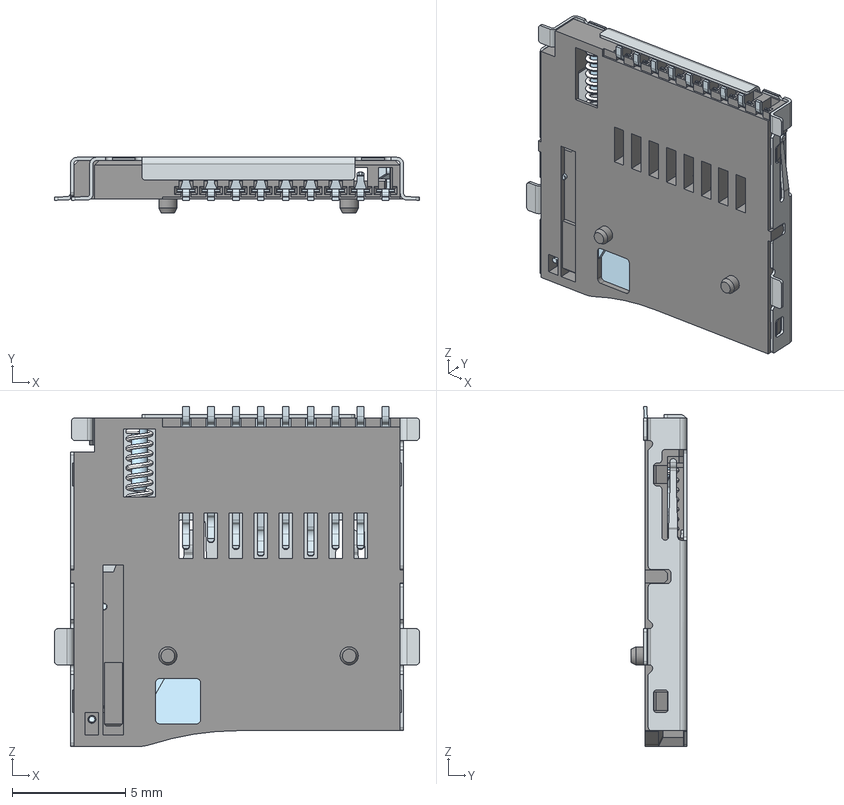
[picture p129: CAD file, 2025-12-28]
SparkFun-KiCad-Libraries-main/Footprints/SparkFun-3D-models/Connector/microSD_External_Pin.step
16.1 x 2.45 x 15.0 mm
