zoubworldArduino/KiCad_PersoLibrary/SparkFun-KiCad-Libraries-main/Footprints/SparkFun-3D-models/Switch/Navigation_SMD_7.5x7.5mm.step

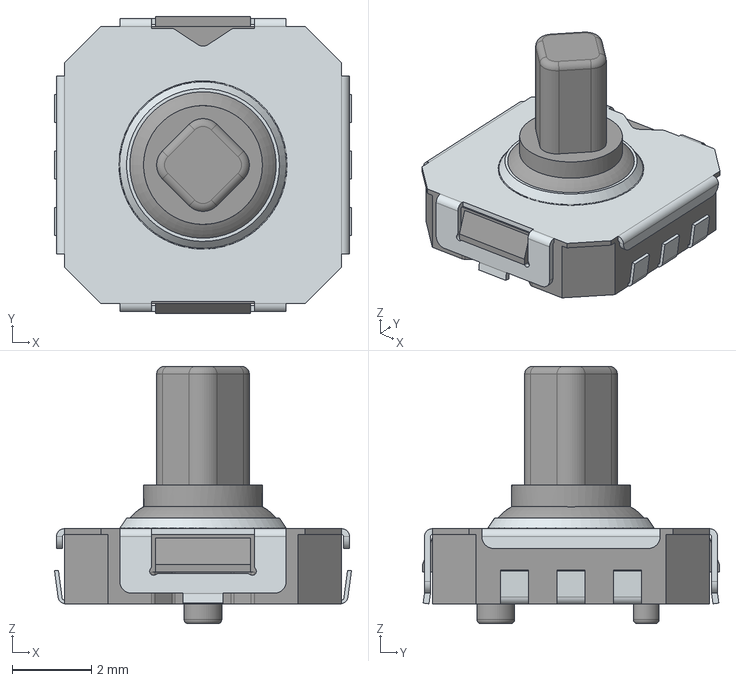
[picture p131: CAD file, 2025-12-28]
SparkFun-KiCad-Libraries-main/Footprints/SparkFun-3D-models/Switch/Navigation_SMD_7.5x7.5mm.step
7.50 x 7.50 x 6.50 mm
