zoubworldArduino/KiCad_PersoLibrary/SparkFun-KiCad-Libraries-main/Footprints/SparkFun-3D-models/Semiconductor-Standard/QFN-80-1EP_10x10mm_P0.4mm_EP3.4x3.4mm.step

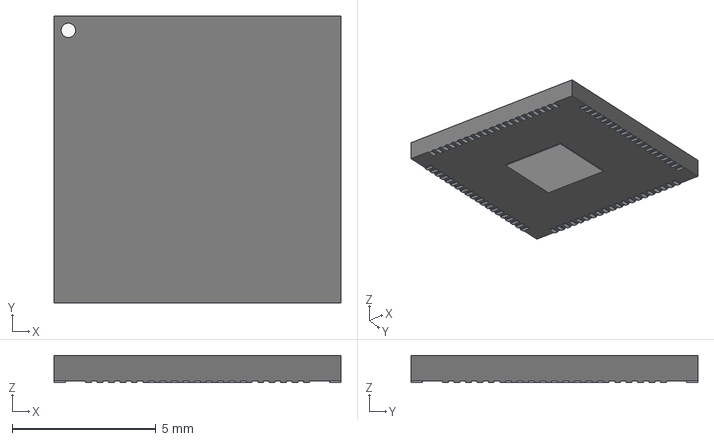
[picture p133: CAD file, 2025-12-28]
SparkFun-KiCad-Libraries-main/Footprints/SparkFun-3D-models/Semiconductor-Standard/QFN-80-1EP_10x10mm_P0.4mm_EP3.4x3.4mm.step
10.0 x 10.0 x 0.95 mm
