zoubworldArduino/KiCad_PersoLibrary/SparkFun-KiCad-Libraries-main/Footprints/SparkFun-3D-models/Connector/PinHeader_1x09_P2.54mm_Vertical.step

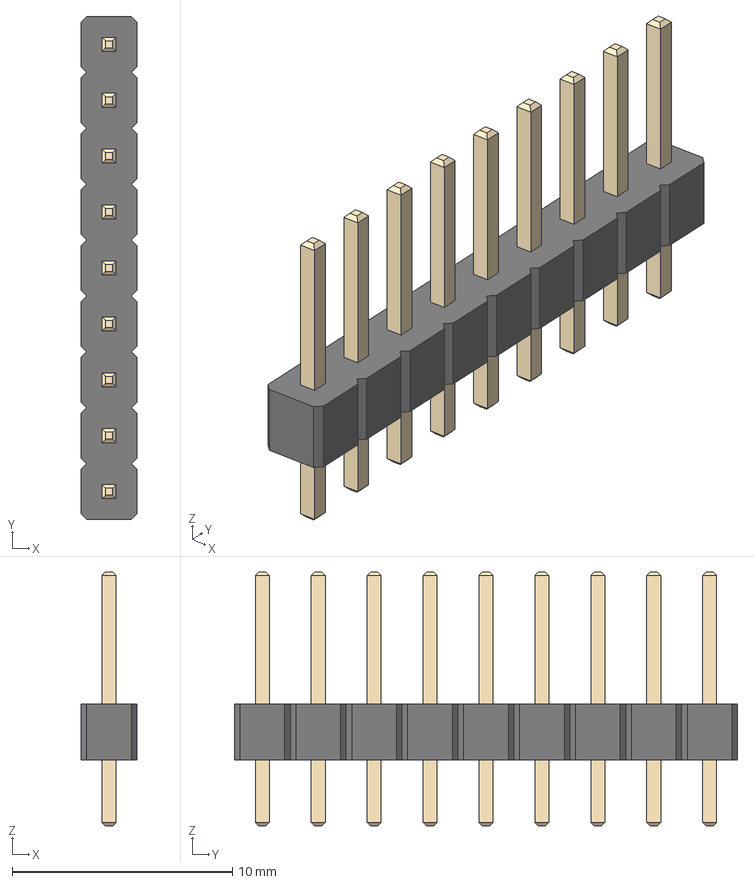
[picture p135: CAD file, 2025-12-28]
SparkFun-KiCad-Libraries-main/Footprints/SparkFun-3D-models/Connector/PinHeader_1x09_P2.54mm_Vertical.step
2.54 x 22.9 x 11.5 mm
