zoubworldArduino/KiCad_PersoLibrary/SparkFun-KiCad-Libraries-main/Footprints/SparkFun-3D-models/Switch/Slide_SPDT_PTH_11.6x4.0mm.step

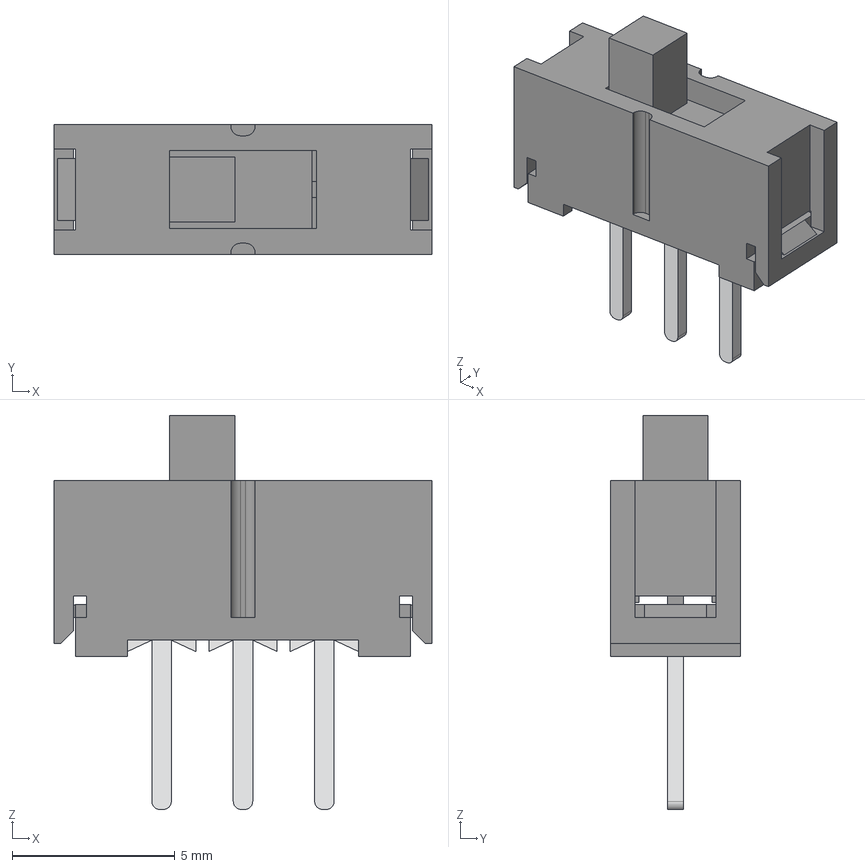
[picture p137: CAD file, 2025-12-28]
SparkFun-KiCad-Libraries-main/Footprints/SparkFun-3D-models/Switch/Slide_SPDT_PTH_11.6x4.0mm.step
11.6 x 4.00 x 12.1 mm
