zoubworldArduino/KiCad_PersoLibrary/SparkFun-KiCad-Libraries-main/Footprints/SparkFun-3D-models/Connector/FPC_2x12-1MP_P0.4mm.stp

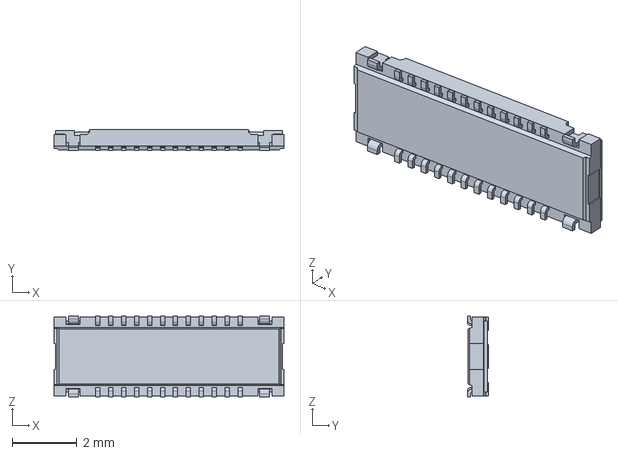
[picture p138: CAD file, 2025-12-28]
SparkFun-KiCad-Libraries-main/Footprints/SparkFun-3D-models/Connector/FPC_2x12-1MP_P0.4mm.stp
7.10 x 0.66 x 2.50 mm
