zoubworldArduino/KiCad_PersoLibrary/SparkFun-KiCad-Libraries-main/Footprints/SparkFun-3D-models/Switch/Slide_DP3T_SMD_9.8x3.5mm.step

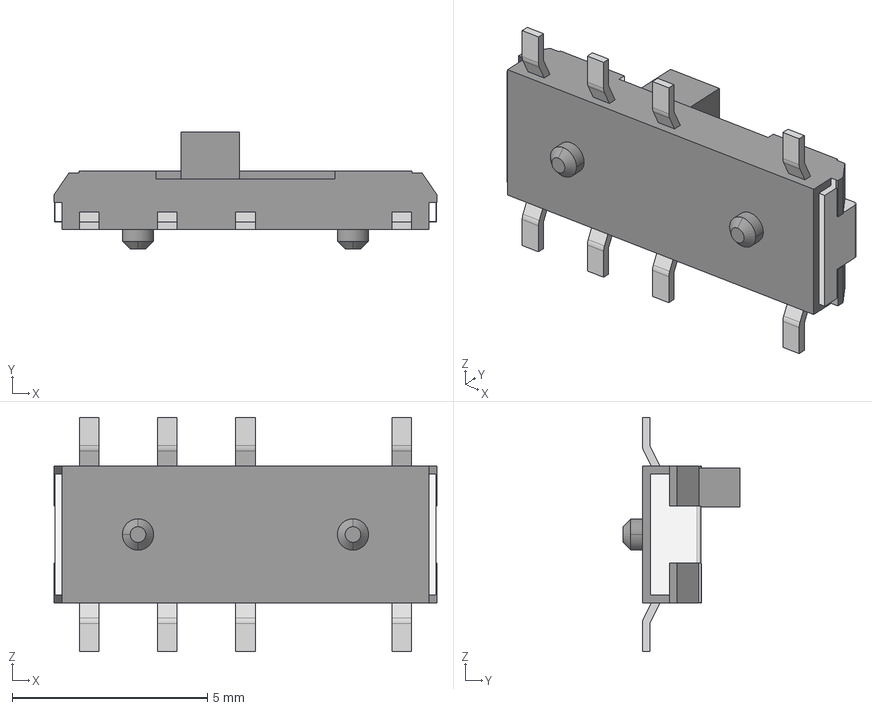
[picture p140: CAD file, 2025-12-28]
SparkFun-KiCad-Libraries-main/Footprints/SparkFun-3D-models/Switch/Slide_DP3T_SMD_9.8x3.5mm.step
9.80 x 3.00 x 6.00 mm
ASSEMBLY_PART12
ASSEMBLY_PART1 x 2
ASSEMBLY_PART7
ASSEMBLY_PART6
ASSEMBLY_PART8
ASSEMBLY_PART4
ASSEMBLY_PART2
ASSEMBLY_PART9
ASSEMBLY_PART5
ASSEMBLY_PART10
ASSEMBLY_PART11
ASSEMBLY_PART3
