zoubworldArduino/KiCad_PersoLibrary/SparkFun-KiCad-Libraries-main/Footprints/SparkFun-3D-models/Connector/Qwiic-Vertical.step

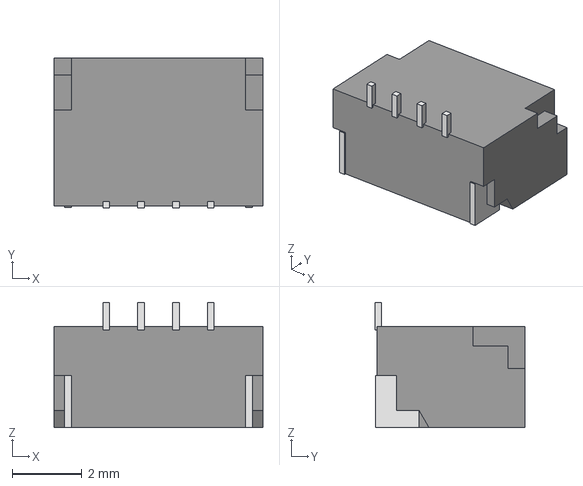
[picture p141: CAD file, 2025-12-28]
SparkFun-KiCad-Libraries-main/Footprints/SparkFun-3D-models/Connector/Qwiic-Vertical.step
6.00 x 4.32 x 3.60 mm
