zoubworldArduino/KiCad_PersoLibrary/SparkFun-KiCad-Libraries-main/Footprints/SparkFun-3D-models/Semiconductor-Standard/QFN-20_3x3mm_P0.5mm.step

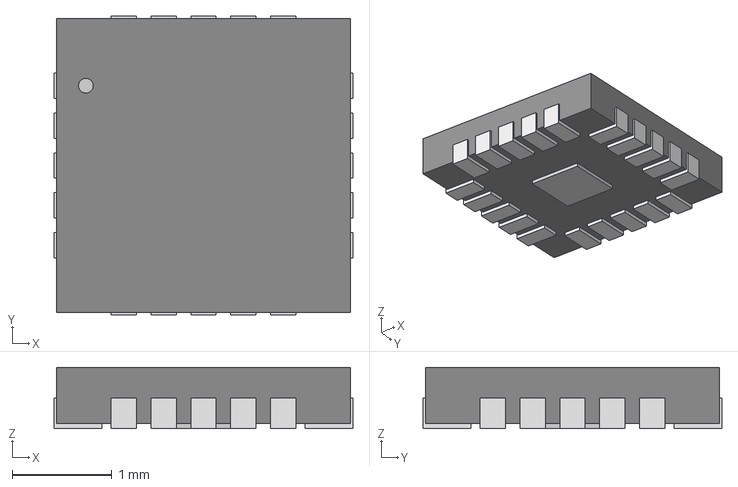
[picture p142: CAD file, 2025-12-28]
SparkFun-KiCad-Libraries-main/Footprints/SparkFun-3D-models/Semiconductor-Standard/QFN-20_3x3mm_P0.5mm.step
3.00 x 3.00 x 0.612 mm
