zoubworldArduino/KiCad_PersoLibrary/SparkFun-KiCad-Libraries-main/Footprints/SparkFun-3D-models/Switch/SW_SP3T_PCM13.step

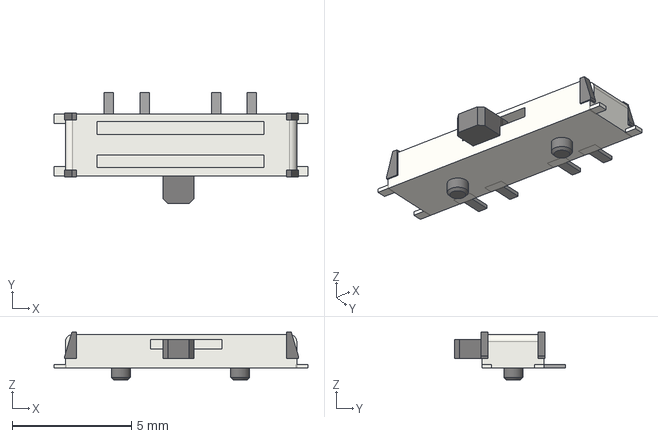
[picture p143: CAD file, 2025-12-28]
SparkFun-KiCad-Libraries-main/Footprints/SparkFun-3D-models/Switch/SW_SP3T_PCM13.step
10.6 x 4.65 x 2.00 mm
