zoubworldArduino/KiCad_PersoLibrary/(list of files, cad)

Other CAD files:
SparkFun-KiCad-Libraries-main/Footprints/SparkFun-3D-models/LED/FreeCAD/LED_5MM/LED_5MM.FCStd
SparkFun-KiCad-Libraries-main/Footprints/SparkFun-3D-models/LED/LED_0402_1005Metric_Blue.step
SparkFun-KiCad-Libraries-main/Footprints/SparkFun-3D-models/LED/LED_0603_1608Metric_Yellow.step
SparkFun-KiCad-Libraries-main/Footprints/SparkFun-3D-models/RF/ESP32-MINI.step
SparkFun-KiCad-Libraries-main/Footprints/SparkFun-3D-models/GPS/Septentrio_mosaic-Rev5.step
SparkFun-KiCad-Libraries-main/Footprints/SparkFun-3D-models/GPS/u-blox_ZED_Generic.step
SparkFun-KiCad-Libraries-main/Footprints/SparkFun-3D-models/LED/LED_0603_1608Metric_Red.STEP
SparkFun-KiCad-Libraries-main/Footprints/SparkFun-3D-models/LED/LED_0603_1608Metric_Orange.step
SparkFun-KiCad-Libraries-main/Footprints/SparkFun-3D-models/LED/LED_0402_1005Metric_Orange.step
SparkFun-KiCad-Libraries-main/Footprints/SparkFun-3D-models/LED/LED_PTH_5mm_Red.step
SparkFun-KiCad-Libraries-main/Footprints/SparkFun-3D-models/LED/LED_1206_3216Metric_Castellated_Pink.step
SparkFun-KiCad-Libraries-main/Footprints/SparkFun-3D-models/LED/LED_1206_3216Metric_Castellated_Yellow.step
SparkFun-KiCad-Libraries-main/Footprints/SparkFun-3D-models/Semiconductor-Standard/QFN-24_4x4mm_P0.5mm.step
SparkFun-KiCad-Libraries-main/Footprints/SparkFun-3D-models/LED/LED_1206_3216Metric_Castellated_White.step
SparkFun-KiCad-Libraries-main/Footprints/SparkFun-3D-models/LED/LED_0402_1005Metric_Green.step
SparkFun-KiCad-Libraries-main/Footprints/SparkFun-3D-models/LED/LED_1206_3216Metric_Castellated_Blue.step
SparkFun-KiCad-Libraries-main/Footprints/SparkFun-3D-models/LED/LED_0603_1608Metric_White.step
SparkFun-KiCad-Libraries-main/Footprints/SparkFun-3D-models/LED/LED_0402_1005Metric_Red.step
SparkFun-KiCad-Libraries-main/Footprints/SparkFun-3D-models/Connector/1x05_2.0mm.step
SparkFun-KiCad-Libraries-main/Footprints/SparkFun-3D-models/Connector/1x05_PTH_2.54mm_8.5mm.step
SparkFun-KiCad-Libraries-main/Footprints/SparkFun-3D-models/Connector/1x07_2.0mm.step
SparkFun-KiCad-Libraries-main/Footprints/SparkFun-3D-models/Connector/1x07_2.0mm_SMD_Pin1RightDown.step
SparkFun-KiCad-Libraries-main/Footprints/SparkFun-3D-models/Connector/1x08_SMD_Pin1RightDown.step
SparkFun-KiCad-Libraries-main/Footprints/SparkFun-3D-models/Connector/1x09_PTH_2.54mm_8.5mm.step
SparkFun-KiCad-Libraries-main/Footprints/SparkFun-3D-models/Connector/1x10_2.0mm.step
SparkFun-KiCad-Libraries-main/Footprints/SparkFun-3D-models/Connector/1x10_SMD_Pin1RightDown.step
SparkFun-KiCad-Libraries-main/Footprints/SparkFun-3D-models/Connector/1x20_2.54mm_SMD_Pin1RightUp.step
SparkFun-KiCad-Libraries-main/Footprints/SparkFun-3D-models/Connector/2x05_P1.27mm_SMD_Unshrouded.step
SparkFun-KiCad-Libraries-main/Footprints/SparkFun-3D-models/Connector/2x10_2.0mm_Socket_SMD_Peg-1.1x0.8mm.stp
SparkFun-KiCad-Libraries-main/Footprints/SparkFun-3D-models/Connector/2x10_2.0mm_Socket_SMD_Pegs-1.0mm_22815.step
SparkFun-KiCad-Libraries-main/Footprints/SparkFun-3D-models/Connector/2x10_2.54mm_Socket_SMD.STEP
SparkFun-KiCad-Libraries-main/Footprints/SparkFun-3D-models/Connector/2x20_P2.54mm_Socket_SMD_RA.stp
SparkFun-KiCad-Libraries-main/Footprints/SparkFun-3D-models/Connector/Audio_Jack_3.5mm_TRRS_SMD_RA.step
SparkFun-KiCad-Libraries-main/Footprints/SparkFun-3D-models/Connector/DE9-Female.step
SparkFun-KiCad-Libraries-main/Footprints/SparkFun-3D-models/Connector/DE9-Male.step
SparkFun-KiCad-Libraries-main/Footprints/SparkFun-3D-models/Connector/FPC_0.3mm-21.stp
SparkFun-KiCad-Libraries-main/Footprints/SparkFun-3D-models/Connector/FPC_0.5mm-12.stp
SparkFun-KiCad-Libraries-main/Footprints/SparkFun-3D-models/Connector/FPC_0.5mm-24-BottomContact.step
SparkFun-KiCad-Libraries-main/Footprints/SparkFun-3D-models/Connector/JST_SM14B-SRSS-TB.STEP
SparkFun-KiCad-Libraries-main/Footprints/SparkFun-3D-models/Connector/JST_SMD_1.0mm-3.STEP
SparkFun-KiCad-Libraries-main/Footprints/SparkFun-3D-models/Connector/JST_SMD_1.0mm-3_Vertical.STEP
SparkFun-KiCad-Libraries-main/Footprints/SparkFun-3D-models/Connector/JST_SMD_1.0mm-4.STEP
SparkFun-KiCad-Libraries-main/Footprints/SparkFun-3D-models/Connector/JST_SMD_1.0mm-6.STEP
SparkFun-KiCad-Libraries-main/Footprints/SparkFun-3D-models/Connector/JST_SMD_1.0mm-6_Vertical.STEP
SparkFun-KiCad-Libraries-main/Footprints/SparkFun-3D-models/Connector/JST_SMD_1.0mm-8.STEP
SparkFun-KiCad-Libraries-main/Footprints/SparkFun-3D-models/Connector/JST_SMD_1.25mm-4_Locking.step
SparkFun-KiCad-Libraries-main/Footprints/SparkFun-3D-models/Connector/JST_SMD_1.25mm-6_Locking.step
SparkFun-KiCad-Libraries-main/Footprints/SparkFun-3D-models/Connector/JST_SMD_1.25mm-7_Locking.STEP
SparkFun-KiCad-Libraries-main/Footprints/SparkFun-3D-models/Connector/JST_SMD_1.25mm-8_Locking.STEP
SparkFun-KiCad-Libraries-main/Footprints/SparkFun-3D-models/Connector/JST_SMD_2.0mm-2-Black.step
SparkFun-KiCad-Libraries-main/Footprints/SparkFun-3D-models/Connector/MagJack_PoE_RJ45.STEP
SparkFun-KiCad-Libraries-main/Footprints/SparkFun-3D-models/Connector/PinHeader_1x01_P2.54mm_Vertical.step
SparkFun-KiCad-Libraries-main/Footprints/SparkFun-3D-models/Connector/PinHeader_1x02_P2.54mm_Vertical.step
SparkFun-KiCad-Libraries-main/Footprints/SparkFun-3D-models/Connector/PinHeader_1x03_P2.54mm_Vertical.step
SparkFun-KiCad-Libraries-main/Footprints/SparkFun-3D-models/Connector/PinHeader_1x05_P2.54mm_Vertical.step
SparkFun-KiCad-Libraries-main/Footprints/SparkFun-3D-models/Connector/PinHeader_1x07_P2.54mm_Vertical.step
SparkFun-KiCad-Libraries-main/Footprints/SparkFun-3D-models/Connector/PinHeader_1x08_P2.54mm_Vertical.step
SparkFun-KiCad-Libraries-main/Footprints/SparkFun-3D-models/Connector/PinSocket_1x08_P2.54mm_Vertical_SMD_Pin1Right.step
SparkFun-KiCad-Libraries-main/Footprints/SparkFun-3D-models/Connector/Power_Jack_PTH.step
SparkFun-KiCad-Libraries-main/Footprints/SparkFun-3D-models/Connector/Power_Jack_SMD.step
SparkFun-KiCad-Libraries-main/Footprints/SparkFun-3D-models/Connector/Qwiic-Horizontal-White.STEP
SparkFun-KiCad-Libraries-main/Footprints/SparkFun-3D-models/Connector/Qwiic-Horizontal.STEP
SparkFun-KiCad-Libraries-main/Footprints/SparkFun-3D-models/Connector/RP-SMA-Edge.step
SparkFun-KiCad-Libraries-main/Footprints/SparkFun-3D-models/Connector/Raspberry_Pi_Passthrough_Header.step
SparkFun-KiCad-Libraries-main/Footprints/SparkFun-3D-models/Connector/Screw_Terminal_3.5mm_2P_Black.step
SparkFun-KiCad-Libraries-main/Footprints/SparkFun-3D-models/Connector/Screw_Terminal_3.5mm_2P_Blue.step
SparkFun-KiCad-Libraries-main/Footprints/SparkFun-3D-models/Connector/Screw_Terminal_3.5mm_3P_Black.step
SparkFun-KiCad-Libraries-main/Footprints/SparkFun-3D-models/Connector/Screw_Terminal_3.5mm_3P_Blue.step
SparkFun-KiCad-Libraries-main/Footprints/SparkFun-3D-models/Connector/USB-C_16.step
SparkFun-KiCad-Libraries-main/Footprints/SparkFun-3D-models/Connector/microSD_Friction_Fit-Empty.step
SparkFun-KiCad-Libraries-main/Footprints/SparkFun-3D-models/Connector/microSD_Friction_Fit.step
SparkFun-KiCad-Libraries-main/Footprints/SparkFun-3D-models/Hardware/Nut_4-40.step
SparkFun-KiCad-Libraries-main/Footprints/SparkFun-3D-models/Hardware/Nut_M3.step
SparkFun-KiCad-Libraries-main/Footprints/SparkFun-3D-models/Hardware/Screw_4-40.step
SparkFun-KiCad-Libraries-main/Footprints/SparkFun-3D-models/Hardware/Screw_M3.step
SparkFun-KiCad-Libraries-main/Footprints/SparkFun-3D-models/LED/CBI_LED_Triple_3mm_PTH.step
SparkFun-KiCad-Libraries-main/Footprints/SparkFun-3D-models/LED/LED_0603_1608Metric_Blue.STEP
SparkFun-KiCad-Libraries-main/Footprints/SparkFun-3D-models/LED/LED_1206_3216Metric_Castellated_Orange.step
SparkFun-KiCad-Libraries-main/Footprints/SparkFun-3D-models/LED/LED_1206_3216Metric_Castellated_Red.step
SparkFun-KiCad-Libraries-main/Footprints/SparkFun-3D-models/Semiconductor-Standard/BGA_10x10mm_P0.65mm.step
SparkFun-KiCad-Libraries-main/Footprints/SparkFun-3D-models/Semiconductor-Standard/DFN-8-1EP_2x2mm_P0.5mm_EP1.05x1.75mm.step
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
