zoubworldArduino/KiCad_PersoLibrary/Zoub_Lib/RN4678-VRM122/RN4678_v1.00.5_041217/RN4678_v1.00.5_111516/Configuration Validation/RN4678-config-validation.pdf

RN4678 (SPP) firmware 1.00.5 Configuration

To set factory default, issue the follow commands

SF,1
R,1

The following V (version) and D (display basic configuration) should display as shown in screen shot:

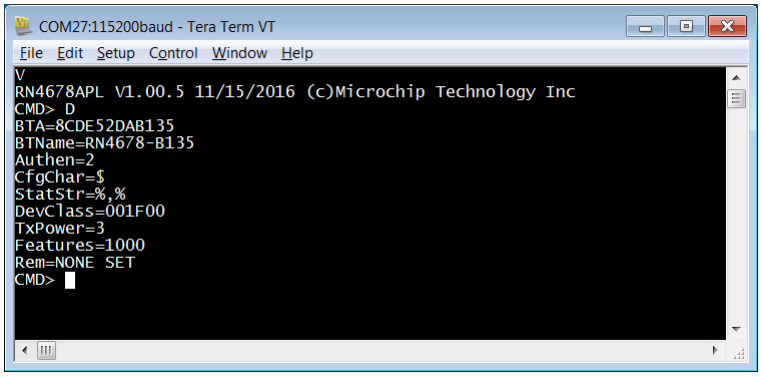
[picture p148: figure]
