zoubworldArduino/KiCad_PersoLibrary/Zoub_Lib/RN4678-VRM122/RN4678_v1.00.5_041217/RN4678_v1.00.5_111516/Release Note/rn4678_v1.05_release_notes.pdf

### RN4678 v1.00.05 11/15/2016 RELEASE NOTES

New:
1. Merged 1.31 BM78 fixes into RN4678.
2. Added “GP” command to return pin code.
3. “D” Command displays the RN4678 features value of “GQ” command.
4. Bluetooth name (Classic/BLE) restored to default RN4678-B1B0 on factory reset.
Fixes:
1. Fixed forced bonding issue for BLE in Just Works.
2. “S-” and “SN” commands will set both BLE and Classic names.
3. Authentication modes for BLE are updated to reflect the selected mode.
4. Fixed reboot issue on “G:,a3a2a1a0,00”.
Known Issues:
1.
