zoubworldArduino/KiCad_PersoLibrary/KiCad-master/Arduino_MEGA_2560-Rev3/Arduino_MEGA_2560-Rev3.kicad_pcb

## KiCad design KiCad-master/Arduino_MEGA_2560-Rev3/Arduino_MEGA_2560-Rev3.kicad_pcb (2025-12-28)

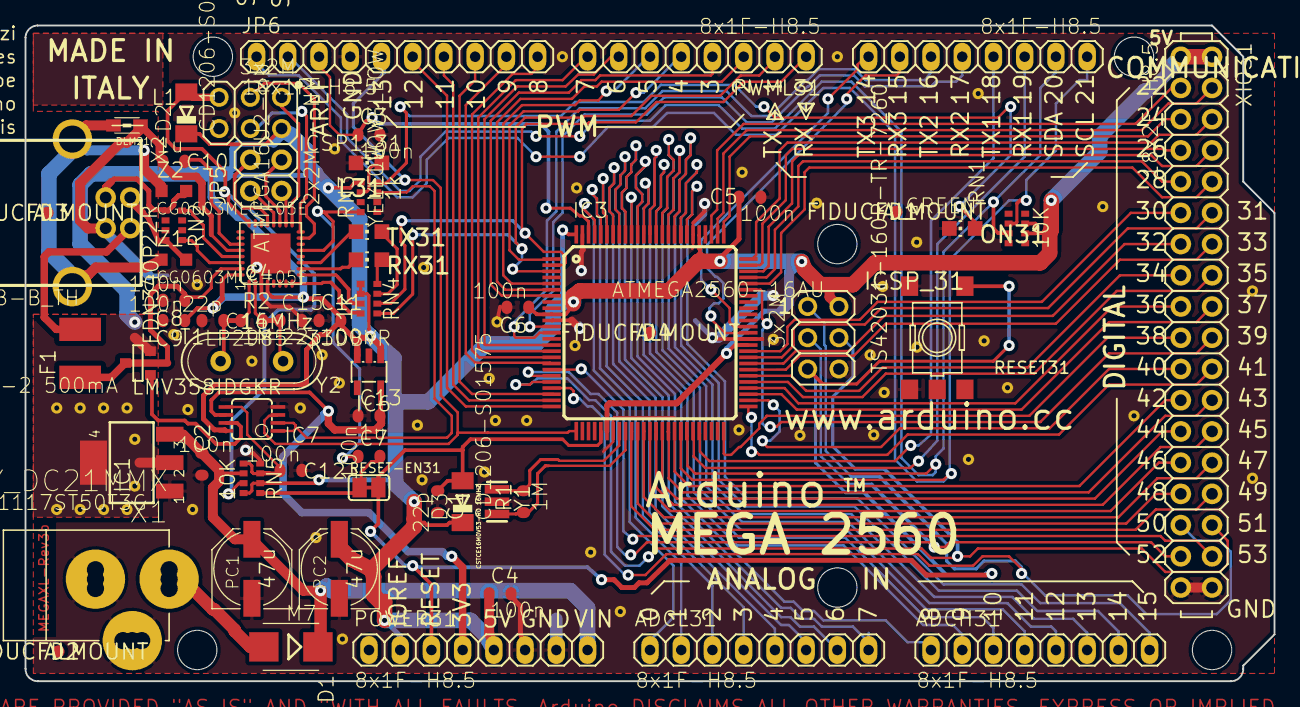
[picture p150: board Arduino_MEGA_2560-Rev3.kicad_pcb from above]

Board: 2 copper layers, 101.6 x 53.3 mm, 69 parts (0 on the bottom side), 110 nets.

Parts:
@HOLE0, @HOLE1, @HOLE2, @HOLE3, @HOLE4, @HOLE5: (no value)
ADCH31: 8x1F-H8.5; 1X08
ADCL31: 8x1F-H8.5; 1X08
C1, C14, C15: 22p; C0603-ROUND
C2, C3, C4, C5, C6, C7, C8, C9, C11, C12: 100n; C0603-ROUND
C10, C13: 1u; C0603-ROUND
COMMUNICATION31: 8x1F-H8.5; 1X08
D1: M7; SMB
D2, D3: CD1206-S01575; MINIMELF
F1: MF-MSMF050-2 500mA; L1812
FD1, FD2, FD3, FD4: FIDUCIALMOUNT; FIDUCIA-MOUNT
GROUND31: SJ
IC1: NCP1117ST50T3G; SOT223
IC3: ATMEGA2560-16AU; TQFP100
IC4: ATMEGA16U2-MU; MLF32
IC6: LP2985-33DBVR; SOT23-DBV
IC7: LMV358IDGKR; MSOP08
ICSP1_31: 3x2M; 2X03
ICSP_31: 3x2M; 2X03
JP5: 2x2M - NM; 2X02
JP6: 10x1F-H8.5; 1X10
L1: BLM21; 0805
L31: YELLOW; CHIP-LED0805
ON31: GREEN; CHIP-LED0805
PC1, PC2: 47u; PANASONIC_D
POWER31: 8x1F-H8.5; 1X08
PWML31: 8x1F-H8.5; 1X08
R1, R2: 1M; R0603-ROUND
RESET31: TS42031-160R-TR-7260; TS42
RESET-EN31: SJ
RN1, RN5: 10K; CAT16
RN2: 22R; CAY16
RN3, RN4: 1k; CAY16
RX31: YELLOW; CHIP-LED0805
T1: FDN340P; SOT-23
TX31: YELLOW; CHIP-LED0805
U$1: DISCLAIMER
X1: POWERSUPPLY_DC21MMX; POWERSUPPLY_DC-21MM
X2: USB-B_TH; PN61729
XIO31: 18x2F-H8.5; 2X18
Y1: CSTCE16M0V53-R0 16MHZ; RESONATOR
Y2: 16MHz; QS
Z1, Z2: CG0603MLC-05E; CT%2fCN0603

Connections:
+3V3: C13.2, IC6.5, IC7.6, POWER31.4
+5V: C4.1, C5.1, C6.1, C9.1, C11.2, D2.C, D3.C, IC1.2, IC1.4, IC3.10, IC3.31, IC3.61, IC3.80, IC3.100, IC4.4, IC4.32, IC6.1, IC6.3, IC7.8, ICSP1_31.2, ICSP_31.2, PC2.+, POWER31.2, POWER31.5, RN1.6, RN1.7, RN3.1, RN4.5, RN4.6, RN5.2, RN5.8, T1.2, XIO31.1, XIO31.2
/8PB4: IC4.18, JP5.1
/8PB5: IC4.19, JP5.3
/8PB6: IC4.20, JP5.2
/8PB7: IC4.21, JP5.4
/ADC0: ADCL31.1, IC3.97
/ADC1: ADCL31.2, IC3.96
/ADC2: ADCL31.3, IC3.95
/ADC3: ADCL31.4, IC3.94
/ADC4: ADCL31.5, IC3.93
/ADC5: ADCL31.6, IC3.92
/ADC6: ADCL31.7, IC3.91
/ADC7: ADCL31.8, IC3.90
/ADC8: ADCH31.1, IC3.89
/ADC9: ADCH31.2, IC3.88
/ADC10: ADCH31.3, IC3.87
/ADC11: ADCH31.4, IC3.86
/ADC12: ADCH31.5, IC3.85
/ADC13: ADCH31.6, IC3.84
/ADC14: ADCH31.7, IC3.83
/ADC15: ADCH31.8, IC3.82
/AREF: C3.1, IC3.98, JP6.3
/CMP: C12.2, IC7.5, RN5.3, RN5.5
/D+: RN2.5, X2.3, Z2.2
/D-: RN2.8, X2.2, Z1.2
/DTR: C7.1, IC4.13, RN3.4
/GATE_CMD: IC7.7, T1.3
/L13: IC7.1, IC7.2, RN3.7
/M8RXD: IC4.9, RN4.7
/M8TXD: IC4.8, RN4.8
/MISO2: IC4.17, ICSP1_31.1
/MOSI2: IC4.16, ICSP1_31.4
/N$2: L31.A, RN3.2
/N$3: ON31.A, RN3.8
/N$54: RN4.4, RX31.A
/N$55: RN4.3, TX31.A
/PA0: IC3.78, XIO31.3
/PA1: IC3.77, XIO31.4
/PA2: IC3.76, XIO31.5
/PA3: IC3.75, XIO31.6
/PA4: IC3.74, XIO31.7
/PA5: IC3.73, XIO31.8
/PA6: IC3.72, XIO31.9
/PA7: IC3.71, XIO31.10
/PB0: IC3.19, XIO31.34
/PB1: IC3.20, ICSP_31.3, XIO31.33
/PB2: IC3.21, ICSP_31.4, XIO31.32
/PB3: IC3.22, ICSP_31.1, XIO31.31
/PB4: IC3.23, JP6.8
/PB5: IC3.24, JP6.7
/PB6: IC3.25, JP6.6
/PB7: IC3.26, IC7.3, JP6.5
/PC0: IC3.53, XIO31.18
/PC1: IC3.54, XIO31.17
/PC2: IC3.55, XIO31.16
/PC3: IC3.56, XIO31.15
/PC4: IC3.57, XIO31.14
/PC5: IC3.58, XIO31.13
/PC6: IC3.59, XIO31.12
/PC7: IC3.60, XIO31.11
/PD7: IC3.50, XIO31.19
/PE0: IC3.2, PWML31.1, RN4.2
/PE1: IC3.3, PWML31.2, RN4.1
/PE3: IC3.5, PWML31.6
/PE4: IC3.6, PWML31.3
/PE5: IC3.7, PWML31.4
/PG0: IC3.51, XIO31.22
/PG1: IC3.52, XIO31.21
/PG2: IC3.70, XIO31.20
/PG5: IC3.1, PWML31.5
/PH3: IC3.15, PWML31.7
/PH4: IC3.16, PWML31.8
/PH5: IC3.17, JP6.10
/PH6: IC3.18, JP6.9
/PL0: IC3.35, XIO31.30
/PL1: IC3.36, XIO31.29
/PL2: IC3.37, XIO31.28
/PL3: IC3.38, XIO31.27
/PL4: IC3.39, XIO31.26
/PL5: IC3.40, XIO31.25
/PL6: IC3.41, XIO31.24
/PL7: IC3.42, XIO31.23
/PWRIN: D1.A, X1.2
/RD+: IC4.29, RN2.4
/RD-: IC4.30, RN2.1
/RESET: C1.1, C7.2, D3.A, IC3.30, ICSP_31.5, POWER31.3, RESET31.3, RESET31.4, RESET-EN31.1, RESET-EN31.2, RN5.1
/RESET2: D2.A, IC4.24, ICSP1_31.5, RN5.7
/RXD1: COMMUNICATION31.3, IC3.45
/RXD2: COMMUNICATION31.5, IC3.12
/RXD3: COMMUNICATION31.7, IC3.63
/RXL: IC4.10, RX31.C
/SCK2: IC4.15, ICSP1_31.3
/SCL: COMMUNICATION31.1, IC3.43, JP6.1, RN1.2
/SDA: COMMUNICATION31.2, IC3.44, JP6.2, RN1.3
/TXD1: COMMUNICATION31.4, IC3.46
/TXD2: COMMUNICATION31.6, IC3.13
/TXD3: COMMUNICATION31.8, IC3.64
/TXL: IC4.11, TX31.C
/UGND: C10.2, GROUND31.1, IC4.28, L1.1, X2.4
/USBVCC: C8.1, F1.1, IC4.31, T1.1
/USHIELD: L1.2, X2.P$1, X2.P$2, Z1.1, Z2.1
/VIN: C2.1, D1.C, IC1.3, PC1.+, POWER31.8, RN5.6
/VUCAP: C10.1, IC4.27
/XT1: C14.1, IC4.1, R2.1, Y2.2
/XT2: C15.1, IC4.2, R2.2, Y2.1
/XTAL1: IC3.34, R1.1, Y1.3
/XTAL2: IC3.33, R1.2, Y1.1
/XVCC: F1.2, X2.1
GND: C1.2, C2.2, C3.2, C4.2, C5.2, C6.2, C8.2, C9.2, C11.1, C12.1, C13.1, C14.2, C15.2, GROUND31.2, IC1.1, IC3.11, IC3.32, IC3.62, IC3.81, IC3.99, IC4.3, IC4.33, IC6.2, IC7.4, ICSP1_31.6, ICSP_31.6, JP6.4, L31.C, ON31.C, PC1.-, PC2.-, POWER31.6, POWER31.7, RESET31.1, RESET31.2, RN3.5, RN5.4, X1.1, X1.3, XIO31.35, XIO31.36, Y1.2
