zoubworldArduino/KiCad_PersoLibrary/(commit log)

2025-12-28 add some
    [1.5in OLED.step, 1x04_RA_SMD.step, 1x05_2.0mm.step, 1x05_2.0mm_SMD_Pin1RightDown.step, 1x05_PTH_2.54mm_8.5mm.step, 1x06_SMD_Pin1RightDown.step, 1x07_2.0mm.step, 1x07_2.0mm_SMD_Pin1RightDown.step]
2025-12-28 add somes
    [ATSAMC21N18A-ANT.step, ATSAMD21J18A-MU.step, MCP2200-I_MQ.step, MCP2200-I_SS.step, MIC39100-3.3WS.step, MicrochipWirelessHardwareDesignChecklist_Rev-B(1).xlsx, MicrochipWirelessHardwareDesignChecklist_Rev-B.xlsx, RN4678-V_RM100.step]
2025-12-28 add all
    [Arduino_MEGA_2560-Rev3.kicad_pcb, Arduino_MEGA_2560-Rev3.sch]
